MTNRS/microduck-v15/fabricacion/LISTA_IMPRESION_V15.csv

id | name | file | material | color | quantity | nozzle_mm | layer_height_mm | perimeters | infill_percent | raft_layers
P01 | V7_MOD_YAW2ROLL | STL_POR_COLORES\NEGRO_PETG\01_V7_MOD_YAW2ROLL.stl | PETG | NEGRO | 1 | 0.4 | 0.2 | 4 | 40 | 0
P02 | V7_MOD_HIP_L | STL_POR_COLORES\NEGRO_PETG\02_V7_MOD_HIP_L.stl | PETG | NEGRO | 1 | 0.4 | 0.2 | 4 | 40 | 0
P03 | V7_MOD_UPPER_LEG_LEFT | STL_POR_COLORES\AZUL_CIELO_PETG\03_V7_MOD_UPPER_LEG_LEFT.stl | PETG | AZUL_CIELO | 1 | 0.4 | 0.2 | 4 | 40 | 0
P04 | V7_MOD_LEG | STL_POR_COLORES\NEGRO_PETG\04_V7_MOD_LEG.stl | PETG | NEGRO | 1 | 0.4 | 0.2 | 4 | 40 | 0
P05 | V7_MOD_ANKLE_LEFT | STL_POR_COLORES\NEGRO_PETG\05_V7_MOD_ANKLE_LEFT.stl | PETG | NEGRO | 1 | 0.4 | 0.2 | 4 | 40 | 0
P06 | V7_MOD_NECK | STL_POR_COLORES\NEGRO_PETG\06_V7_MOD_NECK.stl | PETG | NEGRO | 1 | 0.4 | 0.2 | 4 | 40 | 0
P07 | V7_MOD_NECK_PITCH | STL_POR_COLORES\NEGRO_PETG\07_V7_MOD_NECK_PITCH.stl | PETG | NEGRO | 1 | 0.4 | 0.2 | 4 | 40 | 0
P08 | V7_MOD_YAW_ROLL_MOTION | STL_POR_COLORES\NEGRO_PETG\08_V7_MOD_YAW_ROLL_MOTION.stl | PETG | NEGRO | 1 | 0.4 | 0.2 | 4 | 40 | 0
P09 | V7_MOD_BEARING_ROLL | STL_POR_COLORES\NEGRO_PETG\09_V7_MOD_BEARING_ROLL.stl | PETG | NEGRO | 1 | 0.4 | 0.2 | 4 | 40 | 0
P10 | V7_MOD_HIP_L_2 | STL_POR_COLORES\NEGRO_PETG\10_V7_MOD_HIP_L_2.stl | PETG | NEGRO | 1 | 0.4 | 0.2 | 4 | 40 | 0
P11 | V7_MOD_UPPER_LEG_RIGHT | STL_POR_COLORES\AZUL_CIELO_PETG\11_V7_MOD_UPPER_LEG_RIGHT.stl | PETG | AZUL_CIELO | 1 | 0.4 | 0.2 | 4 | 40 | 0
P12 | V7_MOD_LEG_2 | STL_POR_COLORES\NEGRO_PETG\12_V7_MOD_LEG_2.stl | PETG | NEGRO | 1 | 0.4 | 0.2 | 4 | 40 | 0
P13 | V7_MOD_ANKLE_RIGHT | STL_POR_COLORES\NEGRO_PETG\13_V7_MOD_ANKLE_RIGHT.stl | PETG | NEGRO | 1 | 0.4 | 0.2 | 4 | 40 | 0
P14 | V7_TAPA_BRAZO_00 | STL_POR_COLORES\NEGRO_PETG\14_V7_TAPA_BRAZO_00.stl | PETG | NEGRO | 1 | 0.4 | 0.2 | 4 | 40 | 0
P15 | V7_TAPA_BRAZO_01 | STL_POR_COLORES\NEGRO_PETG\15_V7_TAPA_BRAZO_01.stl | PETG | NEGRO | 1 | 0.4 | 0.2 | 4 | 40 | 0
P16 | V7_TAPA_BRAZO_02 | STL_POR_COLORES\NEGRO_PETG\16_V7_TAPA_BRAZO_02.stl | PETG | NEGRO | 1 | 0.4 | 0.2 | 4 | 40 | 0
P17 | V7_TAPA_BRAZO_03 | STL_POR_COLORES\NEGRO_PETG\17_V7_TAPA_BRAZO_03.stl | PETG | NEGRO | 1 | 0.4 | 0.2 | 4 | 40 | 0
P18 | V7_TAPA_BRAZO_04 | STL_POR_COLORES\NEGRO_PETG\18_V7_TAPA_BRAZO_04.stl | PETG | NEGRO | 1 | 0.4 | 0.2 | 4 | 40 | 0
P19 | V7_TAPA_BRAZO_05 | STL_POR_COLORES\NEGRO_PETG\19_V7_TAPA_BRAZO_05.stl | PETG | NEGRO | 1 | 0.4 | 0.2 | 4 | 40 | 0
P20 | V7_TAPA_BRAZO_06 | STL_POR_COLORES\AZUL_CIELO_PETG\20_V7_TAPA_BRAZO_06.stl | PETG | AZUL_CIELO | 1 | 0.4 | 0.2 | 4 | 40 | 0
P21 | V7_TAPA_BRAZO_07 | STL_POR_COLORES\NEGRO_PETG\21_V7_TAPA_BRAZO_07.stl | PETG | NEGRO | 1 | 0.4 | 0.2 | 4 | 40 | 0
P22 | V7_TAPA_BRAZO_08 | STL_POR_COLORES\NEGRO_PETG\22_V7_TAPA_BRAZO_08.stl | PETG | NEGRO | 1 | 0.4 | 0.2 | 4 | 40 | 0
P23 | V7_TAPA_BRAZO_10 | STL_POR_COLORES\NEGRO_PETG\23_V7_TAPA_BRAZO_10.stl | PETG | NEGRO | 1 | 0.4 | 0.2 | 4 | 40 | 0
P24 | V7_TAPA_BRAZO_11 | STL_POR_COLORES\NEGRO_PETG\24_V7_TAPA_BRAZO_11.stl | PETG | NEGRO | 1 | 0.4 | 0.2 | 4 | 40 | 0
P25 | V7_TAPA_BRAZO_12 | STL_POR_COLORES\NEGRO_PETG\25_V7_TAPA_BRAZO_12.stl | PETG | NEGRO | 1 | 0.4 | 0.2 | 4 | 40 | 0
P26 | V7_TAPA_BRAZO_13 | STL_POR_COLORES\NEGRO_PETG\26_V7_TAPA_BRAZO_13.stl | PETG | NEGRO | 1 | 0.4 | 0.2 | 4 | 40 | 0
P27 | V7_TAPA_BRAZO_14 | STL_POR_COLORES\NEGRO_PETG\27_V7_TAPA_BRAZO_14.stl | PETG | NEGRO | 1 | 0.4 | 0.2 | 4 | 40 | 0
P28 | V7_TAPA_RODAMIENTO_CUELLO | STL_POR_COLORES\AZUL_CIELO_PETG\28_V7_TAPA_RODAMIENTO_CUELLO.stl | PETG | AZUL_CIELO | 1 | 0.4 | 0.2 | 4 | 40 | 0
P29 | V7_SEPARADOR_EJE_CUELLO | STL_POR_COLORES\NEGRO_PETG\29_V7_SEPARADOR_EJE_CUELLO.stl | PETG | NEGRO | 1 | 0.4 | 0.2 | 4 | 40 | 0
P30 | V7_RETENEDOR_PASIVO_HEADROLL | STL_POR_COLORES\NEGRO_PETG\30_V7_RETENEDOR_PASIVO_HEADROLL.stl | PETG | NEGRO | 1 | 0.4 | 0.2 | 4 | 40 | 0
P31 | V7_RETENEDOR_PASIVO_TOBILLO_05 | STL_POR_COLORES\NEGRO_PETG\31_V7_RETENEDOR_PASIVO_TOBILLO_05.stl | PETG | NEGRO | 1 | 0.4 | 0.2 | 4 | 40 | 0
P32 | V7_RETENEDOR_PASIVO_TOBILLO_14 | STL_POR_COLORES\NEGRO_PETG\32_V7_RETENEDOR_PASIVO_TOBILLO_14.stl | PETG | NEGRO | 1 | 0.4 | 0.2 | 4 | 40 | 0
P33 | V7_HEAD_TOP_ANCLADO | STL_POR_COLORES\AZUL_CIELO_PETG\33_V7_HEAD_TOP_ANCLADO.stl | PETG | AZUL_CIELO | 1 | 0.4 | 0.2 | 4 | 40 | 0
P34 | V7_HEAD_LOWER_ANCLADO | STL_POR_COLORES\NARANJA_PETG\34_V7_HEAD_LOWER_ANCLADO.stl | PETG | NARANJA | 1 | 0.4 | 0.2 | 4 | 40 | 0
P35 | V7_HEAD_FACE_ANCLADO | STL_POR_COLORES\GRIS_PETG\35_V7_HEAD_FACE_ANCLADO.stl | PETG | GRIS | 1 | 0.4 | 0.2 | 4 | 40 | 0
P36 | V7_HEAD_JAW_FIJO | STL_POR_COLORES\NARANJA_PETG\36_V7_HEAD_JAW_FIJO.stl | PETG | NARANJA | 1 | 0.4 | 0.2 | 4 | 40 | 0
P37 | V7_HEADCORE_ANCLADO | STL_POR_COLORES\NEGRO_PETG\37_V7_HEADCORE_ANCLADO.stl | PETG | NEGRO | 1 | 0.4 | 0.2 | 4 | 40 | 0
P38 | V7_HEAD_LIP_LOWER_RELIEVED | STL_POR_COLORES\NARANJA_TPU95A\38_V7_HEAD_LIP_LOWER_RELIEVED.stl | TPU95A | NARANJA | 1 | 0.4 | 0.2 | 3 | 20 | 0
P39 | V7_HEAD_LIP_UPPER_RELIEVED | STL_POR_COLORES\NARANJA_TPU95A\39_V7_HEAD_LIP_UPPER_RELIEVED.stl | TPU95A | NARANJA | 1 | 0.4 | 0.2 | 3 | 20 | 0
P40 | V7_EYE_RING_CLEARANCED | STL_POR_COLORES\AMARILLO_PETG\40_V7_EYE_RING_CLEARANCED.stl | PETG | AMARILLO | 1 | 0.4 | 0.2 | 4 | 40 | 0
P41 | V7_SRC_V4_MD_ankle_left__sole_left | STL_POR_COLORES\NEGRO_TPU_95A\41_V7_SRC_V4_MD_ankle_left__sole_left.stl | TPU_95A | NEGRO | 1 | 0.4 | 0.2 | 3 | 20 | 0
P42 | V7_SRC_V4_MD_ankle_right__sole_right | STL_POR_COLORES\NEGRO_TPU_95A\42_V7_SRC_V4_MD_ankle_right__sole_right.stl | TPU_95A | NEGRO | 1 | 0.4 | 0.2 | 3 | 20 | 0
P43 | V7_SRC_V5_PI_ZERO_BANDEJA_CON_ANCLAJES | STL_POR_COLORES\NEGRO_PETG\43_V7_SRC_V5_PI_ZERO_BANDEJA_CON_ANCLAJES.stl | PETG | NEGRO | 1 | 0.4 | 0.2 | 4 | 40 | 0
P44 | 12CASE_TORSO_CONTINUO | STL_POR_COLORES\AZUL_CIELO_PETG\44_12CASE_TORSO_CONTINUO.stl | PETG | AZUL_CIELO | 1 | 0.4 | 0.2 | 4 | 40 | 0
P45 | 12CASE_TAPA_TRASERA_ENRASADA | STL_POR_COLORES\AZUL_CIELO_PETG\45_12CASE_TAPA_TRASERA_ENRASADA.stl | PETG | AZUL_CIELO | 1 | 0.4 | 0.2 | 4 | 40 | 3
P46 | V15_SERVICE_FRONT_YAW2ROLL | STL_POR_COLORES\NEGRO_PETG\46_V15_SERVICE_FRONT_YAW2ROLL.stl | PETG | NEGRO | 1 | 0.4 | 0.2 | 4 | 40 | 0
P47 | V15_SERVICE_FRONT_UPPER_LEG_LEFT_0 | STL_POR_COLORES\AZUL_CIELO_PETG\47_V15_SERVICE_FRONT_UPPER_LEG_LEFT_0.stl | PETG | AZUL_CIELO | 1 | 0.4 | 0.2 | 4 | 40 | 0
P48 | V15_SERVICE_FRONT_YAW_ROLL_MOTION_0 | STL_POR_COLORES\NEGRO_PETG\48_V15_SERVICE_FRONT_YAW_ROLL_MOTION_0.stl | PETG | NEGRO | 1 | 0.4 | 0.2 | 4 | 40 | 0
P49 | V15_SERVICE_FRONT_JAW_SOFT | STL_POR_COLORES\NEGRO_PETG\49_V15_SERVICE_FRONT_JAW_SOFT.stl | PETG | NEGRO | 1 | 0.4 | 0.2 | 4 | 40 | 0
P50 | V15_SERVICE_FRONT_BEARING_ROLL | STL_POR_COLORES\NEGRO_PETG\50_V15_SERVICE_FRONT_BEARING_ROLL.stl | PETG | NEGRO | 1 | 0.4 | 0.2 | 4 | 40 | 0
P51 | V15_SERVICE_FRONT_UPPER_LEG_RIGHT_0 | STL_POR_COLORES\AZUL_CIELO_PETG\51_V15_SERVICE_FRONT_UPPER_LEG_RIGHT_0.stl | PETG | AZUL_CIELO | 1 | 0.4 | 0.2 | 4 | 40 | 0
P52 | V15_SERVICE_FRONT_TRUNK_BASE_0 | STL_POR_COLORES\AZUL_CIELO_PETG\52_V15_SERVICE_FRONT_TRUNK_BASE_0.stl | PETG | AZUL_CIELO | 1 | 0.4 | 0.2 | 4 | 40 | 0
P53 | V15_SERVICE_FRONT_TRUNK_BASE_1 | STL_POR_COLORES\AZUL_CIELO_PETG\53_V15_SERVICE_FRONT_TRUNK_BASE_1.stl | PETG | AZUL_CIELO | 1 | 0.4 | 0.2 | 4 | 40 | 0
P54 | V15_OJO_CIEGO_IMPRIMIBLE | STL_POR_COLORES\NEGRO_PETG\54_V15_OJO_CIEGO_IMPRIMIBLE.stl | PETG | NEGRO | 1 | 0.4 | 0.2 | 4 | 40 | 0
P55 | V15_FOOT_L_HEEL_ACTUADOR | STL_POR_COLORES\NEGRO_PETG\55_V15_FOOT_L_HEEL_ACTUADOR.stl | PETG | NEGRO | 1 | 0.4 | 0.2 | 4 | 40 | 0
P56 | V15_FOOT_L_TOE_ACTUADOR | STL_POR_COLORES\NEGRO_PETG\56_V15_FOOT_L_TOE_ACTUADOR.stl | PETG | NEGRO | 1 | 0.4 | 0.2 | 4 | 40 | 0
P57 | V15_FOOT_R_HEEL_ACTUADOR | STL_POR_COLORES\NEGRO_PETG\57_V15_FOOT_R_HEEL_ACTUADOR.stl | PETG | NEGRO | 1 | 0.4 | 0.2 | 4 | 40 | 0
P58 | V15_FOOT_R_TOE_ACTUADOR | STL_POR_COLORES\NEGRO_PETG\58_V15_FOOT_R_TOE_ACTUADOR.stl | PETG | NEGRO | 1 | 0.4 | 0.2 | 4 | 40 | 0
P59 | V15_FOOT_L_TAPA_CIRCUITO | STL_POR_COLORES\NEGRO_PETG\59_V15_FOOT_L_TAPA_CIRCUITO.stl | PETG | NEGRO | 1 | 0.4 | 0.2 | 4 | 40 | 0
P60 | V15_FOOT_R_TAPA_CIRCUITO | STL_POR_COLORES\NEGRO_PETG\60_V15_FOOT_R_TAPA_CIRCUITO.stl | PETG | NEGRO | 1 | 0.4 | 0.2 | 4 | 40 | 0
P61 | V15_K10_RETEN_DESMONTABLE | STL_POR_COLORES\NEGRO_PETG\61_V15_K10_RETEN_DESMONTABLE.stl | PETG | NEGRO | 1 | 0.4 | 0.2 | 4 | 40 | 0
P62 | V15_PCM_TOPE_DESMONTABLE | STL_POR_COLORES\NEGRO_PETG\62_V15_PCM_TOPE_DESMONTABLE.stl | PETG | NEGRO | 1 | 0.4 | 0.2 | 4 | 40 | 0
P63 | V15_REED_TAPA_PROTECTORA | STL_POR_COLORES\NEGRO_PETG\63_V15_REED_TAPA_PROTECTORA.stl | PETG | NEGRO | 1 | 0.4 | 0.2 | 4 | 40 | 0
P64 | V15_ADC_CARRIER_DESMONTABLE | STL_POR_COLORES\NEGRO_PETG\64_V15_ADC_CARRIER_DESMONTABLE.stl | PETG | NEGRO | 1 | 0.4 | 0.2 | 4 | 40 | 0
P65 | V15_D24_BANDEJA_INFERIOR_DESMONTABLE | STL_POR_COLORES\AZUL_CIELO_PETG\65_V15_D24_BANDEJA_INFERIOR_DESMONTABLE.stl | PETG | AZUL_CIELO | 1 | 0.4 | 0.2 | 4 | 40 | 3
P66 | V15_BM_FR4_CAP_R2 | STL_POR_COLORES\NEGRO_PETG\66_V15_BM_FR4_CAP_R2.stl | PETG | NEGRO | 1 | 0.4 | 0.2 | 4 | 40 | 0
P67 | V15_BM_FR4_KEY_R2 | STL_POR_COLORES\NEGRO_PETG\67_V15_BM_FR4_KEY_R2.stl | PETG | NEGRO | 1 | 0.4 | 0.2 | 4 | 40 | 0
P68 | V15_PCM_TOPE_DESMONTABLE_DERECHO | STL_POR_COLORES\NEGRO_PETG\68_V15_PCM_TOPE_DESMONTABLE_DERECHO.stl | PETG | NEGRO | 1 | 0.4 | 0.2 | 4 | 40 | 0
P69 | V15_HEADROLL_CHEEK_DESMONTABLE | STL_POR_COLORES\NEGRO_PETG\69_V15_HEADROLL_CHEEK_DESMONTABLE.stl | PETG | NEGRO | 1 | 0.4 | 0.2 | 4 | 40 | 0
P70 | V15_ET_RADIAL_CLAMP_00F | STL_POR_COLORES\NEGRO_PETG\70_V15_ET_RADIAL_CLAMP_00F.stl | PETG | NEGRO | 1 | 0.4 | 0.2 | 4 | 40 | 0
P71 | V15_ET_RADIAL_CLAMP_01F | STL_POR_COLORES\NEGRO_PETG\71_V15_ET_RADIAL_CLAMP_01F.stl | PETG | NEGRO | 1 | 0.4 | 0.2 | 4 | 40 | 0
P72 | V15_ET_RADIAL_CLAMP_02F | STL_POR_COLORES\NEGRO_PETG\72_V15_ET_RADIAL_CLAMP_02F.stl | PETG | NEGRO | 1 | 0.4 | 0.2 | 4 | 40 | 0
P73 | V15_ET_RADIAL_CLAMP_03F | STL_POR_COLORES\NEGRO_PETG\73_V15_ET_RADIAL_CLAMP_03F.stl | PETG | NEGRO | 1 | 0.4 | 0.2 | 4 | 40 | 0
P74 | V15_ET_RADIAL_CLAMP_11F | STL_POR_COLORES\NEGRO_PETG\74_V15_ET_RADIAL_CLAMP_11F.stl | PETG | NEGRO | 1 | 0.4 | 0.2 | 4 | 40 | 0
P75 | V15_ET_RADIAL_CLAMP_12F | STL_POR_COLORES\NEGRO_PETG\75_V15_ET_RADIAL_CLAMP_12F.stl | PETG | NEGRO | 1 | 0.4 | 0.2 | 4 | 40 | 0
P76 | V15_ET_RADIAL_CLAMP_04F | STL_POR_COLORES\NEGRO_PETG\76_V15_ET_RADIAL_CLAMP_04F.stl | PETG | NEGRO | 1 | 0.4 | 0.2 | 4 | 40 | 0
P77 | V15_ET_RADIAL_CLAMP_10F | STL_POR_COLORES\NEGRO_PETG\77_V15_ET_RADIAL_CLAMP_10F.stl | PETG | NEGRO | 1 | 0.4 | 0.2 | 4 | 40 | 0
P78 | V15_ET_RADIAL_CLAMP_13F | STL_POR_COLORES\NEGRO_PETG\78_V15_ET_RADIAL_CLAMP_13F.stl | PETG | NEGRO | 1 | 0.4 | 0.2 | 4 | 40 | 0
P79 | V15_ET_RADIAL_CLAMP_08F | STL_POR_COLORES\NEGRO_PETG\79_V15_ET_RADIAL_CLAMP_08F.stl | PETG | NEGRO | 1 | 0.4 | 0.2 | 4 | 40 | 0
P80 | V15_6701_RADIAL_CLAMP_10R | STL_POR_COLORES\NEGRO_PETG\80_V15_6701_RADIAL_CLAMP_10R.stl | PETG | NEGRO | 1 | 0.4 | 0.2 | 4 | 40 | 0
