MTNRS/microduck-v15/fabricacion/DOCUMENTACION/TORNILLERIA/TORNILLERIA_FUENTE_A_CONTENIDO_V15.csv

source_name | source_sha256 | category | item | quantity | dimensions_or_limit | preparation | source_url | supplier_status
V12_HW_CASE_CLOSURE_00 | 99711498d1d0ec2f1643ecb6f8c0d19c25be85364ed06c2158a1b49698067734 | SCREW | M2x25 | 1 | headOD<=4 h<=1.6 |  |  | Especificacion dimensional; proveedor por confirmar
V12_HW_CASE_CLOSURE_00 | 99711498d1d0ec2f1643ecb6f8c0d19c25be85364ed06c2158a1b49698067734 | NUT | M2 AF4 h1.6 | 1 |  |  |  | Especificacion dimensional; proveedor por confirmar
V12_HW_CASE_CLOSURE_00 | 99711498d1d0ec2f1643ecb6f8c0d19c25be85364ed06c2158a1b49698067734 | WASHER | OD4.3 ID2.2 h0.3 | 1 |  |  |  | Especificacion dimensional; proveedor por confirmar
V12_HW_CASE_CLOSURE_01 | af7fb67f0b9e2c49c6317c66d189983a6ab191507d181d2a0959832b0bed2678 | SCREW | M2x25 | 1 | headOD<=4 h<=1.6 |  |  | Especificacion dimensional; proveedor por confirmar
V12_HW_CASE_CLOSURE_01 | af7fb67f0b9e2c49c6317c66d189983a6ab191507d181d2a0959832b0bed2678 | NUT | M2 AF4 h1.6 | 1 |  |  |  | Especificacion dimensional; proveedor por confirmar
V12_HW_CASE_CLOSURE_01 | af7fb67f0b9e2c49c6317c66d189983a6ab191507d181d2a0959832b0bed2678 | WASHER | OD4.3 ID2.2 h0.3 | 1 |  |  |  | Especificacion dimensional; proveedor por confirmar
V12_HW_CASE_CLOSURE_02 | 3b68d0e60894e7b5ef612ba7a495937365d09641602007265e7909e895bd9539 | SCREW | M2x25 | 1 | headOD<=4 h<=1.6 |  |  | Especificacion dimensional; proveedor por confirmar
V12_HW_CASE_CLOSURE_02 | 3b68d0e60894e7b5ef612ba7a495937365d09641602007265e7909e895bd9539 | NUT | M2 AF4 h1.6 | 1 |  |  |  | Especificacion dimensional; proveedor por confirmar
V12_HW_CASE_CLOSURE_02 | 3b68d0e60894e7b5ef612ba7a495937365d09641602007265e7909e895bd9539 | WASHER | OD4.3 ID2.2 h0.3 | 1 |  |  |  | Especificacion dimensional; proveedor por confirmar
V12_HW_CASE_CLOSURE_03 | faebaa76a23396d1173fec0bf9c24cd7a66a93c2123987e66e0dad0f900eec77 | SCREW | M2x25 | 1 | headOD<=4 h<=1.6 |  |  | Especificacion dimensional; proveedor por confirmar
V12_HW_CASE_CLOSURE_03 | faebaa76a23396d1173fec0bf9c24cd7a66a93c2123987e66e0dad0f900eec77 | NUT | M2 AF4 h1.6 | 1 |  |  |  | Especificacion dimensional; proveedor por confirmar
V12_HW_CASE_CLOSURE_03 | faebaa76a23396d1173fec0bf9c24cd7a66a93c2123987e66e0dad0f900eec77 | WASHER | OD4.3 ID2.2 h0.3 | 1 |  |  |  | Especificacion dimensional; proveedor por confirmar
V15_EYE_REAR_NUT_0 | dee2fe31ff005fafb51f0c66a1e8032b57aa39dae5ab1d344c9b9d4c7d3fa99a | NUT | M2 AF4 h1.6 | 1 |  |  |  | Especificacion dimensional; proveedor por confirmar
V15_EYE_REAR_NUT_1 | 38273af5bb4fc0129a6dbf5738df33770433eac7903097706e2a3bc93b06103d | NUT | M2 AF4 h1.6 | 1 |  |  |  | Especificacion dimensional; proveedor por confirmar
V15_EYE_REAR_WASHER_0 | 1af8188889be748cda065a39434545f6e7d99c5c5cf95599802ff84af8a7ea80 | WASHER | OD5 ID2.2 h0.3 | 1 |  |  |  | Especificacion dimensional; proveedor por confirmar
V15_EYE_REAR_WASHER_1 | 20814c5789e996e1f587ed0d741dcf3acefdfc7ae92479f8826aaa95bc5e8d6a | WASHER | OD5 ID2.2 h0.3 | 1 |  |  |  | Especificacion dimensional; proveedor por confirmar
V15_HW_6701CLAMP_10R_0_M2x11_ASSY | d43dac42ab0dfc2bf1aad3175ecb1b4b45de01b0605848ae4bce871ecacb86dd | SCREW | M2x11 | 1 | M2x11 socket screw prepared from12; {"length_under_head_mm": 11.0, "head_diameter_max_mm": 4.0, "head_height_max_mm": 2.0} | Cut standard M2x12 under-head length to11.0mm; deburr |  | Especificacion dimensional; proveedor por confirmar
V15_HW_6701CLAMP_10R_0_M2x11_ASSY | d43dac42ab0dfc2bf1aad3175ecb1b4b45de01b0605848ae4bce871ecacb86dd | NUT | M2 AF4 h1.6 | 1 | M2 nut AF4 h1.6 |  |  | Especificacion dimensional; proveedor por confirmar
V15_HW_6701CLAMP_10R_0_M2x11_ASSY | d43dac42ab0dfc2bf1aad3175ecb1b4b45de01b0605848ae4bce871ecacb86dd | WASHER | washer OD4.3 ID2.2 h0.3 | 2 | washer OD4.3 ID2.2 h0.3 |  |  | Especificacion dimensional; proveedor por confirmar
V15_HW_6701CLAMP_10R_1_M2x11_ASSY | 3588c896a5987c8674ec75a3de937ec692060b0b67d68f3eb6dcb934a01b1a71 | SCREW | M2x11 | 1 | M2x11 socket screw prepared from12; {"length_under_head_mm": 11.0, "head_diameter_max_mm": 4.0, "head_height_max_mm": 2.0} | Cut standard M2x12 under-head length to11.0mm; deburr |  | Especificacion dimensional; proveedor por confirmar
V15_HW_6701CLAMP_10R_1_M2x11_ASSY | 3588c896a5987c8674ec75a3de937ec692060b0b67d68f3eb6dcb934a01b1a71 | NUT | M2 AF4 h1.6 | 1 | M2 nut AF4 h1.6 |  |  | Especificacion dimensional; proveedor por confirmar
V15_HW_6701CLAMP_10R_1_M2x11_ASSY | 3588c896a5987c8674ec75a3de937ec692060b0b67d68f3eb6dcb934a01b1a71 | WASHER | washer OD4.3 ID2.2 h0.3 | 2 | washer OD4.3 ID2.2 h0.3 |  |  | Especificacion dimensional; proveedor por confirmar
V15_HW_ADC_DRIVER_M2x8_0 | 4ad36503498866e5c3c151920923b36549453d797130513ded3ffc2ee87abdb4 | SCREW | M2x8 | 1 | screw_M2x8; {} |  |  | Especificacion dimensional; proveedor por confirmar
V15_HW_ADC_DRIVER_M2x8_0 | 4ad36503498866e5c3c151920923b36549453d797130513ded3ffc2ee87abdb4 | NUT | M2 AF4 h1.6 | 1 | nut_M2_AF4_h1p6 |  |  | Especificacion dimensional; proveedor por confirmar
V15_HW_ADC_DRIVER_M2x8_0 | 4ad36503498866e5c3c151920923b36549453d797130513ded3ffc2ee87abdb4 | WASHER | washer_OD4p3_ID2p15_h0p3 | 2 | washer_OD4p3_ID2p15_h0p3 |  |  | Especificacion dimensional; proveedor por confirmar
V15_HW_ADC_DRIVER_M2x8_1 | 78cd083028ad7ab88daa2c4de93f7a33d6a8a5ef2d291bd6fd9768db07503348 | SCREW | M2x8 | 1 | screw_M2x8; {} |  |  | Especificacion dimensional; proveedor por confirmar
V15_HW_ADC_DRIVER_M2x8_1 | 78cd083028ad7ab88daa2c4de93f7a33d6a8a5ef2d291bd6fd9768db07503348 | NUT | M2 AF4 h1.6 | 1 | nut_M2_AF4_h1p6 |  |  | Especificacion dimensional; proveedor por confirmar
V15_HW_ADC_DRIVER_M2x8_1 | 78cd083028ad7ab88daa2c4de93f7a33d6a8a5ef2d291bd6fd9768db07503348 | WASHER | washer_OD4p3_ID2p15_h0p3 | 2 | washer_OD4p3_ID2p15_h0p3 |  |  | Especificacion dimensional; proveedor por confirmar
V15_HW_ADS1115_M2x8_0 | b7052d4a2be9136f5405446d81c69447e06e9b821af865a3a60d93197827851a | SCREW | M2x8 | 1 | screw_M2x8; {} |  |  | Especificacion dimensional; proveedor por confirmar
V15_HW_ADS1115_M2x8_0 | b7052d4a2be9136f5405446d81c69447e06e9b821af865a3a60d93197827851a | NUT | M2 AF4 h1.6 | 1 | nut_M2_AF4_h1p6 |  |  | Especificacion dimensional; proveedor por confirmar
V15_HW_ADS1115_M2x8_0 | b7052d4a2be9136f5405446d81c69447e06e9b821af865a3a60d93197827851a | WASHER | washer_OD4p3_ID2p15_h0p3 | 2 | washer_OD4p3_ID2p15_h0p3 |  |  | Especificacion dimensional; proveedor por confirmar
V15_HW_ADS1115_M2x8_1 | c43fdcf8429e1ff2673f1dc3de76c79952d6ea01775f0f1a9c810fda1bd8cf55 | SCREW | M2x8 | 1 | screw_M2x8; {} |  |  | Especificacion dimensional; proveedor por confirmar
V15_HW_ADS1115_M2x8_1 | c43fdcf8429e1ff2673f1dc3de76c79952d6ea01775f0f1a9c810fda1bd8cf55 | NUT | M2 AF4 h1.6 | 1 | nut_M2_AF4_h1p6 |  |  | Especificacion dimensional; proveedor por confirmar
V15_HW_ADS1115_M2x8_1 | c43fdcf8429e1ff2673f1dc3de76c79952d6ea01775f0f1a9c810fda1bd8cf55 | WASHER | washer_OD4p3_ID2p15_h0p3 | 2 | washer_OD4p3_ID2p15_h0p3 |  |  | Especificacion dimensional; proveedor por confirmar
V15_HW_ADS1115_M2x8_2 | 3b7055ec348e3a38d85cc0c97c13ffb01ab8fa2f7a6fd52f622e26709b38d1d5 | SCREW | M2x8 | 1 | screw_M2x8_head_OD_le4_h_le1p6; {} |  |  | Especificacion dimensional; proveedor por confirmar
V15_HW_ADS1115_M2x8_2 | 3b7055ec348e3a38d85cc0c97c13ffb01ab8fa2f7a6fd52f622e26709b38d1d5 | NUT | M2 AF4 h1.6 | 1 | nut_M2_AF4_h1p6 |  |  | Especificacion dimensional; proveedor por confirmar
V15_HW_ADS1115_M2x8_2 | 3b7055ec348e3a38d85cc0c97c13ffb01ab8fa2f7a6fd52f622e26709b38d1d5 | WASHER | washer_OD4p3_ID2p15_h0p3 | 2 | washer_OD4p3_ID2p15_h0p3 |  |  | Especificacion dimensional; proveedor por confirmar
V15_HW_ADS1115_M2x8_3 | 27ee051498474f6f9055bbcbf377fb60797b7db1c456934812d646d9b211e61d | SCREW | M2x8 | 1 | screw_M2x8_head_OD_le4_h_le1p6; {} |  |  | Especificacion dimensional; proveedor por confirmar
V15_HW_ADS1115_M2x8_3 | 27ee051498474f6f9055bbcbf377fb60797b7db1c456934812d646d9b211e61d | NUT | M2 AF4 h1.6 | 1 | nut_M2_AF4_h1p6 |  |  | Especificacion dimensional; proveedor por confirmar
V15_HW_ADS1115_M2x8_3 | 27ee051498474f6f9055bbcbf377fb60797b7db1c456934812d646d9b211e61d | WASHER | washer_OD4p3_ID2p15_h0p3 | 2 | washer_OD4p3_ID2p15_h0p3 |  |  | Especificacion dimensional; proveedor por confirmar
V15_HW_BM_SSH_M2x8 | f6d4c1873d0f9b2c060119eb2b3d3f9fc6d3aaccc9b95bfb9878e19febd86cb3 | SCREW | M2x8 NBK SSH-M2-8 | 1 | SSH-M2-8; {"head_D_mm": 4.0, "head_H_mm": 1.1, "underhead_length_mm": 8.0} |  |  | Especificacion dimensional; proveedor por confirmar
V15_HW_BM_SSH_M2x8 | f6d4c1873d0f9b2c060119eb2b3d3f9fc6d3aaccc9b95bfb9878e19febd86cb3 | NUT | M2 AF4 h1.6 | 1 | M2nutAF4h1.6 |  |  | Especificacion dimensional; proveedor por confirmar
V15_HW_BM_SSH_M2x8 | f6d4c1873d0f9b2c060119eb2b3d3f9fc6d3aaccc9b95bfb9878e19febd86cb3 | WASHER | M2washerOD4.3h0.3 | 1 | M2washerOD4.3h0.3 |  |  | Especificacion dimensional; proveedor por confirmar
V15_HW_D24_TRAY_M2x8_0 | 17b1ea9cd0454ac9f3d517c0f519e9c5bf474bf7fc592b52e76880b0bc932b6b | SCREW | M2x8 | 1 | screw_M2x8_head_OD_le4_h_le1p6; {} |  |  | Especificacion dimensional; proveedor por confirmar
V15_HW_D24_TRAY_M2x8_0 | 17b1ea9cd0454ac9f3d517c0f519e9c5bf474bf7fc592b52e76880b0bc932b6b | NUT | M2 AF4 h1.6 | 1 | nut_M2_AF4_h1p6 |  |  | Especificacion dimensional; proveedor por confirmar
V15_HW_D24_TRAY_M2x8_0 | 17b1ea9cd0454ac9f3d517c0f519e9c5bf474bf7fc592b52e76880b0bc932b6b | WASHER | washer_OD4p3_ID2p15_h0p3 | 2 | washer_OD4p3_ID2p15_h0p3 |  |  | Especificacion dimensional; proveedor por confirmar
V15_HW_D24_TRAY_M2x8_1 | 871f68428ef170aa3eaffbda0f7851f54b3247b8063505e0596c0155b72ac00d | SCREW | M2x8 | 1 | screw_M2x8_head_OD_le4_h_le1p6; {} |  |  | Especificacion dimensional; proveedor por confirmar
V15_HW_D24_TRAY_M2x8_1 | 871f68428ef170aa3eaffbda0f7851f54b3247b8063505e0596c0155b72ac00d | NUT | M2 AF4 h1.6 | 1 | nut_M2_AF4_h1p6 |  |  | Especificacion dimensional; proveedor por confirmar
V15_HW_D24_TRAY_M2x8_1 | 871f68428ef170aa3eaffbda0f7851f54b3247b8063505e0596c0155b72ac00d | WASHER | washer_OD4p3_ID2p15_h0p3 | 2 | washer_OD4p3_ID2p15_h0p3 |  |  | Especificacion dimensional; proveedor por confirmar
V15_HW_ETCLAMP_00F_0_M2x12_ASSY | 39260ac4edff9109a84b04794623c0ed39cce0df2493d0fb8c8d56f748648fdb | SCREW | M2x12 | 1 | M2x12 socket screw; {"length_under_head_mm": 12.0, "head_diameter_max_mm": 4.0, "head_height_max_mm": 2.0} |  |  | Especificacion dimensional; proveedor por confirmar
V15_HW_ETCLAMP_00F_0_M2x12_ASSY | 39260ac4edff9109a84b04794623c0ed39cce0df2493d0fb8c8d56f748648fdb | NUT | M2 AF4 h1.6 | 1 | M2 nut AF4 h1.6 |  |  | Especificacion dimensional; proveedor por confirmar
V15_HW_ETCLAMP_00F_0_M2x12_ASSY | 39260ac4edff9109a84b04794623c0ed39cce0df2493d0fb8c8d56f748648fdb | WASHER | washer OD4.3 ID2.2 h0.3 | 2 | washer OD4.3 ID2.2 h0.3 |  |  | Especificacion dimensional; proveedor por confirmar
V15_HW_ETCLAMP_00F_1_M2x12_ASSY | 818e418a1a510cc406979d2e37767ff3640f5f86982fe2d03286a5cd40b34333 | SCREW | M2x12 | 1 | M2x12 socket screw; {"length_under_head_mm": 12.0, "head_diameter_max_mm": 4.0, "head_height_max_mm": 2.0} |  |  | Especificacion dimensional; proveedor por confirmar
V15_HW_ETCLAMP_00F_1_M2x12_ASSY | 818e418a1a510cc406979d2e37767ff3640f5f86982fe2d03286a5cd40b34333 | NUT | M2 AF4 h1.6 | 1 | M2 nut AF4 h1.6 |  |  | Especificacion dimensional; proveedor por confirmar
V15_HW_ETCLAMP_00F_1_M2x12_ASSY | 818e418a1a510cc406979d2e37767ff3640f5f86982fe2d03286a5cd40b34333 | WASHER | washer OD4.3 ID2.2 h0.3 | 2 | washer OD4.3 ID2.2 h0.3 |  |  | Especificacion dimensional; proveedor por confirmar
V15_HW_ETCLAMP_01F_0_M2x12_ASSY | 0853021ca96cc0146a58bc4b6a8089d2dc9e22725493cd842dec1718d441b475 | SCREW | M2x12 | 1 | M2x12 socket screw; {"length_under_head_mm": 12.0, "head_diameter_max_mm": 4.0, "head_height_max_mm": 2.0} |  |  | Especificacion dimensional; proveedor por confirmar
V15_HW_ETCLAMP_01F_0_M2x12_ASSY | 0853021ca96cc0146a58bc4b6a8089d2dc9e22725493cd842dec1718d441b475 | NUT | M2 AF4 h1.6 | 1 | M2 nut AF4 h1.6 |  |  | Especificacion dimensional; proveedor por confirmar
V15_HW_ETCLAMP_01F_0_M2x12_ASSY | 0853021ca96cc0146a58bc4b6a8089d2dc9e22725493cd842dec1718d441b475 | WASHER | washer OD4.3 ID2.2 h0.3 | 2 | washer OD4.3 ID2.2 h0.3 |  |  | Especificacion dimensional; proveedor por confirmar
V15_HW_ETCLAMP_01F_1_M2x12_ASSY | 61eaf5a3244fad1a48e948142b1b7fe62cdc1e223cddb6061562f1e9c1d13e75 | SCREW | M2x12 | 1 | M2x12 socket screw; {"length_under_head_mm": 12.0, "head_diameter_max_mm": 4.0, "head_height_max_mm": 2.0} |  |  | Especificacion dimensional; proveedor por confirmar
V15_HW_ETCLAMP_01F_1_M2x12_ASSY | 61eaf5a3244fad1a48e948142b1b7fe62cdc1e223cddb6061562f1e9c1d13e75 | NUT | M2 AF4 h1.6 | 1 | M2 nut AF4 h1.6 |  |  | Especificacion dimensional; proveedor por confirmar
V15_HW_ETCLAMP_01F_1_M2x12_ASSY | 61eaf5a3244fad1a48e948142b1b7fe62cdc1e223cddb6061562f1e9c1d13e75 | WASHER | washer OD4.3 ID2.2 h0.3 | 2 | washer OD4.3 ID2.2 h0.3 |  |  | Especificacion dimensional; proveedor por confirmar
V15_HW_ETCLAMP_02F_0_M2x12_ASSY | c26a35993a713b22691048ed87de6b73502df0115a6e7f47891298c016dfc726 | SCREW | M2x12 | 1 | M2x12 socket screw; {"length_under_head_mm": 12.0, "head_diameter_max_mm": 4.0, "head_height_max_mm": 2.0} |  |  | Especificacion dimensional; proveedor por confirmar
V15_HW_ETCLAMP_02F_0_M2x12_ASSY | c26a35993a713b22691048ed87de6b73502df0115a6e7f47891298c016dfc726 | NUT | M2 AF4 h1.6 | 1 | M2 nut AF4 h1.6 |  |  | Especificacion dimensional; proveedor por confirmar
V15_HW_ETCLAMP_02F_0_M2x12_ASSY | c26a35993a713b22691048ed87de6b73502df0115a6e7f47891298c016dfc726 | WASHER | washer OD4.3 ID2.2 h0.3 | 2 | washer OD4.3 ID2.2 h0.3 |  |  | Especificacion dimensional; proveedor por confirmar
V15_HW_ETCLAMP_02F_1_M2x12_ASSY | 074cd8229b2f064d2c85c58b9e4076b5e98dc91c13059dd6b2011bf524980afd | SCREW | M2x12 | 1 | M2x12 socket screw; {"length_under_head_mm": 12.0, "head_diameter_max_mm": 4.0, "head_height_max_mm": 2.0} |  |  | Especificacion dimensional; proveedor por confirmar
V15_HW_ETCLAMP_02F_1_M2x12_ASSY | 074cd8229b2f064d2c85c58b9e4076b5e98dc91c13059dd6b2011bf524980afd | NUT | M2 AF4 h1.6 | 1 | M2 nut AF4 h1.6 |  |  | Especificacion dimensional; proveedor por confirmar
V15_HW_ETCLAMP_02F_1_M2x12_ASSY | 074cd8229b2f064d2c85c58b9e4076b5e98dc91c13059dd6b2011bf524980afd | WASHER | washer OD4.3 ID2.2 h0.3 | 2 | washer OD4.3 ID2.2 h0.3 |  |  | Especificacion dimensional; proveedor por confirmar
V15_HW_ETCLAMP_03F_0_M2x12_ASSY | 05c33ea0a65ee7db1a22fbf4d7e46230ab5626c2218231a76048d929308b987a | SCREW | M2x12 | 1 | M2x12 socket screw; {"length_under_head_mm": 12.0, "head_diameter_max_mm": 4.0, "head_height_max_mm": 2.0} |  |  | Especificacion dimensional; proveedor por confirmar
V15_HW_ETCLAMP_03F_0_M2x12_ASSY | 05c33ea0a65ee7db1a22fbf4d7e46230ab5626c2218231a76048d929308b987a | NUT | M2 AF4 h1.6 | 1 | M2 nut AF4 h1.6 |  |  | Especificacion dimensional; proveedor por confirmar
V15_HW_ETCLAMP_03F_0_M2x12_ASSY | 05c33ea0a65ee7db1a22fbf4d7e46230ab5626c2218231a76048d929308b987a | WASHER | washer OD4.3 ID2.2 h0.3 | 2 | washer OD4.3 ID2.2 h0.3 |  |  | Especificacion dimensional; proveedor por confirmar
V15_HW_ETCLAMP_03F_1_M2x12_ASSY | 45ad6a51d49c8c65a022976124e6e58b925bbeb4972d966b56d763f46bfdc3c0 | SCREW | M2x12 | 1 | M2x12 socket screw; {"length_under_head_mm": 12.0, "head_diameter_max_mm": 4.0, "head_height_max_mm": 2.0} |  |  | Especificacion dimensional; proveedor por confirmar
V15_HW_ETCLAMP_03F_1_M2x12_ASSY | 45ad6a51d49c8c65a022976124e6e58b925bbeb4972d966b56d763f46bfdc3c0 | NUT | M2 AF4 h1.6 | 1 | M2 nut AF4 h1.6 |  |  | Especificacion dimensional; proveedor por confirmar
V15_HW_ETCLAMP_03F_1_M2x12_ASSY | 45ad6a51d49c8c65a022976124e6e58b925bbeb4972d966b56d763f46bfdc3c0 | WASHER | washer OD4.3 ID2.2 h0.3 | 2 | washer OD4.3 ID2.2 h0.3 |  |  | Especificacion dimensional; proveedor por confirmar
V15_HW_ETCLAMP_04F_0_M2x12_ASSY | feeaf4f30e351aec944465bf841a5665bab3ef425a2af42ee34fb74133b6d63f | SCREW | M2x12 | 1 | M2x12 socket screw; {"length_under_head_mm": 12.0, "head_diameter_max_mm": 4.0, "head_height_max_mm": 2.0} |  |  | Especificacion dimensional; proveedor por confirmar
V15_HW_ETCLAMP_04F_0_M2x12_ASSY | feeaf4f30e351aec944465bf841a5665bab3ef425a2af42ee34fb74133b6d63f | NUT | M2 AF4 h1.6 | 1 | M2 nut AF4 h1.6 |  |  | Especificacion dimensional; proveedor por confirmar
V15_HW_ETCLAMP_04F_0_M2x12_ASSY | feeaf4f30e351aec944465bf841a5665bab3ef425a2af42ee34fb74133b6d63f | WASHER | washer OD4.3 ID2.2 h0.3 | 2 | washer OD4.3 ID2.2 h0.3 |  |  | Especificacion dimensional; proveedor por confirmar
V15_HW_ETCLAMP_04F_1_M2x12_ASSY | b05208b2035dc31b6a5c01021dd7965b0003beeff1a8e42ef7b63c76b6c5e723 | SCREW | M2x12 | 1 | M2x12 socket screw; {"length_under_head_mm": 12.0, "head_diameter_max_mm": 4.0, "head_height_max_mm": 2.0} |  |  | Especificacion dimensional; proveedor por confirmar
V15_HW_ETCLAMP_04F_1_M2x12_ASSY | b05208b2035dc31b6a5c01021dd7965b0003beeff1a8e42ef7b63c76b6c5e723 | NUT | M2 AF4 h1.6 | 1 | M2 nut AF4 h1.6 |  |  | Especificacion dimensional; proveedor por confirmar
V15_HW_ETCLAMP_04F_1_M2x12_ASSY | b05208b2035dc31b6a5c01021dd7965b0003beeff1a8e42ef7b63c76b6c5e723 | WASHER | washer OD4.3 ID2.2 h0.3 | 2 | washer OD4.3 ID2.2 h0.3 |  |  | Especificacion dimensional; proveedor por confirmar
V15_HW_ETCLAMP_08F_0_M2x12_ASSY | 37b4d6e0dafef63059c72b6c7a5fc1f7de5537897599d26121f1d5647750fd27 | SCREW | M2x11 | 1 | M2x11 socket screw prepared from12; {"length_under_head_mm": 11.0, "head_diameter_max_mm": 4.0, "head_height_max_mm": 2.0} | Preparar desdeM2x12;longitudbajocabeza11mm,desbarbar |  | Especificacion dimensional; proveedor por confirmar
V15_HW_ETCLAMP_08F_0_M2x12_ASSY | 37b4d6e0dafef63059c72b6c7a5fc1f7de5537897599d26121f1d5647750fd27 | NUT | M2 AF4 h1.6 | 1 | M2 nut AF4 h1.6 |  |  | Especificacion dimensional; proveedor por confirmar
V15_HW_ETCLAMP_08F_0_M2x12_ASSY | 37b4d6e0dafef63059c72b6c7a5fc1f7de5537897599d26121f1d5647750fd27 | WASHER | washer OD4.3 ID2.2 h0.3 | 2 | washer OD4.3 ID2.2 h0.3 |  |  | Especificacion dimensional; proveedor por confirmar
V15_HW_ETCLAMP_08F_1_M2x12_ASSY | 5b66177a002ca3bd42628024c7aab1348fa5521e138de410a80f6c06f998e6bd | SCREW | M2x11 | 1 | M2x11 socket screw prepared from12; {"length_under_head_mm": 11.0, "head_diameter_max_mm": 4.0, "head_height_max_mm": 2.0} | Preparar desdeM2x12;longitudbajocabeza11mm,desbarbar |  | Especificacion dimensional; proveedor por confirmar
V15_HW_ETCLAMP_08F_1_M2x12_ASSY | 5b66177a002ca3bd42628024c7aab1348fa5521e138de410a80f6c06f998e6bd | NUT | M2 AF4 h1.6 | 1 | M2 nut AF4 h1.6 |  |  | Especificacion dimensional; proveedor por confirmar
V15_HW_ETCLAMP_08F_1_M2x12_ASSY | 5b66177a002ca3bd42628024c7aab1348fa5521e138de410a80f6c06f998e6bd | WASHER | washer OD4.3 ID2.2 h0.3 | 2 | washer OD4.3 ID2.2 h0.3 |  |  | Especificacion dimensional; proveedor por confirmar
V15_HW_ETCLAMP_10F_0_M2x12_ASSY | e264e5901dd2eb26ad0d85c8ca4b63e8000c4d8c386b74af00b310d439a0e8fb | SCREW | M2x11 | 1 | M2x11 socket screw prepared from12; {"length_under_head_mm": 11.0, "head_diameter_max_mm": 4.0, "head_height_max_mm": 2.0} | Preparar desdeM2x12;longitudbajocabeza11mm,desbarbar |  | Especificacion dimensional; proveedor por confirmar
V15_HW_ETCLAMP_10F_0_M2x12_ASSY | e264e5901dd2eb26ad0d85c8ca4b63e8000c4d8c386b74af00b310d439a0e8fb | NUT | M2 AF4 h1.6 | 1 | M2 nut AF4 h1.6 |  |  | Especificacion dimensional; proveedor por confirmar
V15_HW_ETCLAMP_10F_0_M2x12_ASSY | e264e5901dd2eb26ad0d85c8ca4b63e8000c4d8c386b74af00b310d439a0e8fb | WASHER | washer OD4.3 ID2.2 h0.3 | 2 | washer OD4.3 ID2.2 h0.3 |  |  | Especificacion dimensional; proveedor por confirmar
V15_HW_ETCLAMP_10F_1_M2x12_ASSY | 679e15e6423297017ffa995bb2810f43ceaeb7a2bc2ee1bc178a8ec8738262ae | SCREW | M2x11 | 1 | M2x11 socket screw prepared from12; {"length_under_head_mm": 11.0, "head_diameter_max_mm": 4.0, "head_height_max_mm": 2.0} | Preparar desdeM2x12;longitudbajocabeza11mm,desbarbar |  | Especificacion dimensional; proveedor por confirmar
V15_HW_ETCLAMP_10F_1_M2x12_ASSY | 679e15e6423297017ffa995bb2810f43ceaeb7a2bc2ee1bc178a8ec8738262ae | NUT | M2 AF4 h1.6 | 1 | M2 nut AF4 h1.6 |  |  | Especificacion dimensional; proveedor por confirmar
V15_HW_ETCLAMP_10F_1_M2x12_ASSY | 679e15e6423297017ffa995bb2810f43ceaeb7a2bc2ee1bc178a8ec8738262ae | WASHER | washer OD4.3 ID2.2 h0.3 | 2 | washer OD4.3 ID2.2 h0.3 |  |  | Especificacion dimensional; proveedor por confirmar
V15_HW_ETCLAMP_11F_0_M2x12_ASSY | c3b7e5c4490b35f10025e757db0304fae1d26b361c6cc4e3c4bdda30d912f6f5 | SCREW | M2x12 | 1 | M2x12 socket screw; {"length_under_head_mm": 12.0, "head_diameter_max_mm": 4.0, "head_height_max_mm": 2.0} |  |  | Especificacion dimensional; proveedor por confirmar
V15_HW_ETCLAMP_11F_0_M2x12_ASSY | c3b7e5c4490b35f10025e757db0304fae1d26b361c6cc4e3c4bdda30d912f6f5 | NUT | M2 AF4 h1.6 | 1 | M2 nut AF4 h1.6 |  |  | Especificacion dimensional; proveedor por confirmar
V15_HW_ETCLAMP_11F_0_M2x12_ASSY | c3b7e5c4490b35f10025e757db0304fae1d26b361c6cc4e3c4bdda30d912f6f5 | WASHER | washer OD4.3 ID2.2 h0.3 | 2 | washer OD4.3 ID2.2 h0.3 |  |  | Especificacion dimensional; proveedor por confirmar
V15_HW_ETCLAMP_11F_1_M2x12_ASSY | ae1317c1ccb2d99dbb5f7e4848e091316c5ca256af800e203115704290712f6a | SCREW | M2x12 | 1 | M2x12 socket screw; {"length_under_head_mm": 12.0, "head_diameter_max_mm": 4.0, "head_height_max_mm": 2.0} |  |  | Especificacion dimensional; proveedor por confirmar
V15_HW_ETCLAMP_11F_1_M2x12_ASSY | ae1317c1ccb2d99dbb5f7e4848e091316c5ca256af800e203115704290712f6a | NUT | M2 AF4 h1.6 | 1 | M2 nut AF4 h1.6 |  |  | Especificacion dimensional; proveedor por confirmar
V15_HW_ETCLAMP_11F_1_M2x12_ASSY | ae1317c1ccb2d99dbb5f7e4848e091316c5ca256af800e203115704290712f6a | WASHER | washer OD4.3 ID2.2 h0.3 | 2 | washer OD4.3 ID2.2 h0.3 |  |  | Especificacion dimensional; proveedor por confirmar
V15_HW_ETCLAMP_12F_0_M2x12_ASSY | 25567a49420e2298b209923bf7ee68d857bcdacba0652cc0195e3bb5b3a96c77 | SCREW | M2x12 | 1 | M2x12 socket screw; {"length_under_head_mm": 12.0, "head_diameter_max_mm": 4.0, "head_height_max_mm": 2.0} |  |  | Especificacion dimensional; proveedor por confirmar
V15_HW_ETCLAMP_12F_0_M2x12_ASSY | 25567a49420e2298b209923bf7ee68d857bcdacba0652cc0195e3bb5b3a96c77 | NUT | M2 AF4 h1.6 | 1 | M2 nut AF4 h1.6 |  |  | Especificacion dimensional; proveedor por confirmar
V15_HW_ETCLAMP_12F_0_M2x12_ASSY | 25567a49420e2298b209923bf7ee68d857bcdacba0652cc0195e3bb5b3a96c77 | WASHER | washer OD4.3 ID2.2 h0.3 | 2 | washer OD4.3 ID2.2 h0.3 |  |  | Especificacion dimensional; proveedor por confirmar
V15_HW_ETCLAMP_12F_1_M2x12_ASSY | 492925642facfada818a2b8621cf241416287b0ed5e363a23dd210f002d722e7 | SCREW | M2x12 | 1 | M2x12 socket screw; {"length_under_head_mm": 12.0, "head_diameter_max_mm": 4.0, "head_height_max_mm": 2.0} |  |  | Especificacion dimensional; proveedor por confirmar
V15_HW_ETCLAMP_12F_1_M2x12_ASSY | 492925642facfada818a2b8621cf241416287b0ed5e363a23dd210f002d722e7 | NUT | M2 AF4 h1.6 | 1 | M2 nut AF4 h1.6 |  |  | Especificacion dimensional; proveedor por confirmar
V15_HW_ETCLAMP_12F_1_M2x12_ASSY | 492925642facfada818a2b8621cf241416287b0ed5e363a23dd210f002d722e7 | WASHER | washer OD4.3 ID2.2 h0.3 | 2 | washer OD4.3 ID2.2 h0.3 |  |  | Especificacion dimensional; proveedor por confirmar
V15_HW_ETCLAMP_13F_0_M2x12_ASSY | 6b344aac335be16c20349aee352134b5ed79abb40e3322eea94702b25efcc9d3 | SCREW | M2x12 | 1 | M2x12 socket screw; {"length_under_head_mm": 12.0, "head_diameter_max_mm": 4.0, "head_height_max_mm": 2.0} |  |  | Especificacion dimensional; proveedor por confirmar
V15_HW_ETCLAMP_13F_0_M2x12_ASSY | 6b344aac335be16c20349aee352134b5ed79abb40e3322eea94702b25efcc9d3 | NUT | M2 AF4 h1.6 | 1 | M2 nut AF4 h1.6 |  |  | Especificacion dimensional; proveedor por confirmar
V15_HW_ETCLAMP_13F_0_M2x12_ASSY | 6b344aac335be16c20349aee352134b5ed79abb40e3322eea94702b25efcc9d3 | WASHER | washer OD4.3 ID2.2 h0.3 | 2 | washer OD4.3 ID2.2 h0.3 |  |  | Especificacion dimensional; proveedor por confirmar
V15_HW_ETCLAMP_13F_1_M2x12_ASSY | f72ee8d998bee7b757c3889ad9c3147b12ec0d9ac08de9b82cffc75a7e40af6d | SCREW | M2x12 | 1 | M2x12 socket screw; {"length_under_head_mm": 12.0, "head_diameter_max_mm": 4.0, "head_height_max_mm": 2.0} |  |  | Especificacion dimensional; proveedor por confirmar
V15_HW_ETCLAMP_13F_1_M2x12_ASSY | f72ee8d998bee7b757c3889ad9c3147b12ec0d9ac08de9b82cffc75a7e40af6d | NUT | M2 AF4 h1.6 | 1 | M2 nut AF4 h1.6 |  |  | Especificacion dimensional; proveedor por confirmar
V15_HW_ETCLAMP_13F_1_M2x12_ASSY | f72ee8d998bee7b757c3889ad9c3147b12ec0d9ac08de9b82cffc75a7e40af6d | WASHER | washer OD4.3 ID2.2 h0.3 | 2 | washer OD4.3 ID2.2 h0.3 |  |  | Especificacion dimensional; proveedor por confirmar
V15_HW_FOOT_L_CIRCUITO_0 | 81d49a31557eae7febaa5e5331b774cc12d69dcbbc78010fa6a2094a74ce54d7 | SCREW | M1.6x6 | 1 | M1.6x6 machine screw, head OD<=3.2 height<=1.3; {"length_under_head_mm": 6} |  |  | Especificacion dimensional; proveedor por confirmar
V15_HW_FOOT_L_CIRCUITO_0 | 81d49a31557eae7febaa5e5331b774cc12d69dcbbc78010fa6a2094a74ce54d7 | NUT | M1.6 AF3.2 h1.3 | 1 | M1.6 nut AF3.2 height1.3 |  |  | Especificacion dimensional; proveedor por confirmar
V15_HW_FOOT_L_CIRCUITO_0 | 81d49a31557eae7febaa5e5331b774cc12d69dcbbc78010fa6a2094a74ce54d7 | WASHER | M1.6 washer OD3.5 ID1.8 thickness0.3 | 1 | M1.6 washer OD3.5 ID1.8 thickness0.3 |  |  | Especificacion dimensional; proveedor por confirmar
V15_HW_FOOT_L_CIRCUITO_1 | df249d61eb680299af91eaef51d7439d6800853115435e9de9030efcaf2f5060 | SCREW | M1.6x6 | 1 | M1.6x6 machine screw, head OD<=3.2 height<=1.3; {"length_under_head_mm": 6} |  |  | Especificacion dimensional; proveedor por confirmar
V15_HW_FOOT_L_CIRCUITO_1 | df249d61eb680299af91eaef51d7439d6800853115435e9de9030efcaf2f5060 | NUT | M1.6 AF3.2 h1.3 | 1 | M1.6 nut AF3.2 height1.3 |  |  | Especificacion dimensional; proveedor por confirmar
V15_HW_FOOT_L_CIRCUITO_1 | df249d61eb680299af91eaef51d7439d6800853115435e9de9030efcaf2f5060 | WASHER | M1.6 washer OD3.5 ID1.8 thickness0.3 | 1 | M1.6 washer OD3.5 ID1.8 thickness0.3 |  |  | Especificacion dimensional; proveedor por confirmar
V15_HW_FOOT_L_HEEL_0 | 606f5bcbaa11afa3c5aaa26e22431d26cf71d99d40b080e12acecc2c78a4a85b | SCREW | M2x11 | 1 | M2x11 pan/socket-head machine screw prepared from M2x12; {"length_under_head_mm": 11, "head_diameter_max_mm": 4, "head_height_max_mm": 1.6} | Preparar desdeM2x12;longitudbajocabeza11mm,desbarbar |  | Especificacion dimensional; proveedor por confirmar
V15_HW_FOOT_L_HEEL_0 | 606f5bcbaa11afa3c5aaa26e22431d26cf71d99d40b080e12acecc2c78a4a85b | NUT | M2 AF4 h1.6 | 1 | M2 hex nut AF4 height1.6 |  |  | Especificacion dimensional; proveedor por confirmar
V15_HW_FOOT_L_HEEL_0 | 606f5bcbaa11afa3c5aaa26e22431d26cf71d99d40b080e12acecc2c78a4a85b | WASHER | M2 washer OD4.3 ID2.2 thickness0.3 | 2 | M2 washer OD4.3 ID2.2 thickness0.3 |  |  | Especificacion dimensional; proveedor por confirmar
V15_HW_FOOT_L_HEEL_1 | 4172767e86fcb65b60d13efe567c7bad4c5a3abff0cce1bd1f103d94d9768716 | SCREW | M2x11 | 1 | M2x11 pan/socket-head machine screw prepared from M2x12; {"length_under_head_mm": 11, "head_diameter_max_mm": 4, "head_height_max_mm": 1.6} | Preparar desdeM2x12;longitudbajocabeza11mm,desbarbar |  | Especificacion dimensional; proveedor por confirmar
V15_HW_FOOT_L_HEEL_1 | 4172767e86fcb65b60d13efe567c7bad4c5a3abff0cce1bd1f103d94d9768716 | NUT | M2 AF4 h1.6 | 1 | M2 hex nut AF4 height1.6 |  |  | Especificacion dimensional; proveedor por confirmar
V15_HW_FOOT_L_HEEL_1 | 4172767e86fcb65b60d13efe567c7bad4c5a3abff0cce1bd1f103d94d9768716 | WASHER | M2 washer OD4.3 ID2.2 thickness0.3 | 2 | M2 washer OD4.3 ID2.2 thickness0.3 |  |  | Especificacion dimensional; proveedor por confirmar
V15_HW_FOOT_L_TOE_0 | ee13074d6f97b10504ef409ac8736de2d8e0257b2ecf6c7660936a00ef9e119e | SCREW | M2x11 | 1 | M2x11 pan/socket-head machine screw prepared from M2x12; {"length_under_head_mm": 11, "head_diameter_max_mm": 4, "head_height_max_mm": 1.6} | Preparar desdeM2x12;longitudbajocabeza11mm,desbarbar |  | Especificacion dimensional; proveedor por confirmar
V15_HW_FOOT_L_TOE_0 | ee13074d6f97b10504ef409ac8736de2d8e0257b2ecf6c7660936a00ef9e119e | NUT | M2 AF4 h1.6 | 1 | M2 hex nut AF4 height1.6 |  |  | Especificacion dimensional; proveedor por confirmar
V15_HW_FOOT_L_TOE_0 | ee13074d6f97b10504ef409ac8736de2d8e0257b2ecf6c7660936a00ef9e119e | WASHER | M2 washer OD4.3 ID2.2 thickness0.3 | 2 | M2 washer OD4.3 ID2.2 thickness0.3 |  |  | Especificacion dimensional; proveedor por confirmar
V15_HW_FOOT_L_TOE_1 | ef5c046456dd3da6c4c69fac4461648381bcccbca5a39417186360b3d13a85d4 | SCREW | M2x11 | 1 | M2x11 pan/socket-head machine screw prepared from M2x12; {"length_under_head_mm": 11, "head_diameter_max_mm": 4, "head_height_max_mm": 1.6} | Preparar desdeM2x12;longitudbajocabeza11mm,desbarbar |  | Especificacion dimensional; proveedor por confirmar
V15_HW_FOOT_L_TOE_1 | ef5c046456dd3da6c4c69fac4461648381bcccbca5a39417186360b3d13a85d4 | NUT | M2 AF4 h1.6 | 1 | M2 hex nut AF4 height1.6 |  |  | Especificacion dimensional; proveedor por confirmar
V15_HW_FOOT_L_TOE_1 | ef5c046456dd3da6c4c69fac4461648381bcccbca5a39417186360b3d13a85d4 | WASHER | M2 washer OD4.3 ID2.2 thickness0.3 | 2 | M2 washer OD4.3 ID2.2 thickness0.3 |  |  | Especificacion dimensional; proveedor por confirmar
V15_HW_FOOT_R_CIRCUITO_0 | d1de4d1f4cf14991c91f75a79dfc1d2b694218ac6a0459efc666422cd2d11767 | SCREW | M1.6x6 | 1 | M1.6x6 machine screw, head OD<=3.2 height<=1.3; {"length_under_head_mm": 6} |  |  | Especificacion dimensional; proveedor por confirmar
V15_HW_FOOT_R_CIRCUITO_0 | d1de4d1f4cf14991c91f75a79dfc1d2b694218ac6a0459efc666422cd2d11767 | NUT | M1.6 AF3.2 h1.3 | 1 | M1.6 nut AF3.2 height1.3 |  |  | Especificacion dimensional; proveedor por confirmar
V15_HW_FOOT_R_CIRCUITO_0 | d1de4d1f4cf14991c91f75a79dfc1d2b694218ac6a0459efc666422cd2d11767 | WASHER | M1.6 washer OD3.5 ID1.8 thickness0.3 | 1 | M1.6 washer OD3.5 ID1.8 thickness0.3 |  |  | Especificacion dimensional; proveedor por confirmar
V15_HW_FOOT_R_CIRCUITO_1 | b6bf4fd42740aa8080f2a0f186fd6403931f05413268e810339d759d7aa58d49 | SCREW | M1.6x6 | 1 | M1.6x6 machine screw, head OD<=3.2 height<=1.3; {"length_under_head_mm": 6} |  |  | Especificacion dimensional; proveedor por confirmar
V15_HW_FOOT_R_CIRCUITO_1 | b6bf4fd42740aa8080f2a0f186fd6403931f05413268e810339d759d7aa58d49 | NUT | M1.6 AF3.2 h1.3 | 1 | M1.6 nut AF3.2 height1.3 |  |  | Especificacion dimensional; proveedor por confirmar
V15_HW_FOOT_R_CIRCUITO_1 | b6bf4fd42740aa8080f2a0f186fd6403931f05413268e810339d759d7aa58d49 | WASHER | M1.6 washer OD3.5 ID1.8 thickness0.3 | 1 | M1.6 washer OD3.5 ID1.8 thickness0.3 |  |  | Especificacion dimensional; proveedor por confirmar
V15_HW_FOOT_R_HEEL_0 | 2dcc4b7851781242b0c48407de2b7bfbf1c4cade9346590aacf4c5cc1b1eaa26 | SCREW | M2x11 | 1 | M2x11 pan/socket-head machine screw prepared from M2x12; {"length_under_head_mm": 11, "head_diameter_max_mm": 4, "head_height_max_mm": 1.6} | Preparar desdeM2x12;longitudbajocabeza11mm,desbarbar |  | Especificacion dimensional; proveedor por confirmar
V15_HW_FOOT_R_HEEL_0 | 2dcc4b7851781242b0c48407de2b7bfbf1c4cade9346590aacf4c5cc1b1eaa26 | NUT | M2 AF4 h1.6 | 1 | M2 hex nut AF4 height1.6 |  |  | Especificacion dimensional; proveedor por confirmar
V15_HW_FOOT_R_HEEL_0 | 2dcc4b7851781242b0c48407de2b7bfbf1c4cade9346590aacf4c5cc1b1eaa26 | WASHER | M2 washer OD4.3 ID2.2 thickness0.3 | 2 | M2 washer OD4.3 ID2.2 thickness0.3 |  |  | Especificacion dimensional; proveedor por confirmar
V15_HW_FOOT_R_HEEL_1 | f30b655adb6407b8bea7849b2d083a81279c6fb397e547a2e3418cb834baa8ae | SCREW | M2x11 | 1 | M2x11 pan/socket-head machine screw prepared from M2x12; {"length_under_head_mm": 11, "head_diameter_max_mm": 4, "head_height_max_mm": 1.6} | Preparar desdeM2x12;longitudbajocabeza11mm,desbarbar |  | Especificacion dimensional; proveedor por confirmar
V15_HW_FOOT_R_HEEL_1 | f30b655adb6407b8bea7849b2d083a81279c6fb397e547a2e3418cb834baa8ae | NUT | M2 AF4 h1.6 | 1 | M2 hex nut AF4 height1.6 |  |  | Especificacion dimensional; proveedor por confirmar
V15_HW_FOOT_R_HEEL_1 | f30b655adb6407b8bea7849b2d083a81279c6fb397e547a2e3418cb834baa8ae | WASHER | M2 washer OD4.3 ID2.2 thickness0.3 | 2 | M2 washer OD4.3 ID2.2 thickness0.3 |  |  | Especificacion dimensional; proveedor por confirmar
V15_HW_FOOT_R_TOE_0 | 6d8eae26656fe3c7318aea4b4236d4250594e5403577548dc2476d8e9f4db7ee | SCREW | M2x11 | 1 | M2x11 pan/socket-head machine screw prepared from M2x12; {"length_under_head_mm": 11, "head_diameter_max_mm": 4, "head_height_max_mm": 1.6} | Preparar desdeM2x12;longitudbajocabeza11mm,desbarbar |  | Especificacion dimensional; proveedor por confirmar
V15_HW_FOOT_R_TOE_0 | 6d8eae26656fe3c7318aea4b4236d4250594e5403577548dc2476d8e9f4db7ee | NUT | M2 AF4 h1.6 | 1 | M2 hex nut AF4 height1.6 |  |  | Especificacion dimensional; proveedor por confirmar
V15_HW_FOOT_R_TOE_0 | 6d8eae26656fe3c7318aea4b4236d4250594e5403577548dc2476d8e9f4db7ee | WASHER | M2 washer OD4.3 ID2.2 thickness0.3 | 2 | M2 washer OD4.3 ID2.2 thickness0.3 |  |  | Especificacion dimensional; proveedor por confirmar
V15_HW_FOOT_R_TOE_1 | 95011f93792b11585cd92237c2d8e28655c1520d39167bb009e51b235534dc16 | SCREW | M2x11 | 1 | M2x11 pan/socket-head machine screw prepared from M2x12; {"length_under_head_mm": 11, "head_diameter_max_mm": 4, "head_height_max_mm": 1.6} | Preparar desdeM2x12;longitudbajocabeza11mm,desbarbar |  | Especificacion dimensional; proveedor por confirmar
V15_HW_FOOT_R_TOE_1 | 95011f93792b11585cd92237c2d8e28655c1520d39167bb009e51b235534dc16 | NUT | M2 AF4 h1.6 | 1 | M2 hex nut AF4 height1.6 |  |  | Especificacion dimensional; proveedor por confirmar
V15_HW_FOOT_R_TOE_1 | 95011f93792b11585cd92237c2d8e28655c1520d39167bb009e51b235534dc16 | WASHER | M2 washer OD4.3 ID2.2 thickness0.3 | 2 | M2 washer OD4.3 ID2.2 thickness0.3 |  |  | Especificacion dimensional; proveedor por confirmar
V15_HW_HEAD_CHEEK_SSH_M2x10_R | a75a090dee21a39745a6602408799e7990b74029480bdbcf8a97c757c9c41b13 | SCREW | M2x10 NBK SSH-M2-10 | 1 | NBK SSH-M2-10 socketflathead; {"length_under_head_mm": 10, "head_diameter_mm": 4, "head_height_mm": 1.1} |  |  | Especificacion dimensional; proveedor por confirmar
V15_HW_HEAD_CHEEK_SSH_M2x10_R | a75a090dee21a39745a6602408799e7990b74029480bdbcf8a97c757c9c41b13 | NUT | M2 AF4 h1.6 | 1 | M2 nut AF4 h1.6 |  |  | Especificacion dimensional; proveedor por confirmar
V15_HW_HEAD_CHEEK_SSH_M2x10_R | a75a090dee21a39745a6602408799e7990b74029480bdbcf8a97c757c9c41b13 | WASHER | M2 smallseries flatwasher DIN433 nominalOD4.5 ID2.2 h0.3 | 1 | M2 smallseries flatwasher DIN433 nominalOD4.5 ID2.2 h0.3 |  |  | Especificacion dimensional; proveedor por confirmar
V15_HW_HEAD_CHEEK_SSH_M2x8_L | 3b6d27c7f705a8d6758348e788a2b83e50f0be8a31a50c611bbc1c254cbade21 | SCREW | M2x8 NBK SSH-M2-8 | 1 | NBK SSH-M2-8 socketflathead; {"length_under_head_mm": 8, "head_diameter_mm": 4, "head_height_mm": 1.1} |  |  | Especificacion dimensional; proveedor por confirmar
V15_HW_HEAD_CHEEK_SSH_M2x8_L | 3b6d27c7f705a8d6758348e788a2b83e50f0be8a31a50c611bbc1c254cbade21 | NUT | M2 AF4 h1.6 | 1 | M2 nut AF4 h1.6 |  |  | Especificacion dimensional; proveedor por confirmar
V15_HW_HEAD_CHEEK_SSH_M2x8_L | 3b6d27c7f705a8d6758348e788a2b83e50f0be8a31a50c611bbc1c254cbade21 | WASHER | M2 smallseries flatwasher DIN433 nominalOD4.5 ID2.2 h0.3 | 1 | M2 smallseries flatwasher DIN433 nominalOD4.5 ID2.2 h0.3 |  |  | Especificacion dimensional; proveedor por confirmar
V15_HW_HP_GATE_M2x8 | 0f833dc1986b8137d12a1e3a552efa50d0089a20da6853931ebaebdca65399c9 | SCREW | M2x8 | 1 | screw_M2x8; {} |  |  | Especificacion dimensional; proveedor por confirmar
V15_HW_HP_GATE_M2x8 | 0f833dc1986b8137d12a1e3a552efa50d0089a20da6853931ebaebdca65399c9 | NUT | M2 AF4 h1.6 | 1 | nut_M2_AF4_h1p6 |  |  | Especificacion dimensional; proveedor por confirmar
V15_HW_HP_GATE_M2x8 | 0f833dc1986b8137d12a1e3a552efa50d0089a20da6853931ebaebdca65399c9 | WASHER | washer_OD4p3_ID2p15_h0p3 | 2 | washer_OD4p3_ID2p15_h0p3 |  |  | Especificacion dimensional; proveedor por confirmar
V15_HW_K10_GATE_M2x8_0 | bc285fa321e6cdadfc81b069ab29e47cebfb43d9bdca399152afbff34afcb8e8 | SCREW | M2x8 | 1 | screw_M2x8; {} |  |  | Especificacion dimensional; proveedor por confirmar
V15_HW_K10_GATE_M2x8_0 | bc285fa321e6cdadfc81b069ab29e47cebfb43d9bdca399152afbff34afcb8e8 | NUT | M2 AF4 h1.6 | 1 | nut_M2_AF4_h1p6 |  |  | Especificacion dimensional; proveedor por confirmar
V15_HW_K10_GATE_M2x8_0 | bc285fa321e6cdadfc81b069ab29e47cebfb43d9bdca399152afbff34afcb8e8 | WASHER | washer_OD4p3_ID2p15_h0p3 | 2 | washer_OD4p3_ID2p15_h0p3 |  |  | Especificacion dimensional; proveedor por confirmar
V15_HW_K10_GATE_M2x8_1 | 7b1eb56c162bddd7918bdabb6362618f9555b447777b0c2fa9eb6628d901ff4e | SCREW | M2x8 | 1 | screw_M2x8; {} |  |  | Especificacion dimensional; proveedor por confirmar
V15_HW_K10_GATE_M2x8_1 | 7b1eb56c162bddd7918bdabb6362618f9555b447777b0c2fa9eb6628d901ff4e | NUT | M2 AF4 h1.6 | 1 | nut_M2_AF4_h1p6 |  |  | Especificacion dimensional; proveedor por confirmar
V15_HW_K10_GATE_M2x8_1 | 7b1eb56c162bddd7918bdabb6362618f9555b447777b0c2fa9eb6628d901ff4e | WASHER | washer_OD4p3_ID2p15_h0p3 | 2 | washer_OD4p3_ID2p15_h0p3 |  |  | Especificacion dimensional; proveedor por confirmar
V15_HW_MINI_M2x8_0 | 90443389881addd5026eef0b7d484a51714a386b612e7ff172bdfd85e9719832 | SCREW | M2x8 | 1 | screw_M2x8; {} |  |  | Especificacion dimensional; proveedor por confirmar
V15_HW_MINI_M2x8_0 | 90443389881addd5026eef0b7d484a51714a386b612e7ff172bdfd85e9719832 | NUT | M2 AF4 h1.6 | 1 | nut_M2_AF4_h1p6 |  |  | Especificacion dimensional; proveedor por confirmar
V15_HW_MINI_M2x8_0 | 90443389881addd5026eef0b7d484a51714a386b612e7ff172bdfd85e9719832 | WASHER | washer_OD4p3_ID2p15_h0p3 | 2 | washer_OD4p3_ID2p15_h0p3 |  |  | Especificacion dimensional; proveedor por confirmar
V15_HW_MINI_M2x8_1 | fea55a992d36651400a8b3397f82a195cee3f091838ae4d908b99cee762417d2 | SCREW | M2x8 | 1 | screw_M2x8; {} |  |  | Especificacion dimensional; proveedor por confirmar
V15_HW_MINI_M2x8_1 | fea55a992d36651400a8b3397f82a195cee3f091838ae4d908b99cee762417d2 | NUT | M2 AF4 h1.6 | 1 | nut_M2_AF4_h1p6 |  |  | Especificacion dimensional; proveedor por confirmar
V15_HW_MINI_M2x8_1 | fea55a992d36651400a8b3397f82a195cee3f091838ae4d908b99cee762417d2 | WASHER | washer_OD4p3_ID2p15_h0p3 | 2 | washer_OD4p3_ID2p15_h0p3 |  |  | Especificacion dimensional; proveedor por confirmar
V15_HW_MINI_M2x8_2 | 401dd5153f00abce0ce9c491b282eca2d8408d0c7897230cbb3cc99cd0b8f7fa | SCREW | M2x8 | 1 | screw_M2x8; {} |  |  | Especificacion dimensional; proveedor por confirmar
V15_HW_MINI_M2x8_2 | 401dd5153f00abce0ce9c491b282eca2d8408d0c7897230cbb3cc99cd0b8f7fa | NUT | M2 AF4 h1.6 | 1 | nut_M2_AF4_h1p6 |  |  | Especificacion dimensional; proveedor por confirmar
V15_HW_MINI_M2x8_2 | 401dd5153f00abce0ce9c491b282eca2d8408d0c7897230cbb3cc99cd0b8f7fa | WASHER | washer_OD4p3_ID2p15_h0p3 | 2 | washer_OD4p3_ID2p15_h0p3 |  |  | Especificacion dimensional; proveedor por confirmar
V15_HW_MINI_M2x8_3 | 63da0d00f6a0f6995147631d8f0acc5cc7c9fd08b37f6840df8328e45092c684 | SCREW | M2x8 | 1 | screw_M2x8; {} |  |  | Especificacion dimensional; proveedor por confirmar
V15_HW_MINI_M2x8_3 | 63da0d00f6a0f6995147631d8f0acc5cc7c9fd08b37f6840df8328e45092c684 | NUT | M2 AF4 h1.6 | 1 | nut_M2_AF4_h1p6 |  |  | Especificacion dimensional; proveedor por confirmar
V15_HW_MINI_M2x8_3 | 63da0d00f6a0f6995147631d8f0acc5cc7c9fd08b37f6840df8328e45092c684 | WASHER | washer_OD4p3_ID2p15_h0p3 | 2 | washer_OD4p3_ID2p15_h0p3 |  |  | Especificacion dimensional; proveedor por confirmar
V15_HW_PCM_GATE_M2x8_0 | cdea225a7db5006f5205dd5882fbd7752f89b2c6708c57b5c9f2988f42ce09fa | SCREW | M2x8 | 1 | screw_M2x8; {} |  |  | Especificacion dimensional; proveedor por confirmar
V15_HW_PCM_GATE_M2x8_0 | cdea225a7db5006f5205dd5882fbd7752f89b2c6708c57b5c9f2988f42ce09fa | NUT | M2 AF4 h1.6 | 1 | nut_M2_AF4_h1p6 |  |  | Especificacion dimensional; proveedor por confirmar
V15_HW_PCM_GATE_M2x8_0 | cdea225a7db5006f5205dd5882fbd7752f89b2c6708c57b5c9f2988f42ce09fa | WASHER | washer_OD4p3_ID2p15_h0p3 | 2 | washer_OD4p3_ID2p15_h0p3 |  |  | Especificacion dimensional; proveedor por confirmar
V15_HW_PCM_GATE_M2x8_1 | e1d59410d7e0e8b43a6af89a502303d6342ba534879d9aec3cf16a10eab443fb | SCREW | M2x8 | 1 | screw_M2x8; {} |  |  | Especificacion dimensional; proveedor por confirmar
V15_HW_PCM_GATE_M2x8_1 | e1d59410d7e0e8b43a6af89a502303d6342ba534879d9aec3cf16a10eab443fb | NUT | M2 AF4 h1.6 | 1 | nut_M2_AF4_h1p6 |  |  | Especificacion dimensional; proveedor por confirmar
V15_HW_PCM_GATE_M2x8_1 | e1d59410d7e0e8b43a6af89a502303d6342ba534879d9aec3cf16a10eab443fb | WASHER | washer_OD4p3_ID2p15_h0p3 | 2 | washer_OD4p3_ID2p15_h0p3 |  |  | Especificacion dimensional; proveedor por confirmar
V15_HW_PDB_LOWER_M2x18_0 | ffc9b48b5ee5ca6fd1129a5474ac990b71c2dd0025e741e7a554ebd555323d15 | SCREW | M2x18 | 1 | screw_M2x18_head_D4_h1p6; {} |  |  | Especificacion dimensional; proveedor por confirmar
V15_HW_PDB_LOWER_M2x18_0 | ffc9b48b5ee5ca6fd1129a5474ac990b71c2dd0025e741e7a554ebd555323d15 | NUT | M2 AF4 h1.6 | 1 | M2nut_AF4_h1p6 |  |  | Especificacion dimensional; proveedor por confirmar
V15_HW_PDB_LOWER_M2x18_0 | ffc9b48b5ee5ca6fd1129a5474ac990b71c2dd0025e741e7a554ebd555323d15 | WASHER | fenderwasher_OD6_ID2p2_h0p5 | 2 | fenderwasher_OD6_ID2p2_h0p5 |  |  | Especificacion dimensional; proveedor por confirmar
V15_HW_PDB_LOWER_M2x18_0 | ffc9b48b5ee5ca6fd1129a5474ac990b71c2dd0025e741e7a554ebd555323d15 | SLEEVE | spacer_OD6_ID2p2_h1 | 0 | spacer_OD6_ID2p2_h1 |  |  | Especificacion dimensional; proveedor por confirmar
V15_HW_PDB_LOWER_M2x18_1 | 9038e3628b658463b1cce977db9134859682a191a08ae3874fb3741f7738d8d1 | SCREW | M2x18 | 1 | screw_M2x18_head_D4_h1p6; {} |  |  | Especificacion dimensional; proveedor por confirmar
V15_HW_PDB_LOWER_M2x18_1 | 9038e3628b658463b1cce977db9134859682a191a08ae3874fb3741f7738d8d1 | NUT | M2 AF4 h1.6 | 1 | M2nut_AF4_h1p6 |  |  | Especificacion dimensional; proveedor por confirmar
V15_HW_PDB_LOWER_M2x18_1 | 9038e3628b658463b1cce977db9134859682a191a08ae3874fb3741f7738d8d1 | WASHER | fenderwasher_OD6_ID2p2_h0p5 | 2 | fenderwasher_OD6_ID2p2_h0p5 |  |  | Especificacion dimensional; proveedor por confirmar
V15_HW_PDB_LOWER_M2x18_1 | 9038e3628b658463b1cce977db9134859682a191a08ae3874fb3741f7738d8d1 | SLEEVE | spacer_OD6_ID2p2_h1 | 0 | spacer_OD6_ID2p2_h1 |  |  | Especificacion dimensional; proveedor por confirmar
V15_HW_REED_CAP_M2x8 | b914dcbc8cd53e4004493713d630e1e689bd628fe5b234cc2bb3ca15d7387288 | SCREW | M2x8 | 1 | screw_M2x8; {} |  |  | Especificacion dimensional; proveedor por confirmar
V15_HW_REED_CAP_M2x8 | b914dcbc8cd53e4004493713d630e1e689bd628fe5b234cc2bb3ca15d7387288 | NUT | M2 AF4 h1.6 | 1 | nut_M2_AF4_h1p6 |  |  | Especificacion dimensional; proveedor por confirmar
V15_HW_REED_CAP_M2x8 | b914dcbc8cd53e4004493713d630e1e689bd628fe5b234cc2bb3ca15d7387288 | WASHER | washer_OD4p3_ID2p15_h0p3 | 2 | washer_OD4p3_ID2p15_h0p3 |  |  | Especificacion dimensional; proveedor por confirmar
V15_HW_SERVICE_MG00_0_BOLT_M2x8 | cdd990cf1b38a6a25f9142db29aea501713a0c8f2b983ddb53e29397d2496534 | SCREW | M2x8 | 1 | M2x8 headOD4/H2; {} |  |  | Especificacion dimensional; proveedor por confirmar
V15_HW_SERVICE_MG00_0_NUT | 27cc69fe4b1b654e184808649c628ec4601f53f7a7f51c9ae6825bf622931c3e | NUT | M2 AF4 h1.6 | 1 | M2nutAF4/H1.6 |  |  | Especificacion dimensional; proveedor por confirmar
V15_HW_SERVICE_MG00_0_WASHER | a1354dac75c822d176d31b72652b20322d631e713f1eb37e2da2b569419a1f21 | WASHER | WASHER | 1 | washerOD4.2/ID2.2/h.3 |  |  | Especificacion dimensional; proveedor por confirmar
V15_HW_SERVICE_MG00_1_BOLT_M2x8 | 617e74e5c3942eb5867b263a031abfbc4744a36a8b97848a9ff55442b0c43582 | SCREW | M2x8 | 1 | M2x8 headOD4/H2; {} |  |  | Especificacion dimensional; proveedor por confirmar
V15_HW_SERVICE_MG00_1_NUT | 15e44b530f1bb87e550b8ca4e75b6cc144a5108de01b99499c64377460243320 | NUT | M2 AF4 h1.6 | 1 | M2nutAF4/H1.6 |  |  | Especificacion dimensional; proveedor por confirmar
V15_HW_SERVICE_MG00_1_WASHER | a5ed9e3fafa9afb9c554dfeb0286950c0ab4388cfbdd0bc32ac2ab2150054db1 | WASHER | WASHER | 1 | washerOD4.2/ID2.2/h.3 |  |  | Especificacion dimensional; proveedor por confirmar
V15_HW_SERVICE_MG01_0_BOLT_M2x8 | c8788f32eb3015ad0865a0f538ec065e59f5bf62763056a27b79c8a7b2648543 | SCREW | M2x8 | 1 | M2x8 headOD4/H2; {} |  |  | Especificacion dimensional; proveedor por confirmar
V15_HW_SERVICE_MG01_0_NUT | e9d7eb8bef3d6b63cb30be0a30340d9bdc2ced4d425df440283113b4cb4438cf | NUT | M2 AF4 h1.6 | 1 | M2nutAF4/H1.6 |  |  | Especificacion dimensional; proveedor por confirmar
V15_HW_SERVICE_MG01_0_WASHER | c4cc17938adbd8fe73543463a928717a1964b145a4496fe78a410977bc3104ad | WASHER | WASHER | 1 | washerOD4.2/ID2.2/h.3 |  |  | Especificacion dimensional; proveedor por confirmar
V15_HW_SERVICE_MG01_1_BOLT_M2x8 | 9ba14aedb35b0bccdf4c35742103a00b11056fd690878868f5218b011a1c29e0 | SCREW | M2x8 | 1 | M2x8 headOD4/H2; {} |  |  | Especificacion dimensional; proveedor por confirmar
V15_HW_SERVICE_MG01_1_NUT | 55bf825ef36c283f97e6bb80885ec8df8b0befe0e099397fc9cd9b96501bb3ff | NUT | M2 AF4 h1.6 | 1 | M2nutAF4/H1.6 |  |  | Especificacion dimensional; proveedor por confirmar
V15_HW_SERVICE_MG01_1_WASHER | 77ac986e01e96f327d5050dd68fbc7844c4584d16334e2924fcc09a768f84ff4 | WASHER | WASHER | 1 | washerOD4.2/ID2.2/h.3 |  |  | Especificacion dimensional; proveedor por confirmar
V15_HW_SERVICE_MG02_0_BOLT_M2x8 | 227ae9de16060b7e53ead624861549043f5886a598d23f7eea2a180eed1ce0a9 | SCREW | M2x8 | 1 | M2x8 headOD4/H2; {} |  |  | Especificacion dimensional; proveedor por confirmar
V15_HW_SERVICE_MG02_0_NUT | 2e62f623c6a821e58c221857d7b03009eda8ab0df360d711d18d0bac487547ed | NUT | M2 AF4 h1.6 | 1 | M2nutAF4/H1.6 |  |  | Especificacion dimensional; proveedor por confirmar
V15_HW_SERVICE_MG02_0_WASHER | 1542fef1a0bb911bb4c298c1fbc1ce3d926ba77dc588b9145d6c5146ee68eb9f | WASHER | WASHER | 1 | washerOD4.2/ID2.2/h.3 |  |  | Especificacion dimensional; proveedor por confirmar
V15_HW_SERVICE_MG02_1_BOLT_M2x8 | aa86bd2c7573a83d71f4ce806c005ae08b7f3696c6e8c851a8b5bfb843e536dd | SCREW | M2x8 | 1 | M2x8 headOD4/H2; {} |  |  | Especificacion dimensional; proveedor por confirmar
V15_HW_SERVICE_MG02_1_NUT | 6f1f7bb3eee7c9ac2e6659dee694c3c22fc8b4cb40beb6e03bac8ba4863b93bf | NUT | M2 AF4 h1.6 | 1 | M2nutAF4/H1.6 |  |  | Especificacion dimensional; proveedor por confirmar
V15_HW_SERVICE_MG02_1_WASHER | 501887c4db88d5b08ca4a13677636e34a00906c3386364bc55629e6dda4ab580 | WASHER | WASHER | 1 | washerOD4.2/ID2.2/h.3 |  |  | Especificacion dimensional; proveedor por confirmar
V15_HW_SERVICE_MG03_0_BOLT_M2x8 | 2890c75949acd525caf15228eb0ae8dc4c4a99829738c54b7b4591533d4567e9 | SCREW | M2x8 | 1 | M2x8 headOD4/H2; {} |  |  | Especificacion dimensional; proveedor por confirmar
V15_HW_SERVICE_MG03_0_NUT | 9ae1707d29a26d3ef9c60a2b72c2e7a965cc6e59ca139fcefcebb2841d0b77a7 | NUT | M2 AF4 h1.6 | 1 | M2nutAF4/H1.6 |  |  | Especificacion dimensional; proveedor por confirmar
V15_HW_SERVICE_MG03_0_WASHER | 608f0a10b1ea98232899ae3ace78521d88370f5f76da091a1b794b9184d34592 | WASHER | WASHER | 1 | washerOD4.2/ID2.2/h.3 |  |  | Especificacion dimensional; proveedor por confirmar
V15_HW_SERVICE_MG03_1_BOLT_M2x8 | 681923f3e9167030893ddfede891917b01295251f419c678ec359b6423b885d7 | SCREW | M2x8 | 1 | M2x8 headOD4/H2; {} |  |  | Especificacion dimensional; proveedor por confirmar
V15_HW_SERVICE_MG03_1_NUT | b6ca2f9c488c9440db5357dc8e9ab2ec4232a9e73c7fed74b16967083b7797bd | NUT | M2 AF4 h1.6 | 1 | M2nutAF4/H1.6 |  |  | Especificacion dimensional; proveedor por confirmar
V15_HW_SERVICE_MG03_1_WASHER | f369fbee47ef8bf6843fb8230ebe82bea2077b5854b735e936e6a7151a849bb8 | WASHER | WASHER | 1 | washerOD4.2/ID2.2/h.3 |  |  | Especificacion dimensional; proveedor por confirmar
V15_HW_SERVICE_MG04_0_BOLT_M2x8 | c90a342eff8a4b59373e4ff44bfe3499aed801eabc2f057632c6a936c477b2c4 | SCREW | M2x8 | 1 | M2x8 headOD4/H2; {} |  |  | Especificacion dimensional; proveedor por confirmar
V15_HW_SERVICE_MG04_0_NUT | b6cf1d5ea408eb4500f9a1a8e339f67317ca5b1d4d3bce9f6a90c3e85f8dd6f2 | NUT | M2 AF4 h1.6 | 1 | M2nutAF4/H1.6 |  |  | Especificacion dimensional; proveedor por confirmar
V15_HW_SERVICE_MG04_0_WASHER | d384ee1695e9033f5454d34f6708b17d2004903cfbffb55cc0aed07ad898957e | WASHER | WASHER | 1 | washerOD4.2/ID2.2/h.3 |  |  | Especificacion dimensional; proveedor por confirmar
V15_HW_SERVICE_MG04_1_BOLT_M2x8 | 7bc90788a46f3ca8e26639981e12dbbcfe30b43d38c75ac4030fd980a01446ea | SCREW | M2x8 | 1 | M2x8 headOD4/H2; {} |  |  | Especificacion dimensional; proveedor por confirmar
V15_HW_SERVICE_MG04_1_NUT | 4a408da11974cac4814ab1791fdbaa2b872cb3ce1ce3f8866efe548cdd2484a7 | NUT | M2 AF4 h1.6 | 1 | M2nutAF4/H1.6 |  |  | Especificacion dimensional; proveedor por confirmar
V15_HW_SERVICE_MG04_1_WASHER | 8150906097070bff1954d9a479fd3ccda287bedf45239fca26ebe598a43b8680 | WASHER | WASHER | 1 | washerOD4.2/ID2.2/h.3 |  |  | Especificacion dimensional; proveedor por confirmar
V15_HW_SERVICE_MG08_0_BOLT_M2x8 | ea69daaecb02429248c0f482534afddc09a375071d95e6b807bba00f5c355dc1 | SCREW | M2x8 NBK SSH-M2-8 ultra-low profile | 1 | NBK SSH-M2-8 ultra-low profile machine screw; {"length_under_head_mm": 8, "head_diameter_mm": 4, "head_height_mm": 1.1} |  | https://www.nbk1560.com/images/en-US/product/lowsmallheadscrew/SSH/SSH_1.pdf | SKU dimensional citado; existencias no verificadas
V15_HW_SERVICE_MG08_0_NUT | 39cd10bb471809a8a6a0bf298eda74452e79f90e52356c6072cb5fa5ea51060c | NUT | M2 AF4 h1.6 | 1 | M2nutAF4/H1.6 |  |  | Especificacion dimensional; proveedor por confirmar
V15_HW_SERVICE_MG08_0_WASHER | 6a7695d5bea9150d5db60aeb8701a42c9368063a0902c3ea4539addd1e53ce0c | WASHER | WASHER | 1 | washerOD4.2/ID2.2/h.3 |  |  | Especificacion dimensional; proveedor por confirmar
V15_HW_SERVICE_MG08_1_BOLT_M2x8 | dd33e8382cb948b11efdb5977c1a99e08475bc31e69b737a66148c681f439452 | SCREW | M2x8 NBK SSH-M2-8 ultra-low profile | 1 | NBK SSH-M2-8 ultra-low profile machine screw; {"length_under_head_mm": 8, "head_diameter_mm": 4, "head_height_mm": 1.1} |  | https://www.nbk1560.com/images/en-US/product/lowsmallheadscrew/SSH/SSH_1.pdf | SKU dimensional citado; existencias no verificadas
V15_HW_SERVICE_MG08_1_NUT | 495886af157d1da0fe5d6e13c8cb230d4ddb137c6032f329e28c0f0ce4984717 | NUT | M2 AF4 h1.6 | 1 | M2nutAF4/H1.6 |  |  | Especificacion dimensional; proveedor por confirmar
V15_HW_SERVICE_MG08_1_WASHER | 29ffd5f9a270292e32aa5fb7a1084d2b64f235c261ed66e0fb55bdc1c04e61b0 | WASHER | WASHER | 1 | washerOD4.2/ID2.2/h.3 |  |  | Especificacion dimensional; proveedor por confirmar
V15_HW_SERVICE_MG10_0_BOLT_M2x8 | 60689bc2317b1c85290063ee7e3fc823830ea231734f54a078709080877c7bae | SCREW | M2x8 | 1 | M2x8 headOD4/H2; {} |  |  | Especificacion dimensional; proveedor por confirmar
V15_HW_SERVICE_MG10_0_NUT | 1f9c8dcffe391389c2dbebcfe268a03310f59cf669f5dfd31fbb6edbacb11a60 | NUT | M2 AF4 h1.6 | 1 | M2nutAF4/H1.6 |  |  | Especificacion dimensional; proveedor por confirmar
V15_HW_SERVICE_MG10_0_WASHER | 6b481d59eb7084ddfdf268ab15495c8aa334602d894af98316cc2a2dbae0eb52 | WASHER | WASHER | 1 | washerOD4.2/ID2.2/h.3 |  |  | Especificacion dimensional; proveedor por confirmar
V15_HW_SERVICE_MG10_1_BOLT_M2x8 | c48d7159d7f2a2eb765c0d0ae8fb13487131c57baa102d5aa78b6f0aa005d15d | SCREW | M2x8 | 1 | M2x8 headOD4/H2; {} |  |  | Especificacion dimensional; proveedor por confirmar
V15_HW_SERVICE_MG10_1_NUT | 1f425042d14cc75f7a8ae46e48945679a26890d7fe2b385f4a28799bef763a41 | NUT | M2 AF4 h1.6 | 1 | M2nutAF4/H1.6 |  |  | Especificacion dimensional; proveedor por confirmar
V15_HW_SERVICE_MG10_1_WASHER | e2998b34db450035e93e0a28eb83d7cbf9875689f8810ac0f620e4c69b1e645d | WASHER | WASHER | 1 | washerOD4.2/ID2.2/h.3 |  |  | Especificacion dimensional; proveedor por confirmar
V15_HW_SERVICE_MG11_0_BOLT_M2x8 | 8286a0f83d20388955ac5f103d5e655b6c2c412a11f5b984ffa9e6ba06f530cb | SCREW | M2x8 | 1 | M2x8 headOD4/H2; {} |  |  | Especificacion dimensional; proveedor por confirmar
V15_HW_SERVICE_MG11_0_NUT | 9ee0d737f96d07095b566dd5823282c006806557328a8b1aedbbec757a89e54b | NUT | M2 AF4 h1.6 | 1 | M2nutAF4/H1.6 |  |  | Especificacion dimensional; proveedor por confirmar
V15_HW_SERVICE_MG11_0_WASHER | 7ac533b055ca99d61fe549bbb830ebd0c49f6edbba925913b473192864a18ced | WASHER | WASHER | 1 | washerOD4.2/ID2.2/h.3 |  |  | Especificacion dimensional; proveedor por confirmar
V15_HW_SERVICE_MG11_1_BOLT_M2x8 | ff0fc255e673dd797c51c0192c1fc48289b95c85e220328ffed3e4abd64e8217 | SCREW | M2x8 | 1 | M2x8 headOD4/H2; {} |  |  | Especificacion dimensional; proveedor por confirmar
V15_HW_SERVICE_MG11_1_NUT | 36de767a109f1a0495f402e240675a8fb9175d0b2ceb0c7d480de84e503e9b85 | NUT | M2 AF4 h1.6 | 1 | M2nutAF4/H1.6 |  |  | Especificacion dimensional; proveedor por confirmar
V15_HW_SERVICE_MG11_1_WASHER | 042afeedd26420c4db15abcb956d33e13d603e4f160383f69cb15667680a1345 | WASHER | WASHER | 1 | washerOD4.2/ID2.2/h.3 |  |  | Especificacion dimensional; proveedor por confirmar
V15_HW_SERVICE_MG12_0_BOLT_M2x8 | b337b53fc8db948c9b2070410d839cc969c89d6f5df33495259bdcf7fe186e30 | SCREW | M2x8 | 1 | M2x8 headOD4/H2; {} |  |  | Especificacion dimensional; proveedor por confirmar
V15_HW_SERVICE_MG12_0_NUT | c34a59ce3ac1cdded359445811b0d1f58dd46fcdc77e310bd642c70586a3da41 | NUT | M2 AF4 h1.6 | 1 | M2nutAF4/H1.6 |  |  | Especificacion dimensional; proveedor por confirmar
V15_HW_SERVICE_MG12_0_WASHER | 0214d7f7db29ae95465950645f8d655769596fe7e7bf936421889b5ae6205f0d | WASHER | WASHER | 1 | washerOD4.2/ID2.2/h.3 |  |  | Especificacion dimensional; proveedor por confirmar
V15_HW_SERVICE_MG12_1_BOLT_M2x8 | 2985dc606b3b1b1c3977d128f509112b69490e2c71b94951bebd715dcaa72a6d | SCREW | M2x8 | 1 | M2x8 headOD4/H2; {} |  |  | Especificacion dimensional; proveedor por confirmar
V15_HW_SERVICE_MG12_1_NUT | 875b1e4a0773cac2f48cee484b8734e762e25f30dadd48d35fe887ac2bb7acd7 | NUT | M2 AF4 h1.6 | 1 | M2nutAF4/H1.6 |  |  | Especificacion dimensional; proveedor por confirmar
V15_HW_SERVICE_MG12_1_WASHER | 00306b1cc62c121cfee7083ad1645e5729eb49d420088418eed87efa6372c4d2 | WASHER | WASHER | 1 | washerOD4.2/ID2.2/h.3 |  |  | Especificacion dimensional; proveedor por confirmar
V15_HW_SERVICE_MG13_0_BOLT_M2x8 | 9c7182721f65cc863fdf1e17f639845af8026449e3f2e95c69b5d17d01318491 | SCREW | M2x8 | 1 | M2x8 headOD4/H2; {} |  |  | Especificacion dimensional; proveedor por confirmar
V15_HW_SERVICE_MG13_0_NUT | 6894861d39efce08efd06c3f68db9b9a0e554e1b32df2fcc556c3ed29245f80f | NUT | M2 AF4 h1.6 | 1 | M2nutAF4/H1.6 |  |  | Especificacion dimensional; proveedor por confirmar
V15_HW_SERVICE_MG13_0_WASHER | a7575c6ffa8afa2a729821bd36fad1ac4a92742d07ea46dc5a250fc8bc818200 | WASHER | WASHER | 1 | washerOD4.2/ID2.2/h.3 |  |  | Especificacion dimensional; proveedor por confirmar
V15_HW_SERVICE_MG13_1_BOLT_M2x8 | 8b64f79afff7d7d8e6a2184fbe2c945e78b48d5021ecf74a29f7f38214145cea | SCREW | M2x8 | 1 | M2x8 headOD4/H2; {} |  |  | Especificacion dimensional; proveedor por confirmar
V15_HW_SERVICE_MG13_1_NUT | 991529dcb1f3c3cd7c8e6c55ec03e13933726e9edd3f1dad71cb0b3e3ddc66d7 | NUT | M2 AF4 h1.6 | 1 | M2nutAF4/H1.6 |  |  | Especificacion dimensional; proveedor por confirmar
V15_HW_SERVICE_MG13_1_WASHER | 7a5732e573c894bde517eec90ffd2a2f46f4ad8fc7f922179d12da95d67c5e68 | WASHER | WASHER | 1 | washerOD4.2/ID2.2/h.3 |  |  | Especificacion dimensional; proveedor por confirmar
V7_HEAD_HW_CORE_0 | b064f4c6f6a6a29a5775118621b5bca20cdfbb96a335eae678eecddf32fe5eb4 | SCREW | M2x18 | 1 | headOD<=4.8 h<=2.0 |  |  | Especificacion dimensional; proveedor por confirmar
V7_HEAD_HW_CORE_0 | b064f4c6f6a6a29a5775118621b5bca20cdfbb96a335eae678eecddf32fe5eb4 | NUT | M2 AF4 h1.6 | 1 |  |  |  | Especificacion dimensional; proveedor por confirmar
V7_HEAD_HW_CORE_0 | b064f4c6f6a6a29a5775118621b5bca20cdfbb96a335eae678eecddf32fe5eb4 | WASHER | OD5 ID2.2 h0.3 | 1 |  |  |  | Especificacion dimensional; proveedor por confirmar
V7_HEAD_HW_CORE_0 | b064f4c6f6a6a29a5775118621b5bca20cdfbb96a335eae678eecddf32fe5eb4 | HARD_SHIM | OD5 ID2.2 h0.3 | 1 |  |  |  | Especificacion dimensional; proveedor por confirmar
V7_HEAD_HW_CORE_1 | 115be47b912ca0f3fce7ddca01ef496bb60b6a83222c3f0a6f913426e942bd3a | SCREW | M2x18 | 1 | headOD<=4.8 h<=2.0 |  |  | Especificacion dimensional; proveedor por confirmar
V7_HEAD_HW_CORE_1 | 115be47b912ca0f3fce7ddca01ef496bb60b6a83222c3f0a6f913426e942bd3a | NUT | M2 AF4 h1.6 | 1 |  |  |  | Especificacion dimensional; proveedor por confirmar
V7_HEAD_HW_CORE_1 | 115be47b912ca0f3fce7ddca01ef496bb60b6a83222c3f0a6f913426e942bd3a | WASHER | OD5 ID2.2 h0.3 | 1 |  |  |  | Especificacion dimensional; proveedor por confirmar
V7_HEAD_HW_CORE_1 | 115be47b912ca0f3fce7ddca01ef496bb60b6a83222c3f0a6f913426e942bd3a | HARD_SHIM | OD5 ID2.2 h0.3 | 1 |  |  |  | Especificacion dimensional; proveedor por confirmar
V7_HEAD_HW_CORE_2 | 58531a8bc9efe0e5577df40d64a4d2b418e21a7d70cfc4d8c583bbd8a01e0457 | SCREW | M2x20 | 1 | headOD<=4.8 h<=2.0 |  |  | Especificacion dimensional; proveedor por confirmar
V7_HEAD_HW_CORE_2 | 58531a8bc9efe0e5577df40d64a4d2b418e21a7d70cfc4d8c583bbd8a01e0457 | NUT | M2 AF4 h1.6 | 1 |  |  |  | Especificacion dimensional; proveedor por confirmar
V7_HEAD_HW_CORE_2 | 58531a8bc9efe0e5577df40d64a4d2b418e21a7d70cfc4d8c583bbd8a01e0457 | WASHER | OD5 ID2.2 h0.3 | 1 |  |  |  | Especificacion dimensional; proveedor por confirmar
V7_HEAD_HW_CORE_2 | 58531a8bc9efe0e5577df40d64a4d2b418e21a7d70cfc4d8c583bbd8a01e0457 | HARD_SHIM | OD5 ID2.2 h0.3 | 1 |  |  |  | Especificacion dimensional; proveedor por confirmar
V7_HEAD_HW_FACE_0 | f5af0e15b86a8be58252ab4384d95c8fbd9669ed0cbbe4d1dbe2b177ec5eb337 | SCREW | M2x10 | 1 | headOD<=4.8 h<=2.0 |  |  | Especificacion dimensional; proveedor por confirmar
V7_HEAD_HW_FACE_0 | f5af0e15b86a8be58252ab4384d95c8fbd9669ed0cbbe4d1dbe2b177ec5eb337 | NUT | M2 AF4 h1.6 | 1 |  |  |  | Especificacion dimensional; proveedor por confirmar
V7_HEAD_HW_FACE_0 | f5af0e15b86a8be58252ab4384d95c8fbd9669ed0cbbe4d1dbe2b177ec5eb337 | WASHER | OD5 ID2.2 h0.3 | 1 |  |  |  | Especificacion dimensional; proveedor por confirmar
V7_HEAD_HW_FACE_0 | f5af0e15b86a8be58252ab4384d95c8fbd9669ed0cbbe4d1dbe2b177ec5eb337 | HARD_SHIM | OD5 ID2.2 h0.3 | 1 |  |  |  | Especificacion dimensional; proveedor por confirmar
V7_HEAD_HW_FACE_1 | f4878c62375f1ad38eae082b2c6b6287832b1e1ddc0b18e45f7f2715e3ff6f6a | SCREW | M2x10 | 1 | headOD<=4.8 h<=2.0 |  |  | Especificacion dimensional; proveedor por confirmar
V7_HEAD_HW_FACE_1 | f4878c62375f1ad38eae082b2c6b6287832b1e1ddc0b18e45f7f2715e3ff6f6a | NUT | M2 AF4 h1.6 | 1 |  |  |  | Especificacion dimensional; proveedor por confirmar
V7_HEAD_HW_FACE_1 | f4878c62375f1ad38eae082b2c6b6287832b1e1ddc0b18e45f7f2715e3ff6f6a | WASHER | OD5 ID2.2 h0.3 | 1 |  |  |  | Especificacion dimensional; proveedor por confirmar
V7_HEAD_HW_FACE_1 | f4878c62375f1ad38eae082b2c6b6287832b1e1ddc0b18e45f7f2715e3ff6f6a | HARD_SHIM | OD5 ID2.2 h0.3 | 1 |  |  |  | Especificacion dimensional; proveedor por confirmar
V7_HEAD_HW_FACE_2 | 32df8a59b27b85acfc2ab599360e5c48879b559123a52354bd77675c8fb68e1d | SCREW | M2x8 | 1 | headOD<=4.8 h<=2.0 |  |  | Especificacion dimensional; proveedor por confirmar
V7_HEAD_HW_FACE_2 | 32df8a59b27b85acfc2ab599360e5c48879b559123a52354bd77675c8fb68e1d | NUT | M2 AF4 h1.6 | 1 |  |  |  | Especificacion dimensional; proveedor por confirmar
V7_HEAD_HW_FACE_2 | 32df8a59b27b85acfc2ab599360e5c48879b559123a52354bd77675c8fb68e1d | WASHER | OD5 ID2.2 h0.3 | 1 |  |  |  | Especificacion dimensional; proveedor por confirmar
V7_HEAD_HW_FACE_2 | 32df8a59b27b85acfc2ab599360e5c48879b559123a52354bd77675c8fb68e1d | HARD_SHIM | OD5 ID2.2 h0.3 | 1 |  |  |  | Especificacion dimensional; proveedor por confirmar
V7_HEAD_HW_FACE_3 | 630fdcfa85361f81756afdb37bec767bc7efd7c20ad1753721c8b74c566228da | SCREW | M2x8 | 1 | headOD<=4.8 h<=2.0 |  |  | Especificacion dimensional; proveedor por confirmar
V7_HEAD_HW_FACE_3 | 630fdcfa85361f81756afdb37bec767bc7efd7c20ad1753721c8b74c566228da | NUT | M2 AF4 h1.6 | 1 |  |  |  | Especificacion dimensional; proveedor por confirmar
V7_HEAD_HW_FACE_3 | 630fdcfa85361f81756afdb37bec767bc7efd7c20ad1753721c8b74c566228da | WASHER | OD5 ID2.2 h0.3 | 1 |  |  |  | Especificacion dimensional; proveedor por confirmar
V7_HEAD_HW_FACE_3 | 630fdcfa85361f81756afdb37bec767bc7efd7c20ad1753721c8b74c566228da | HARD_SHIM | OD5 ID2.2 h0.3 | 1 |  |  |  | Especificacion dimensional; proveedor por confirmar
V7_HEAD_HW_JAW_0 | 1ef7a0d9c5135526a79131913bafcc1ca9395cd34c03b2628aeba72e76a2ffe8 | SCREW | M2x8 | 1 | headOD<=4.8 h<=2.0 |  |  | Especificacion dimensional; proveedor por confirmar
V7_HEAD_HW_JAW_0 | 1ef7a0d9c5135526a79131913bafcc1ca9395cd34c03b2628aeba72e76a2ffe8 | NUT | M2 AF4 h1.6 | 1 |  |  |  | Especificacion dimensional; proveedor por confirmar
V7_HEAD_HW_JAW_0 | 1ef7a0d9c5135526a79131913bafcc1ca9395cd34c03b2628aeba72e76a2ffe8 | WASHER | OD5 ID2.2 h0.3 | 1 |  |  |  | Especificacion dimensional; proveedor por confirmar
V7_HEAD_HW_JAW_0 | 1ef7a0d9c5135526a79131913bafcc1ca9395cd34c03b2628aeba72e76a2ffe8 | HARD_SHIM | OD5 ID2.2 h0.3 | 1 |  |  |  | Especificacion dimensional; proveedor por confirmar
V7_HEAD_HW_JAW_1 | f65d89a4b5f3d9208376ece30c2bd4391f8d56a25e9346899fefe64589ab959c | SCREW | M2x8 | 1 | headOD<=4.8 h<=2.0 |  |  | Especificacion dimensional; proveedor por confirmar
V7_HEAD_HW_JAW_1 | f65d89a4b5f3d9208376ece30c2bd4391f8d56a25e9346899fefe64589ab959c | NUT | M2 AF4 h1.6 | 1 |  |  |  | Especificacion dimensional; proveedor por confirmar
V7_HEAD_HW_JAW_1 | f65d89a4b5f3d9208376ece30c2bd4391f8d56a25e9346899fefe64589ab959c | WASHER | OD5 ID2.2 h0.3 | 1 |  |  |  | Especificacion dimensional; proveedor por confirmar
V7_HEAD_HW_JAW_1 | f65d89a4b5f3d9208376ece30c2bd4391f8d56a25e9346899fefe64589ab959c | HARD_SHIM | OD5 ID2.2 h0.3 | 1 |  |  |  | Especificacion dimensional; proveedor por confirmar
V7_HEAD_HW_PI_CORE_0 | 58ff20c53f91f33e41322032b490d7cb3bbd89fb3c9d3883e83dac7ff28df7e1 | SCREW | M2x8 | 1 | headOD<=4.8 h<=2.0 |  |  | Especificacion dimensional; proveedor por confirmar
V7_HEAD_HW_PI_CORE_0 | 58ff20c53f91f33e41322032b490d7cb3bbd89fb3c9d3883e83dac7ff28df7e1 | NUT | M2 AF4 h1.6 | 1 |  |  |  | Especificacion dimensional; proveedor por confirmar
V7_HEAD_HW_PI_CORE_0 | 58ff20c53f91f33e41322032b490d7cb3bbd89fb3c9d3883e83dac7ff28df7e1 | WASHER | OD5 ID2.2 h0.3 | 2 |  |  |  | Especificacion dimensional; proveedor por confirmar
V7_HEAD_HW_PI_CORE_1 | 5f9b765586bf299a9087df622194a6574c8041de71da61425e50b06ed8db0d7a | SCREW | M2x8 | 1 | headOD<=4.8 h<=2.0 |  |  | Especificacion dimensional; proveedor por confirmar
V7_HEAD_HW_PI_CORE_1 | 5f9b765586bf299a9087df622194a6574c8041de71da61425e50b06ed8db0d7a | NUT | M2 AF4 h1.6 | 1 |  |  |  | Especificacion dimensional; proveedor por confirmar
V7_HEAD_HW_PI_CORE_1 | 5f9b765586bf299a9087df622194a6574c8041de71da61425e50b06ed8db0d7a | WASHER | OD5 ID2.2 h0.3 | 2 |  |  |  | Especificacion dimensional; proveedor por confirmar
V7_HEAD_HW_PI_CORE_2 | 9bbfd4477d5d960c9c0f24273d62edb8d5389f077f16b6588a51ff88ceb1ee8f | SCREW | M2x25 | 1 | headOD<=4.8 h<=2.0 |  |  | Especificacion dimensional; proveedor por confirmar
V7_HEAD_HW_PI_CORE_2 | 9bbfd4477d5d960c9c0f24273d62edb8d5389f077f16b6588a51ff88ceb1ee8f | NUT | M2 AF4 h1.6 | 1 |  |  |  | Especificacion dimensional; proveedor por confirmar
V7_HEAD_HW_PI_CORE_2 | 9bbfd4477d5d960c9c0f24273d62edb8d5389f077f16b6588a51ff88ceb1ee8f | WASHER | OD5 ID2.2 h0.3 | 2 |  |  |  | Especificacion dimensional; proveedor por confirmar
V7_HEAD_HW_TOP_0 | c403ec1738ec215c691e3ac4e98c7b0c8ee71f13ca8c7e1931a58243cb91fecb | SCREW | M2x10 | 1 | headOD<=4.8 h<=2.0 |  |  | Especificacion dimensional; proveedor por confirmar
V7_HEAD_HW_TOP_0 | c403ec1738ec215c691e3ac4e98c7b0c8ee71f13ca8c7e1931a58243cb91fecb | NUT | M2 AF4 h1.6 | 1 |  |  |  | Especificacion dimensional; proveedor por confirmar
V7_HEAD_HW_TOP_0 | c403ec1738ec215c691e3ac4e98c7b0c8ee71f13ca8c7e1931a58243cb91fecb | WASHER | OD5 ID2.2 h0.3 | 1 |  |  |  | Especificacion dimensional; proveedor por confirmar
V7_HEAD_HW_TOP_0 | c403ec1738ec215c691e3ac4e98c7b0c8ee71f13ca8c7e1931a58243cb91fecb | HARD_SHIM | OD5 ID2.2 h0.3 | 1 |  |  |  | Especificacion dimensional; proveedor por confirmar
V7_HEAD_HW_TOP_1 | 79bae3bd0d358fe2c246d6d69e1839fe0211cdb4e768a76067285a24ff4fdf3e | SCREW | M2x8 | 1 | headOD<=4.8 h<=2.0 |  |  | Especificacion dimensional; proveedor por confirmar
V7_HEAD_HW_TOP_1 | 79bae3bd0d358fe2c246d6d69e1839fe0211cdb4e768a76067285a24ff4fdf3e | NUT | M2 AF4 h1.6 | 1 |  |  |  | Especificacion dimensional; proveedor por confirmar
V7_HEAD_HW_TOP_1 | 79bae3bd0d358fe2c246d6d69e1839fe0211cdb4e768a76067285a24ff4fdf3e | WASHER | OD5 ID2.2 h0.3 | 1 |  |  |  | Especificacion dimensional; proveedor por confirmar
V7_HEAD_HW_TOP_1 | 79bae3bd0d358fe2c246d6d69e1839fe0211cdb4e768a76067285a24ff4fdf3e | HARD_SHIM | OD5 ID2.2 h0.3 | 1 |  |  |  | Especificacion dimensional; proveedor por confirmar
V7_HEAD_HW_TOP_2 | 3b42774a8fbed97178a496a16504b426727679459156e542152f3a6d9d3c68d6 | SCREW | M2x8 | 1 | headOD<=4.8 h<=2.0 |  |  | Especificacion dimensional; proveedor por confirmar
V7_HEAD_HW_TOP_2 | 3b42774a8fbed97178a496a16504b426727679459156e542152f3a6d9d3c68d6 | NUT | M2 AF4 h1.6 | 1 |  |  |  | Especificacion dimensional; proveedor por confirmar
V7_HEAD_HW_TOP_2 | 3b42774a8fbed97178a496a16504b426727679459156e542152f3a6d9d3c68d6 | WASHER | OD5 ID2.2 h0.3 | 1 |  |  |  | Especificacion dimensional; proveedor por confirmar
V7_HEAD_HW_TOP_2 | 3b42774a8fbed97178a496a16504b426727679459156e542152f3a6d9d3c68d6 | HARD_SHIM | OD5 ID2.2 h0.3 | 1 |  |  |  | Especificacion dimensional; proveedor por confirmar
V7_HEAD_HW_TOP_3 | 744a0bc49ee55ca1c40a33a0e82c7e2ac9a1fbd69aec6486d1ae724732e379f4 | SCREW | M2x8 | 1 | headOD<=4.8 h<=2.0 |  |  | Especificacion dimensional; proveedor por confirmar
V7_HEAD_HW_TOP_3 | 744a0bc49ee55ca1c40a33a0e82c7e2ac9a1fbd69aec6486d1ae724732e379f4 | NUT | M2 AF4 h1.6 | 1 |  |  |  | Especificacion dimensional; proveedor por confirmar
V7_HEAD_HW_TOP_3 | 744a0bc49ee55ca1c40a33a0e82c7e2ac9a1fbd69aec6486d1ae724732e379f4 | WASHER | OD5 ID2.2 h0.3 | 1 |  |  |  | Especificacion dimensional; proveedor por confirmar
V7_HEAD_HW_TOP_3 | 744a0bc49ee55ca1c40a33a0e82c7e2ac9a1fbd69aec6486d1ae724732e379f4 | HARD_SHIM | OD5 ID2.2 h0.3 | 1 |  |  |  | Especificacion dimensional; proveedor por confirmar
V7_HW_CAP00_0_M2x6 | 40ce03c2aafa2e2e154a201d81aaba9958de03ff257998e303a0cf8205e530b0 | SCREW | M2x5.8 | 1 | M2, Lbajo cabeza5.8, cabezaOD<=4/h<=2; stockM2x6; {"length_under_head_mm": 5.8, "head_diameter_max_mm": 4.0, "head_height_max_mm": 2.0} | Preparar desdeM2x6: longitud final5.8mm bajo cabeza, desbarbar y verificar rosca. |  | Especificacion dimensional; proveedor por confirmar
V7_HW_CAP00_0_NUT | c366f25b4c53c0fda8b96805b28880ce992442dc72f6b44bbeb897c051a372f8 | NUT | M2 AF4 h1.6 | 1 |  |  |  | Especificacion dimensional; proveedor por confirmar
V7_HW_CAP00_0_WASHER | 6fa3a437df7649d0b82db9019abd0c744a08c0fdf5d44f7013e950844dbd19ed | WASHER | OD4.2 ID2.2 h0.4 | 1 |  |  |  | Especificacion dimensional; proveedor por confirmar
V7_HW_CAP00_1_M2x6 | bfc7a35e1927fd477f79a1440efc9e3a8c1f1ba3413674238e35dc388663f9d9 | SCREW | M2x5.8 | 1 | M2, Lbajo cabeza5.8, cabezaOD<=4/h<=2; stockM2x6; {"length_under_head_mm": 5.8, "head_diameter_max_mm": 4.0, "head_height_max_mm": 2.0} | Preparar desdeM2x6: longitud final5.8mm bajo cabeza, desbarbar y verificar rosca. |  | Especificacion dimensional; proveedor por confirmar
V7_HW_CAP00_1_NUT | 53a1ff5cbd05eeef3385b0931fdce66d02656c7aa50db54720b1af01bd9f517f | NUT | M2 AF4 h1.6 | 1 |  |  |  | Especificacion dimensional; proveedor por confirmar
V7_HW_CAP00_1_WASHER | 764d7409e00937db8ba3b801b402712a3caabc6110bf1f73bcc072b1688bced7 | WASHER | OD4.2 ID2.2 h0.4 | 1 |  |  |  | Especificacion dimensional; proveedor por confirmar
V7_HW_CAP01_0_M2x6 | 18fb4a4edd420e8036502ab79233b70bbe6187147966b4f19b6eb0465637a70c | SCREW | M2x5.8 | 1 | M2, Lbajo cabeza5.8, cabezaOD<=4/h<=2; stockM2x6; {"length_under_head_mm": 5.8, "head_diameter_max_mm": 4.0, "head_height_max_mm": 2.0} | Preparar desdeM2x6: longitud final5.8mm bajo cabeza, desbarbar y verificar rosca. |  | Especificacion dimensional; proveedor por confirmar
V7_HW_CAP01_0_NUT | 4415b5420b459ccbf53b80b0d6315f387324b5f61ad4535ff1b7b60f842de5a8 | NUT | M2 AF4 h1.6 | 1 |  |  |  | Especificacion dimensional; proveedor por confirmar
V7_HW_CAP01_0_WASHER | c15cdea1cc20768fc83f9515f39a4c776cf557f49076cc410e4b34ffab55765e | WASHER | OD4.2 ID2.2 h0.4 | 1 |  |  |  | Especificacion dimensional; proveedor por confirmar
V7_HW_CAP01_1_M2x6 | 2befe2dd20ce5a7741e9357e28c914773d0946b218ca011aaee65e0ec56e7d1f | SCREW | M2x5.8 | 1 | M2, Lbajo cabeza5.8, cabezaOD<=4/h<=2; stockM2x6; {"length_under_head_mm": 5.8, "head_diameter_max_mm": 4.0, "head_height_max_mm": 2.0} | Preparar desdeM2x6: longitud final5.8mm bajo cabeza, desbarbar y verificar rosca. |  | Especificacion dimensional; proveedor por confirmar
V7_HW_CAP01_1_NUT | 75c6dd1ad31b6bffb20ae53cb4853f53e0ca51d82dfa491e8cd64aaf23f4e4c4 | NUT | M2 AF4 h1.6 | 1 |  |  |  | Especificacion dimensional; proveedor por confirmar
V7_HW_CAP01_1_WASHER | fc4a26ea5032f1deca69364b34d02a3167b528833937bef64389d25d22157589 | WASHER | OD4.2 ID2.2 h0.4 | 1 |  |  |  | Especificacion dimensional; proveedor por confirmar
V7_HW_CAP02_0_M2x6 | f803cf8cc0f0d033d1a29b26764673a3bf60e77a7ef3916ea33d9e7e34ffd12e | SCREW | M2x5.8 | 1 | M2, Lbajo cabeza5.8, cabezaOD<=4/h<=2; stockM2x6; {"length_under_head_mm": 5.8, "head_diameter_max_mm": 4.0, "head_height_max_mm": 2.0} | Preparar desdeM2x6: longitud final5.8mm bajo cabeza, desbarbar y verificar rosca. |  | Especificacion dimensional; proveedor por confirmar
V7_HW_CAP02_0_NUT | f595c983fa923078f8b0707a21c1d2ac299ba5c367af7dc3ddeb9f9718f34386 | NUT | M2 AF4 h1.6 | 1 |  |  |  | Especificacion dimensional; proveedor por confirmar
V7_HW_CAP02_0_WASHER | 048ba0fb43cd50835d65630c678e2e425878c22cccad992985fc968b4e5cba9d | WASHER | OD4.2 ID2.2 h0.4 | 1 |  |  |  | Especificacion dimensional; proveedor por confirmar
V7_HW_CAP02_1_M2x6 | 580b6646c417b4df61404925ab0775c6662090859fc756f898dde627719b978c | SCREW | M2x5.8 | 1 | M2, Lbajo cabeza5.8, cabezaOD<=4/h<=2; stockM2x6; {"length_under_head_mm": 5.8, "head_diameter_max_mm": 4.0, "head_height_max_mm": 2.0} | Preparar desdeM2x6: longitud final5.8mm bajo cabeza, desbarbar y verificar rosca. |  | Especificacion dimensional; proveedor por confirmar
V7_HW_CAP02_1_NUT | a6c36d51fbaaf3b498d0f164cb8c81bbe8febecd1771f9e6d2d95fa165482ab6 | NUT | M2 AF4 h1.6 | 1 |  |  |  | Especificacion dimensional; proveedor por confirmar
V7_HW_CAP02_1_WASHER | d194821f4459554176fdeb4a3c8907be4d53b8ab6f3fca070d6f7d1d1ed8492d | WASHER | OD4.2 ID2.2 h0.4 | 1 |  |  |  | Especificacion dimensional; proveedor por confirmar
V7_HW_CAP03_0_M2x6 | 300adde20b2250cfbe0c0a5be62f7738def9cced79fc145739cec2a71a34b871 | SCREW | M2x5.8 | 1 | M2, Lbajo cabeza5.8, cabezaOD<=4/h<=2; stockM2x6; {"length_under_head_mm": 5.8, "head_diameter_max_mm": 4.0, "head_height_max_mm": 2.0} | Preparar desdeM2x6: longitud final5.8mm bajo cabeza, desbarbar y verificar rosca. |  | Especificacion dimensional; proveedor por confirmar
V7_HW_CAP03_0_NUT | 095f0993238e8670cd338c7736cd0290ad6fa12a14d1f0da6ea889136aafbd83 | NUT | M2 AF4 h1.6 | 1 |  |  |  | Especificacion dimensional; proveedor por confirmar
V7_HW_CAP03_0_WASHER | f2dc59369b5bb6f2dc650168166eabf8fa06a6d15c940d249c4ebb06439a1236 | WASHER | OD4.2 ID2.2 h0.4 | 1 |  |  |  | Especificacion dimensional; proveedor por confirmar
V7_HW_CAP03_1_M2x6 | 1af48c40e0b5ae076cad666b30a10d12f0d6189bb1ff20a611bf5c8f084bf285 | SCREW | M2x5.8 | 1 | M2, Lbajo cabeza5.8, cabezaOD<=4/h<=2; stockM2x6; {"length_under_head_mm": 5.8, "head_diameter_max_mm": 4.0, "head_height_max_mm": 2.0} | Preparar desdeM2x6: longitud final5.8mm bajo cabeza, desbarbar y verificar rosca. |  | Especificacion dimensional; proveedor por confirmar
V7_HW_CAP03_1_NUT | cce2af06146ad234d7700ea015772b08cf3369cf348908d42356600f467c1117 | NUT | M2 AF4 h1.6 | 1 |  |  |  | Especificacion dimensional; proveedor por confirmar
V7_HW_CAP03_1_WASHER | 73314ba5622fe6fae113560fca7a81e464dc8570117cb77ca04c70899d62da48 | WASHER | OD4.2 ID2.2 h0.4 | 1 |  |  |  | Especificacion dimensional; proveedor por confirmar
V7_HW_CAP04_0_M2x6 | e7c8e54abd3ade66db75b9c893e53bcbd45d49d6bc766da4e1f59d9dbf389b23 | SCREW | M2x6 | 1 | headOD<=4 h<=2 |  |  | Especificacion dimensional; proveedor por confirmar
V7_HW_CAP04_0_NUT | 8a2af9f951eae09b0573e4180d294840c8f7b2985d659a2b4ceca34424116efe | NUT | M2 AF4 h1.6 | 1 |  |  |  | Especificacion dimensional; proveedor por confirmar
V7_HW_CAP04_0_WASHER | 7c3e44f73121dc4c9d2f5cf61ab4ad260a8f75fb3f821b9ea6bb517b23323a1b | WASHER | OD4.2 ID2.2 h0.4 | 1 |  |  |  | Especificacion dimensional; proveedor por confirmar
V7_HW_CAP04_1_M2x6 | bc725e4239ef22901f3f34ee8ba9538d426377b345d71ee2763b0ed5e574eabb | SCREW | M2x6 | 1 | headOD<=4 h<=2 |  |  | Especificacion dimensional; proveedor por confirmar
V7_HW_CAP04_1_NUT | 57e8810631773c0927aae3d355e7056720338d1325d0c854c8e08519067ecb5c | NUT | M2 AF4 h1.6 | 1 |  |  |  | Especificacion dimensional; proveedor por confirmar
V7_HW_CAP04_1_WASHER | bf7f7c8e1e45790b98cba90e51186635f763cdc51bfb8f05649d2b3d07b7ad22 | WASHER | OD4.2 ID2.2 h0.4 | 1 |  |  |  | Especificacion dimensional; proveedor por confirmar
V7_HW_CAP05_0_M2x6 | 5c06ee0e3b186c818edc855ce8fe261e72970913d7716bbdf0373a8f68592443 | SCREW | M2x6 | 1 | headOD<=4 h<=2 |  |  | Especificacion dimensional; proveedor por confirmar
V7_HW_CAP05_0_NUT | 395e5dbb8dbdbad8c243da34af6959c15e51741c5d3921b83e676b711fc53059 | NUT | M2 AF4 h1.6 | 1 |  |  |  | Especificacion dimensional; proveedor por confirmar
V7_HW_CAP05_0_WASHER | b13aed7a750afd0d7f26223f03dd6d77c3600a049634b1761cbbdfce8d0a367f | WASHER | OD4.2 ID2.2 h0.4 | 1 |  |  |  | Especificacion dimensional; proveedor por confirmar
V7_HW_CAP05_1_M2x6 | 61e3904d700a1ecb72ebcddc1d4f46eac738085a66a4d474b9e2b7a5b5885091 | SCREW | M2x6 | 1 | headOD<=4 h<=2 |  |  | Especificacion dimensional; proveedor por confirmar
V7_HW_CAP05_1_NUT | aabb4395428e4480872bb89154ad01ac7e18be865307de7dbb66d6a0e928ad01 | NUT | M2 AF4 h1.6 | 1 |  |  |  | Especificacion dimensional; proveedor por confirmar
V7_HW_CAP05_1_WASHER | f70b5505c29e4b74d68ffb6efba0bc2bacb232ee2230885f93cf3fa188dcbca3 | WASHER | OD4.2 ID2.2 h0.4 | 1 |  |  |  | Especificacion dimensional; proveedor por confirmar
V7_HW_CAP06_0_M2x6 | 1bcd5bc6163fc364add82a4dd968d4147c60c2b15f1fe18c72253ef90782e06f | SCREW | M2x6 | 1 | headOD<=4 h<=2 |  |  | Especificacion dimensional; proveedor por confirmar
V7_HW_CAP06_0_NUT | 82d7c8797c6796b07a801982c90f6bc81ed0bcb0735c07f7c486a7ad0a10d9cf | NUT | M2 AF4 h1.6 | 1 |  |  |  | Especificacion dimensional; proveedor por confirmar
V7_HW_CAP06_0_WASHER | dd7919f2a96ba29b790f6847294f5d9ce8891e541244bb05469406573efb0ff3 | WASHER | OD4.2 ID2.2 h0.4 | 1 |  |  |  | Especificacion dimensional; proveedor por confirmar
V7_HW_CAP06_1_M2x6 | f5d0cf677cfcf0f3d26f0341f31a1217676169a600eef50dabec6f1dba16c3f4 | SCREW | M2x6 NBK SSHS-M2-6-SD ultra-low small-head screw | 1 | NBK SSHS-M2-6-SD ultra-low small-head screw; {"length_under_head_mm": 6, "head_diameter_mm": 3.2, "head_height_mm": 1.1} |  | https://www.nbk1560.com/images/en-US/product/lowsmallheadscrew/SSHS-SD/SSHS-SD_1.pdf | SKU dimensional citado; existencias no verificadas
V7_HW_CAP06_1_NUT | ad3bcb92ba350341e6dd964b2900331bd5db12211c25a322752b9e57027fbd79 | NUT | M2 AF4 h1.6 | 1 |  |  |  | Especificacion dimensional; proveedor por confirmar
V7_HW_CAP06_1_WASHER | 67d0f08ae232e2a6602f8bdaf8855ace94e7f5ab4a3d3fd8e2902a76e42d6a0b | WASHER | OD4.2 ID2.2 h0.4 | 1 |  |  |  | Especificacion dimensional; proveedor por confirmar
V7_HW_CAP07_0_M2x6 | 729a5b20a9cee7d49b7b4ca480539764478e8e0da88bdbf73a84cb0ff89b09b2 | SCREW | M2x6 | 1 | headOD<=4 h<=2 |  |  | Especificacion dimensional; proveedor por confirmar
V7_HW_CAP07_0_NUT | 06337e16f11506df64a6ac3c323cc538339eea7099707043d4ea7ce1c5938ed3 | NUT | M2 AF4 h1.6 | 1 |  |  |  | Especificacion dimensional; proveedor por confirmar
V7_HW_CAP07_0_WASHER | 1532ff9b0a10e470ca6b85faaca0be601a398abf4036bf40da2d7a322db5efc5 | WASHER | OD4.2 ID2.2 h0.4 | 1 |  |  |  | Especificacion dimensional; proveedor por confirmar
V7_HW_CAP07_1_M2x6 | 718c40ed887e9d59cda51936ea97115763a7059981693e45102fee6bb696105d | SCREW | M2x6 | 1 | headOD<=4 h<=2 |  |  | Especificacion dimensional; proveedor por confirmar
V7_HW_CAP07_1_NUT | 792bf1d8cad8f0896b82fa023cf19535bde5edeecaaf1655f293714d1a050a5c | NUT | M2 AF4 h1.6 | 1 |  |  |  | Especificacion dimensional; proveedor por confirmar
V7_HW_CAP07_1_WASHER | 911cb3975ef517453abac8119ba06ebf88d4cd88af40670fde6a628ea3a2cee2 | WASHER | OD4.2 ID2.2 h0.4 | 1 |  |  |  | Especificacion dimensional; proveedor por confirmar
V7_HW_CAP08_0_M2x6 | b0097f458886cba21320745a58701431fad1c628974382aeb680d475269bc907 | SCREW | M2x6 | 1 | headOD<=4 h<=2 |  |  | Especificacion dimensional; proveedor por confirmar
V7_HW_CAP08_0_NUT | 686b18284f76c408f1edbe5755a83cb20c1412688dd02788399d841e88f06fdf | NUT | M2 AF4 h1.6 | 1 |  |  |  | Especificacion dimensional; proveedor por confirmar
V7_HW_CAP08_0_WASHER | a9a17a544fd1eb50ff0113c0f0492189dee3fffed4874ecca0a373fe0def42cf | WASHER | OD4.2 ID2.2 h0.4 | 1 |  |  |  | Especificacion dimensional; proveedor por confirmar
V7_HW_CAP08_1_M2x6 | f6969a058a59da34a003a319f753d3dbdccb5b7a82692bb52af7b49a51a5a9ba | SCREW | M2x6 | 1 | headOD<=4 h<=2 |  |  | Especificacion dimensional; proveedor por confirmar
V7_HW_CAP08_1_NUT | 4a87370b3faafc36a0ffcf2b6f1244c7625d95288b2524fa3510259e02ca1c8c | NUT | M2 AF4 h1.6 | 1 |  |  |  | Especificacion dimensional; proveedor por confirmar
V7_HW_CAP08_1_WASHER | 1bb96edaaa73b956244b400d9fe9eb2400ef0c09adc935b61cb125d47beeb773 | WASHER | OD4.2 ID2.2 h0.4 | 1 |  |  |  | Especificacion dimensional; proveedor por confirmar
V7_HW_CAP10_0_M2x6 | 5a3203c497a8f16988da3c53034224982a2c9922b97c30642e02db38ba0f4fda | SCREW | M2x6 | 1 | headOD<=4 h<=2 |  |  | Especificacion dimensional; proveedor por confirmar
V7_HW_CAP10_0_NUT | 267f333b9fcb28abd2881ec898b764deef7169d3cb0a3b88958806fab954767e | NUT | M2 AF4 h1.6 | 1 |  |  |  | Especificacion dimensional; proveedor por confirmar
V7_HW_CAP10_0_WASHER | bbb36684b6ebf8bdebcfc2d8adcf4646e62e9afde4c071576cab8556ab6c8ebb | WASHER | OD4.2 ID2.2 h0.4 | 1 |  |  |  | Especificacion dimensional; proveedor por confirmar
V7_HW_CAP10_1_M2x6 | e45c24082486ecde1b2d9792ea1ae16589457c2e196c3c4e3c3c4d77dd3cdd0f | SCREW | M2x6 | 1 | headOD<=4 h<=2 |  |  | Especificacion dimensional; proveedor por confirmar
V7_HW_CAP10_1_NUT | 09ef0b5a0bdfcfee812b2baa14a9534c2f2934d755281763590b295de6718a33 | NUT | M2 AF4 h1.6 | 1 |  |  |  | Especificacion dimensional; proveedor por confirmar
V7_HW_CAP10_1_WASHER | 1a217ca01f2bee3f5e1be2122027448106172caf14988157c853358ad060a057 | WASHER | OD4.2 ID2.2 h0.4 | 1 |  |  |  | Especificacion dimensional; proveedor por confirmar
V7_HW_CAP11_0_M2x6 | 3be530b344ac66b233f1a4300b04194c2d8b0738a1768a5de0a50b1d0b439142 | SCREW | M2x5.8 | 1 | M2, Lbajo cabeza5.8, cabezaOD<=4/h<=2; stockM2x6; {"length_under_head_mm": 5.8, "head_diameter_max_mm": 4.0, "head_height_max_mm": 2.0} | Preparar desdeM2x6: longitud final5.8mm bajo cabeza, desbarbar y verificar rosca. |  | Especificacion dimensional; proveedor por confirmar
V7_HW_CAP11_0_NUT | 40e3b92ca0cc8c5353a1502a626baa0e29c49347407e77c02f00ed9f255ae5c5 | NUT | M2 AF4 h1.6 | 1 |  |  |  | Especificacion dimensional; proveedor por confirmar
V7_HW_CAP11_0_WASHER | 9d6e3841a0d7050c26d7270dab42411f1a03366da76d22ebd2afc4bd3ae52c0f | WASHER | OD4.2 ID2.2 h0.4 | 1 |  |  |  | Especificacion dimensional; proveedor por confirmar
V7_HW_CAP11_1_M2x6 | 41d33733433d85bbb8f3cff2196d08fa258480a69178f2998bdaf3237b38d5ae | SCREW | M2x5.8 | 1 | M2, Lbajo cabeza5.8, cabezaOD<=4/h<=2; stockM2x6; {"length_under_head_mm": 5.8, "head_diameter_max_mm": 4.0, "head_height_max_mm": 2.0} | Preparar desdeM2x6: longitud final5.8mm bajo cabeza, desbarbar y verificar rosca. |  | Especificacion dimensional; proveedor por confirmar
V7_HW_CAP11_1_NUT | b776f2518b7634a7a5ba5ecd0c09ac3e54b28ec53d00d56cbe31b5aebbbf2325 | NUT | M2 AF4 h1.6 | 1 |  |  |  | Especificacion dimensional; proveedor por confirmar
V7_HW_CAP11_1_WASHER | 84f3b75eb8ed1241d39609acf8e6c1e64df07cb732b827ba43621ca07ae3c1d5 | WASHER | OD4.2 ID2.2 h0.4 | 1 |  |  |  | Especificacion dimensional; proveedor por confirmar
V7_HW_CAP12_0_M2x6 | 22ed28b2526b49e518623fe07a481fdc4da3c5427b4eb45b9a3013ed40f7e9c6 | SCREW | M2x5.8 | 1 | M2, Lbajo cabeza5.8, cabezaOD<=4/h<=2; stockM2x6; {"length_under_head_mm": 5.8, "head_diameter_max_mm": 4.0, "head_height_max_mm": 2.0} | Preparar desdeM2x6: longitud final5.8mm bajo cabeza, desbarbar y verificar rosca. |  | Especificacion dimensional; proveedor por confirmar
V7_HW_CAP12_0_NUT | 460c68e4bb6f3a9d9dd9fe650e83f8e3d0e5edb9028ce7e9237391f7d3a142da | NUT | M2 AF4 h1.6 | 1 |  |  |  | Especificacion dimensional; proveedor por confirmar
V7_HW_CAP12_0_WASHER | 57af61f523242e0b88b1dc06cad072145d23ae991ca30dca916689a5f64d72e5 | WASHER | OD4.2 ID2.2 h0.4 | 1 |  |  |  | Especificacion dimensional; proveedor por confirmar
V7_HW_CAP12_1_M2x6 | 9551a66991bb2fefda801cc6061a0221697c52c8440016e4025cb86d10788ce4 | SCREW | M2x5.8 | 1 | M2, Lbajo cabeza5.8, cabezaOD<=4/h<=2; stockM2x6; {"length_under_head_mm": 5.8, "head_diameter_max_mm": 4.0, "head_height_max_mm": 2.0} | Preparar desdeM2x6: longitud final5.8mm bajo cabeza, desbarbar y verificar rosca. |  | Especificacion dimensional; proveedor por confirmar
V7_HW_CAP12_1_NUT | 30813f0265ad5088269e367914d60912bc782e324aaafb875fb34851ef02f7fb | NUT | M2 AF4 h1.6 | 1 |  |  |  | Especificacion dimensional; proveedor por confirmar
V7_HW_CAP12_1_WASHER | d550118cb121aee375cdab1e9bc5aa3b9124ca61da7386ea03cbe3a256d5577b | WASHER | OD4.2 ID2.2 h0.4 | 1 |  |  |  | Especificacion dimensional; proveedor por confirmar
V7_HW_CAP13_0_M2x6 | 76f6310ff4539285762abcd636531ef3555edbb80e647d8ea1de7497aa67a230 | SCREW | M2x6 | 1 | headOD<=4 h<=2 |  |  | Especificacion dimensional; proveedor por confirmar
V7_HW_CAP13_0_NUT | 4865e3b74a69c19495d5774feb76d494eeabf3d5274c74c34080c21c0a4b802b | NUT | M2 AF4 h1.6 | 1 |  |  |  | Especificacion dimensional; proveedor por confirmar
V7_HW_CAP13_0_WASHER | 09552ab35af1e2163648e25d772101da92102b279df11738249d7e64b636e31e | WASHER | OD4.2 ID2.2 h0.4 | 1 |  |  |  | Especificacion dimensional; proveedor por confirmar
V7_HW_CAP13_1_M2x6 | ab0338d37d62e1cede68483608e90069816891e0f8180c80f120446a4f31eed2 | SCREW | M2x6 | 1 | headOD<=4 h<=2 |  |  | Especificacion dimensional; proveedor por confirmar
V7_HW_CAP13_1_NUT | 5bdd478f8c6a2f0c1e464bb3c5c87ca73afdbe67b8414f1dd676a74e9a567b6a | NUT | M2 AF4 h1.6 | 1 |  |  |  | Especificacion dimensional; proveedor por confirmar
V7_HW_CAP13_1_WASHER | a976ee6131068ad567149821bc13bc1017e6cf55effe5d04a7650b4acdca5c63 | WASHER | OD4.2 ID2.2 h0.4 | 1 |  |  |  | Especificacion dimensional; proveedor por confirmar
V7_HW_CAP14_0_M2x6 | 3adaf6d31b84e38f18255ac3ab02c4c20a3acd6366b0cc640d4a55f00f7bb38f | SCREW | M2x6 | 1 | headOD<=4 h<=2 |  |  | Especificacion dimensional; proveedor por confirmar
V7_HW_CAP14_0_NUT | 3ade9c9149d6eadcef3bdde1994250913b608a726b44cc5ced5e31b19039ba1b | NUT | M2 AF4 h1.6 | 1 |  |  |  | Especificacion dimensional; proveedor por confirmar
V7_HW_CAP14_0_WASHER | d04cf50102761fbc14bb8fc3f75b66e5ba1e6bba4058f1609b1f998bf2ca7072 | WASHER | OD4.2 ID2.2 h0.4 | 1 |  |  |  | Especificacion dimensional; proveedor por confirmar
V7_HW_CAP14_1_M2x6 | d08f23a7294f63f6e6686b58b2ce9a650d155b9cd8ab399c8daa3f958c7ecaab | SCREW | M2x6 | 1 | headOD<=4 h<=2 |  |  | Especificacion dimensional; proveedor por confirmar
V7_HW_CAP14_1_NUT | baa3140963d8d0bece14a95bde957b371836bc1c570e8e8a73d926bb4cf6c900 | NUT | M2 AF4 h1.6 | 1 |  |  |  | Especificacion dimensional; proveedor por confirmar
V7_HW_CAP14_1_WASHER | d16583ad17a174ed8eed516c92c9dc2d99347a653cfa8c1bc6761eb561148868 | WASHER | OD4.2 ID2.2 h0.4 | 1 |  |  |  | Especificacion dimensional; proveedor por confirmar
V7_HW_MG00_F_M1p6x6 | 45b00edaff74a8a7aa34506c647ac3c8131aa2a2d3689e0ce6291d40eb4a86be | SCREW | M1.6x6 | 1 | headOD<=3.2 h<=1.6 |  |  | Especificacion dimensional; proveedor por confirmar
V7_HW_MG00_F_NUT | f5b5b427339b3b808cf6024d12a68d0bf115d4b3533f1c2e59b0b81330478b8e | NUT | M1.6 AF3.2 h1.3 | 1 |  |  |  | Especificacion dimensional; proveedor por confirmar
V7_HW_MG00_F_WASHER | c4f4a2572bbdf8cafdbb620481141f0e2b732a44b77e27db95984f580eb93837 | WASHER | OD4 ID1.8 h0.4 | 1 |  |  |  | Especificacion dimensional; proveedor por confirmar
V7_HW_MG00_R_M1p6x6 | 41152604e887d03f79180d6e404e587e36e542c9b57f426b44289026c3d49411 | SCREW | M1.6x6 | 1 | headOD<=3.2 h<=1.6 |  |  | Especificacion dimensional; proveedor por confirmar
V7_HW_MG00_R_NUT | 9deb897845269d0747a53ec004f092435c6637a6c1c642e85549d961a12b2531 | NUT | M1.6 AF3.2 h1.3 | 1 |  |  |  | Especificacion dimensional; proveedor por confirmar
V7_HW_MG00_R_WASHER | d13d99955225d5f9fcf4302f243fc8c758969dda611481c5d4f8fc7e279701e5 | WASHER | OD4 ID1.8 h0.4 | 1 |  |  |  | Especificacion dimensional; proveedor por confirmar
V7_HW_MG01_F_M1p6x6 | 7da591e9e207efd097c065d5ee3d290d48dff4af01dc5ace8ad659802115d39a | SCREW | M1.6x6 | 1 | headOD<=3.2 h<=1.6 |  |  | Especificacion dimensional; proveedor por confirmar
V7_HW_MG01_F_NUT | 9f8044766628c7ee4a0c65fcca266d91bcd803b32f12a90ab9172be4d376450b | NUT | M1.6 AF3.2 h1.3 | 1 |  |  |  | Especificacion dimensional; proveedor por confirmar
V7_HW_MG01_F_WASHER | cb91e7e88cb4234df19512fa30fd6c8d6ff99a8505980cb85b690251948808e6 | WASHER | OD4 ID1.8 h0.4 | 1 |  |  |  | Especificacion dimensional; proveedor por confirmar
V7_HW_MG01_R_M1p6x6 | c38c0afcf479175d2f0d7d88dc56005acdd8905f6b327381456ef44a2d14acd4 | SCREW | M1.6x6 | 1 | headOD<=3.2 h<=1.6 |  |  | Especificacion dimensional; proveedor por confirmar
V7_HW_MG01_R_NUT | 07767aa178d8bd364422c534ccc5f198da4b2e091cfcaf5049b2dcd48220f60f | NUT | M1.6 AF3.2 h1.3 | 1 |  |  |  | Especificacion dimensional; proveedor por confirmar
V7_HW_MG01_R_WASHER | 85f71fe285d03d3c4ed1f878646937d0c8952ad94af9fa961835751e6842c180 | WASHER | OD4 ID1.8 h0.4 | 1 |  |  |  | Especificacion dimensional; proveedor por confirmar
V7_HW_MG02_F_M1p6x6 | 748b0ec26bffc2ee8ddbde5ec49a26372bfaeb81c5b66d609f1d961e55a567cb | SCREW | M1.6x6 | 1 | headOD<=3.2 h<=1.6 |  |  | Especificacion dimensional; proveedor por confirmar
V7_HW_MG02_F_NUT | dce0f9523ce55548aed24500c05037aee8ddbc4e29284d9fcb67cdb040e9ae4a | NUT | M1.6 AF3.2 h1.3 | 1 |  |  |  | Especificacion dimensional; proveedor por confirmar
V7_HW_MG02_F_WASHER | b7bf9df6d20436fb8de12cdd36786fb99de926f762680d7a3253ae9919ba18e0 | WASHER | OD4 ID1.8 h0.4 | 1 |  |  |  | Especificacion dimensional; proveedor por confirmar
V7_HW_MG02_R_M1p6x6 | bddaf870d301c8245d2c5d5ccc85de51bb3b07b5517194e6537d3a258fbec88f | SCREW | M1.6x6 | 1 | headOD<=3.2 h<=1.6 |  |  | Especificacion dimensional; proveedor por confirmar
V7_HW_MG02_R_NUT | 7306b1ad86ced7c0cabb8e1874045190865929b627ae84ec9c774eb7b4a07699 | NUT | M1.6 AF3.2 h1.3 | 1 |  |  |  | Especificacion dimensional; proveedor por confirmar
V7_HW_MG02_R_WASHER | ba46e336fb26985e5218dc45970475c6e3e4e00fcb39ee886536d1fcfd658365 | WASHER | OD4 ID1.8 h0.4 | 1 |  |  |  | Especificacion dimensional; proveedor por confirmar
V7_HW_MG03_F_M1p6x6 | 876af267eb22caf543430b13e83e3ae1968989e857d193b2290899dddf739da7 | SCREW | M1.6x6 | 1 | headOD<=3.2 h<=1.6 |  |  | Especificacion dimensional; proveedor por confirmar
V7_HW_MG03_F_NUT | fa76c373738e363a374c2878cf258cb10b4771be89fd1877e9a04ae7464b982d | NUT | M1.6 AF3.2 h1.3 | 1 |  |  |  | Especificacion dimensional; proveedor por confirmar
V7_HW_MG03_F_WASHER | 3fadd23a4a5fafe3a625f362d78d5e44b2066bc778b4106cbfcf59364de46cf7 | WASHER | OD4 ID1.8 h0.4 | 1 |  |  |  | Especificacion dimensional; proveedor por confirmar
V7_HW_MG03_R_M1p6x6 | 9c3fa6ab6883b2fe18ff933ec62aea847737e076a0b42c190d22cd25759f3b91 | SCREW | M1.6x6 | 1 | headOD<=3.2 h<=1.6 |  |  | Especificacion dimensional; proveedor por confirmar
V7_HW_MG03_R_NUT | b5fbe7dddf50df0cebe15bfd489bc4da6d933dffc6a518228f7fc5913e9ad3d0 | NUT | M1.6 AF3.2 h1.3 | 1 |  |  |  | Especificacion dimensional; proveedor por confirmar
V7_HW_MG03_R_WASHER | da6fd69570a8d83ff8009257db4a3d4826eafbf0bed0122e07051dfcf09e958c | WASHER | OD4 ID1.8 h0.4 | 1 |  |  |  | Especificacion dimensional; proveedor por confirmar
V7_HW_MG04_F_M1p6x6 | 94f3e48594065b9cba32497f9cce5189a355fb45e30fe29e4fa287eb2c5cf41b | SCREW | M1.6x6 | 1 | headOD<=3.2 h<=1.6 |  |  | Especificacion dimensional; proveedor por confirmar
V7_HW_MG04_F_NUT | a672e31f7913f5ac58081f33b4b8c65d7074b0adad70f2ebf79d107b44d08524 | NUT | M1.6 AF3.2 h1.3 | 1 |  |  |  | Especificacion dimensional; proveedor por confirmar
V7_HW_MG04_F_WASHER | 77d10791533e5c98eda8280a05366ce6ba988ee96029fa076f638c287e501f44 | WASHER | OD4 ID1.8 h0.4 | 1 |  |  |  | Especificacion dimensional; proveedor por confirmar
V7_HW_MG04_R_M1p6x6 | f3040a3c9d6ec9622e1dd08b45ee1627bc3553464235d1f2b4ecf6e8002162e9 | SCREW | M1.6x6 | 1 | headOD<=3.2 h<=1.6 |  |  | Especificacion dimensional; proveedor por confirmar
V7_HW_MG04_R_NUT | dde14a0b5e5d67c26db1cdc8264c9fcef8b2ad0f3436dc854fb8f3ef921d5132 | NUT | M1.6 AF3.2 h1.3 | 1 |  |  |  | Especificacion dimensional; proveedor por confirmar
V7_HW_MG04_R_WASHER | 066495533b712a8c1d78498c71d6881e3f8a49a2d9a0e1db71329cac880073ce | WASHER | OD4 ID1.8 h0.4 | 1 |  |  |  | Especificacion dimensional; proveedor por confirmar
V7_HW_MG05_F_M1p6x6 | 6aa188ea562e8d13e5825d66f7de27209defd7292d7294e2ea52f3f0da27b828 | SCREW | M1.6x6 | 1 | headOD<=3.2 h<=1.6 |  |  | Especificacion dimensional; proveedor por confirmar
V7_HW_MG05_F_NUT | 081b13ec9e2b40793c8d6c21a23bdfddc25dd8750d49c36d2a09df3c6b20008c | NUT | M1.6 AF3.2 h1.3 | 1 |  |  |  | Especificacion dimensional; proveedor por confirmar
V7_HW_MG05_F_WASHER | dd5a70923c5179e0b62c3d1b1f70e6136219d76c11a2ac71b6f5c916ac6efc41 | WASHER | OD4 ID1.8 h0.4 | 1 |  |  |  | Especificacion dimensional; proveedor por confirmar
V7_HW_MG05_R_M1p6x6 | a6980e3bcf0e0999e9d1326a39865b86c6918dcaa7b219224accf9371f1028f4 | SCREW | M1.6x6 | 1 | headOD<=3.2 h<=1.6 |  |  | Especificacion dimensional; proveedor por confirmar
V7_HW_MG05_R_NUT | d7e6644cec63535599165a2999cd9f9c4cacd7dc112c19ff1779f4d7efac71bc | NUT | M1.6 AF3.2 h1.3 | 1 |  |  |  | Especificacion dimensional; proveedor por confirmar
V7_HW_MG05_R_WASHER | c4d6c6ed1236ccee9d7149914a84f808b3e876dce25d972e34fd774a99400766 | WASHER | OD4 ID1.8 h0.4 | 1 |  |  |  | Especificacion dimensional; proveedor por confirmar
V7_HW_MG06_F_M1p6x6 | da36354f27b1cbef0f0a5d83ab3af10357f6770d4fe346f070ffc2471a0c42a0 | SCREW | M1.6x6 | 1 | headOD<=3.2 h<=1.6 |  |  | Especificacion dimensional; proveedor por confirmar
V7_HW_MG06_F_NUT | 266bc806ac057022a82c7babcd2371361209c91062602097480c8b5358bd8c30 | NUT | M1.6 AF3.2 h1.3 | 1 |  |  |  | Especificacion dimensional; proveedor por confirmar
V7_HW_MG06_F_WASHER | eb593acd1ab93c31944bf8131270ce223af4fedec2ed79cc65298e6ff1e09fc4 | WASHER | OD4 ID1.8 h0.4 | 1 |  |  |  | Especificacion dimensional; proveedor por confirmar
V7_HW_MG06_R_M1p6x6 | 6500eaa69c119dabc4ba42d082cc1af052d977ee0878dad61d759438a6a04774 | SCREW | M1.6x6 | 1 | headOD<=3.2 h<=1.6 |  |  | Especificacion dimensional; proveedor por confirmar
V7_HW_MG06_R_NUT | e92de95d826f4fbf58ecf052d5b9dd8c7a82d7abe22c258d35511e708f60048f | NUT | M1.6 AF3.2 h1.3 | 1 |  |  |  | Especificacion dimensional; proveedor por confirmar
V7_HW_MG06_R_WASHER | c963c0a91c90c8b50aaa1cc527c521a85a33e6dbd8d3c2464d90bd040ba184d9 | WASHER | OD4 ID1.8 h0.4 | 1 |  |  |  | Especificacion dimensional; proveedor por confirmar
V7_HW_MG07_F_M1p6x6 | 5e2145dd01530c39dba2b04808e762d1e4345ad487cc2222cd28c924c7cbcdf0 | SCREW | M1.6x6 | 1 | headOD<=3.2 h<=1.6 |  |  | Especificacion dimensional; proveedor por confirmar
V7_HW_MG07_F_NUT | eeb0133db92ce967f7e09a33e36f49a5b561c7aa8da3a68fb6a00a71d55f6fca | NUT | M1.6 AF3.2 h1.3 | 1 |  |  |  | Especificacion dimensional; proveedor por confirmar
V7_HW_MG07_F_WASHER | 8755b8880bf09455262b73e8e84d69a4c0ada97968d2c78787787ce1e1f8758a | WASHER | OD4 ID1.8 h0.4 | 1 |  |  |  | Especificacion dimensional; proveedor por confirmar
V7_HW_MG07_R_M1p6x6 | 617d5dae4cdc17d8595d8396ff218b20985b5e0f0896c938a3d6de107617ed97 | SCREW | M1.6x6 | 1 | headOD<=3.2 h<=1.6 |  |  | Especificacion dimensional; proveedor por confirmar
V7_HW_MG07_R_NUT | bdc0b4466da2b7876756491967811c0fc80acbb456c3117a2fb5e422213ba755 | NUT | M1.6 AF3.2 h1.3 | 1 |  |  |  | Especificacion dimensional; proveedor por confirmar
V7_HW_MG07_R_WASHER | 61cb0f50c229fda5ffcff0074dc3dbd3ebc2ac18b99c22e51e0046383b46f212 | WASHER | OD4 ID1.8 h0.4 | 1 |  |  |  | Especificacion dimensional; proveedor por confirmar
V7_HW_MG08_F_M1p6x6 | e9b67a0282dd06598f39eaecd1db5c2568abb76e696abd82477b4818eddc42b2 | SCREW | M1.6x6 | 1 | headOD<=3.2 h<=1.6 |  |  | Especificacion dimensional; proveedor por confirmar
V7_HW_MG08_F_NUT | 02cb70411b7d5d74a66ea31559a4d5fa29bebacffab05c40ba97cf46f2dcf723 | NUT | M1.6 AF3.2 h1.3 | 1 |  |  |  | Especificacion dimensional; proveedor por confirmar
V7_HW_MG08_F_WASHER | c53033b73ce50c615da24e782732f0b67c207d3810746bdb1d9988b0f06dfa58 | WASHER | OD4 ID1.8 h0.4 | 1 |  |  |  | Especificacion dimensional; proveedor por confirmar
V7_HW_MG08_R_M1p6x6 | dc9fa584638f2e0d13b800efc0021f8f49b9575cb174574d03c5484f3cf8a041 | SCREW | M1.6x6 | 1 | headOD<=3.2 h<=1.6 |  |  | Especificacion dimensional; proveedor por confirmar
V7_HW_MG08_R_NUT | 7d03e26441dea3331c19049ccc5be4dc43bd73ad49d805846659d23eef972d57 | NUT | M1.6 AF3.2 h1.3 | 1 |  |  |  | Especificacion dimensional; proveedor por confirmar
V7_HW_MG08_R_WASHER | 764d6bbf62fd7f32776e563e111c5d2209dac281a385b7849bacbf4afbb9a6b9 | WASHER | OD4 ID1.8 h0.4 | 1 |  |  |  | Especificacion dimensional; proveedor por confirmar
V7_HW_MG09_F_M1p6x6 | cc7aa79109de4519183e7107248e0b00274c419698e3cff9e22c43a19c2b357f | SCREW | M1.6x6 | 1 | headOD<=3.2 h<=1.6 |  |  | Especificacion dimensional; proveedor por confirmar
V7_HW_MG09_F_NUT | 589b79870df3636b6a8f84584ce145394bdb0f5d9ecdc09a1373eeef3a1c218a | NUT | M1.6 AF3.2 h1.3 | 1 |  |  |  | Especificacion dimensional; proveedor por confirmar
V7_HW_MG09_F_WASHER | b6569c59f1928c81a2abe4ac86b3f05aa0235ea50dab25db438a3867ab20ee32 | WASHER | OD4 ID1.8 h0.4 | 1 |  |  |  | Especificacion dimensional; proveedor por confirmar
V7_HW_MG09_R_M1p6x6 | 9ab438e99c4382e552eab8212fe609ee390cb271c9cf1440a2cec50df6aadbb6 | SCREW | M1.6x6 | 1 | headOD<=3.2 h<=1.6 |  |  | Especificacion dimensional; proveedor por confirmar
V7_HW_MG09_R_NUT | b1d5573cde8c05a7cd0e6a067c8b4ebb051a59754fbf69f2442267ac7ac7f623 | NUT | M1.6 AF3.2 h1.3 | 1 |  |  |  | Especificacion dimensional; proveedor por confirmar
V7_HW_MG09_R_WASHER | fa16ebf21f7a25ecdab291803ca57516825102385acf5eec5fdf0a05768915f6 | WASHER | OD4 ID1.8 h0.4 | 1 |  |  |  | Especificacion dimensional; proveedor por confirmar
V7_HW_MG10_F_M1p6x6 | 6c3b020bd4c378657b4d9f35a4c7590176237e2d42ac5448bfed2abb9b2adfaa | SCREW | M1.6x6 | 1 | headOD<=3.2 h<=1.6 |  |  | Especificacion dimensional; proveedor por confirmar
V7_HW_MG10_F_NUT | 47226c9d5dc4aa1e96363143f1729e0ae38a562673ad65b976d012d69c00f340 | NUT | M1.6 AF3.2 h1.3 | 1 |  |  |  | Especificacion dimensional; proveedor por confirmar
V7_HW_MG10_F_WASHER | ec32f8404a2e69544402f037ef5ea1673b8953b83c7010f46225d74c62c72dbf | WASHER | OD4 ID1.8 h0.4 | 1 |  |  |  | Especificacion dimensional; proveedor por confirmar
V7_HW_MG10_R_M1p6x6 | b162a8247bbb739dbe6af296dd905348c23ca46304fffc88fdb66ae2de316dff | SCREW | M1.6x6 | 1 | headOD<=3.2 h<=1.6 |  |  | Especificacion dimensional; proveedor por confirmar
V7_HW_MG10_R_NUT | 65b43e5415e8765ffcc60dc7aad2851c97bb602c960bd06a6bad4f28fbadd1ef | NUT | M1.6 AF3.2 h1.3 | 1 |  |  |  | Especificacion dimensional; proveedor por confirmar
V7_HW_MG10_R_WASHER | d6f27971b426ce984b673ecae6c2087f1f519e7dbb9a74d5b7ca76e640387f4b | WASHER | OD4 ID1.8 h0.4 | 1 |  |  |  | Especificacion dimensional; proveedor por confirmar
V7_HW_MG11_F_M1p6x6 | a1463d5300156d0d1c2acf0d178f68a5f8e4f2dc604f63ae565cced35ecf9999 | SCREW | M1.6x6 | 1 | headOD<=3.2 h<=1.6 |  |  | Especificacion dimensional; proveedor por confirmar
V7_HW_MG11_F_NUT | eddead2efe09cdbb5280b9399c76c06265f41e5a24e5013c8caf480a68d9e28b | NUT | M1.6 AF3.2 h1.3 | 1 |  |  |  | Especificacion dimensional; proveedor por confirmar
V7_HW_MG11_F_WASHER | f9b40771aaa92643f2ca8f487809c9b2b9661916ae6bb65f7eb309b24dee750c | WASHER | OD4 ID1.8 h0.4 | 1 |  |  |  | Especificacion dimensional; proveedor por confirmar
V7_HW_MG11_R_M1p6x6 | 9aeb567963b7d2c17588e0812e4f1b035453292a3df0b5a95cbf1cceade4908a | SCREW | M1.6x6 | 1 | headOD<=3.2 h<=1.6 |  |  | Especificacion dimensional; proveedor por confirmar
V7_HW_MG11_R_NUT | 9644e2423a8399a52a52b66175a99f5c643c8ca0844eada0b4d9c2579fe940ee | NUT | M1.6 AF3.2 h1.3 | 1 |  |  |  | Especificacion dimensional; proveedor por confirmar
V7_HW_MG11_R_WASHER | 509412d06816fb204671a4e194eb861c825ea496395084a4d07cae72ff9bc8c9 | WASHER | OD4 ID1.8 h0.4 | 1 |  |  |  | Especificacion dimensional; proveedor por confirmar
V7_HW_MG12_F_M1p6x6 | a1dd0a60571088ed90f5d0578ea5fbbe1171d0459e1c473a95087bccd8adae88 | SCREW | M1.6x6 | 1 | headOD<=3.2 h<=1.6 |  |  | Especificacion dimensional; proveedor por confirmar
V7_HW_MG12_F_NUT | e30faa2c300edcb779599e7e0d6dee2e4835b8db12381e70be01e0bc24f98884 | NUT | M1.6 AF3.2 h1.3 | 1 |  |  |  | Especificacion dimensional; proveedor por confirmar
V7_HW_MG12_F_WASHER | 42f9901f4efb7b60668f2edc6b0200921cbb9853fa90bf0d2a1872c9fd9afc4f | WASHER | OD4 ID1.8 h0.4 | 1 |  |  |  | Especificacion dimensional; proveedor por confirmar
V7_HW_MG12_R_M1p6x6 | 8f279bfeadfe851e0ddb4a0949e3f5c5ccc6c4e6bf102b12aa2d0a9eeba8b810 | SCREW | M1.6x6 | 1 | headOD<=3.2 h<=1.6 |  |  | Especificacion dimensional; proveedor por confirmar
V7_HW_MG12_R_NUT | 060b2739443916d0da9c10445c3433c5469a3fe2b0ecd1100e5250df231d16ec | NUT | M1.6 AF3.2 h1.3 | 1 |  |  |  | Especificacion dimensional; proveedor por confirmar
V7_HW_MG12_R_WASHER | 0ae384f544624b6b98c1d5528d0f52e873270a45a0db42dab139a51ec124f0b6 | WASHER | OD4 ID1.8 h0.4 | 1 |  |  |  | Especificacion dimensional; proveedor por confirmar
V7_HW_MG13_F_M1p6x6 | abe6ac642b26f3499df10025b4eb6fe23b62763ab9f842d98e7e31ef4c4caac2 | SCREW | M1.6x6 | 1 | headOD<=3.2 h<=1.6 |  |  | Especificacion dimensional; proveedor por confirmar
V7_HW_MG13_F_NUT | b0b08f9c643a9062a6a80d08bec9600c035c9fcc38f1cf27f070fed25b3e5ee8 | NUT | M1.6 AF3.2 h1.3 | 1 |  |  |  | Especificacion dimensional; proveedor por confirmar
V7_HW_MG13_F_WASHER | 2a7f316efa7c2f327d5d59695969f5c312766c66dbd1565b778dc905ed91ba16 | WASHER | OD4 ID1.8 h0.4 | 1 |  |  |  | Especificacion dimensional; proveedor por confirmar
V7_HW_MG13_R_M1p6x6 | 475e94134f16cf07aacf05569876c1a1af0ef00d294498fd25aee3887b8d3bb6 | SCREW | M1.6x6 | 1 | headOD<=3.2 h<=1.6 |  |  | Especificacion dimensional; proveedor por confirmar
V7_HW_MG13_R_NUT | bcab6784201c4bc0884e12203fd8b938cae7e6fa5ff37a59be0da394bddb93c3 | NUT | M1.6 AF3.2 h1.3 | 1 |  |  |  | Especificacion dimensional; proveedor por confirmar
V7_HW_MG13_R_WASHER | 370bc872ee285943a32cf28992e2163e07ebd4f2c18bc76eb5a01d222adf60a8 | WASHER | OD4 ID1.8 h0.4 | 1 |  |  |  | Especificacion dimensional; proveedor por confirmar
V7_HW_MG14_F_M1p6x6 | 8da7c3f6d222af27f9079cc8721c5a2341f0305ac1763d8c3ae47d195944d7ac | SCREW | M1.6x6 | 1 | headOD<=3.2 h<=1.6 |  |  | Especificacion dimensional; proveedor por confirmar
V7_HW_MG14_F_NUT | e54ab2d9b660351ef796f807347034a7f190d6098671889784292e25828a806e | NUT | M1.6 AF3.2 h1.3 | 1 |  |  |  | Especificacion dimensional; proveedor por confirmar
V7_HW_MG14_F_WASHER | f892197bace77ae5051fa8e5628cf1bb8807ff88a4036ab5dc361eae5ee99bf5 | WASHER | OD4 ID1.8 h0.4 | 1 |  |  |  | Especificacion dimensional; proveedor por confirmar
V7_HW_MG14_R_M1p6x6 | 59201c0eb4eaa90a75e473cd497617b42723fe1f223ba0a400cd2ff801644c13 | SCREW | M1.6x6 | 1 | headOD<=3.2 h<=1.6 |  |  | Especificacion dimensional; proveedor por confirmar
V7_HW_MG14_R_NUT | 09fe4c90293a12a6a63964ab3c0a164a8142562fb505a3d773ca5ef492b67048 | NUT | M1.6 AF3.2 h1.3 | 1 |  |  |  | Especificacion dimensional; proveedor por confirmar
V7_HW_MG14_R_WASHER | 5aa4d9bb975401b729b928b97ed1c2fc613729365832278958a01662583328bb | WASHER | OD4 ID1.8 h0.4 | 1 |  |  |  | Especificacion dimensional; proveedor por confirmar
V7_HW_NECK_623ZZ | d35f03da197667bad171d6b53ec8735f839d35e81c92d163317892587265b06b | BEARING | 623ZZ 3x10x4 | 1 |  |  |  | Especificacion dimensional; proveedor por confirmar
V7_HW_NECK_AXLE_M2x8 | f96a81eb860090da094fceb0fed6ea4d4ba29f37dac56e4b1998974fbe809efa | SCREW | M2x8 | 1 | headOD<=4 h<=2 |  |  | Especificacion dimensional; proveedor por confirmar
V7_HW_NECK_AXLE_NUT | 1fb5253d14ff158d11d62c738adb99ec985f5291b2d0eadeb7fdf44290feecf7 | NUT | M2 AF4 h1.6 | 1 |  |  |  | Especificacion dimensional; proveedor por confirmar
V7_HW_NECK_AXLE_WASHER | 3a5c3e248f673802e06157bf6322fd9110d7d2d6bbf2ba5a93ef6483127bd9d2 | WASHER | OD4.2 ID2.2 h0.4 | 1 |  |  |  | Especificacion dimensional; proveedor por confirmar
V7_HW_NECK_BEARING_0_M2x8 | 09a9c9fc855b0e4038978fc0c92b253111f569a4a0f2424da7cbbda9b529cac5 | SCREW | M2x8 | 1 | headOD<=4 h<=2 |  |  | Especificacion dimensional; proveedor por confirmar
V7_HW_NECK_BEARING_0_NUT | 3a1450cd480553a82d0f907b5a4da07bd075c23e16d84a788b57572a671ad194 | NUT | M2 AF4 h1.6 | 1 |  |  |  | Especificacion dimensional; proveedor por confirmar
V7_HW_NECK_BEARING_0_WASHER | 0ee62a6e55fdd63e1314e73834b950a2a3060e0bf0f7e0647c4d6be4a312b30d | WASHER | OD4.2 ID2.2 h0.3 | 1 |  |  |  | Especificacion dimensional; proveedor por confirmar
V7_HW_NECK_BEARING_1_M2x8 | 180e1b067f39d0fb67388cae9801f46d672ca9086ed814538dcca282ed1dffe6 | SCREW | M2x8 NBK SSH-M2-8 ultra-low profile | 1 | NBK SSH-M2-8 ultra-low profile machine screw; {"length_under_head_mm": 8, "head_diameter_mm": 4, "head_height_mm": 1.1} |  | https://www.nbk1560.com/images/en-US/product/lowsmallheadscrew/SSH/SSH_1.pdf | SKU dimensional citado; existencias no verificadas
V7_HW_NECK_BEARING_1_NUT | 6ae531790d0a3e29c98236ada3d84e5d6e12965d7be28734077e7507b989516e | NUT | M2 AF4 h1.6 | 1 |  |  |  | Especificacion dimensional; proveedor por confirmar
V7_HW_NECK_BEARING_1_WASHER | 0eaf11d22eb354de46e5448863fafd546511c2a66bf887e285439b831a100a61 | WASHER | OD4.2 ID2.2 h0.3 | 1 |  |  |  | Especificacion dimensional; proveedor por confirmar
V7_HW_NECK_SLEEVE | 6ec514812d136e81d96190e3e93dfa0883613acba721c5597aa918c301ad3511 | SLEEVE | OD2.98 ID2.1 L4 metal | 1 | Precisionmetalbushing;provider/preparationconfirm |  |  | Especificacion dimensional; proveedor por confirmar
V7_HW_OEM_HORN_TRIMMED_00 | b40b6094acbd7f0e76de43226006d585954c949b6587b4a5e206d2d736835ff1 | OEM_HORN | OEM MG90S two-arm horn span13.8 +/-0.2 | 1 | Factoryspline/hub retained; nominalwidth5/thickness2.4/hubOD10.4; verifylot |  |  | Especificacion dimensional; proveedor por confirmar
V7_HW_OEM_HORN_TRIMMED_01 | 21c6f9ccc4f3dcfe8b2ada79ab4977c310bfa212f7f123c621622771f4a70454 | OEM_HORN | OEM MG90S two-arm horn span13.8 +/-0.2 | 1 | Factoryspline/hub retained; nominalwidth5/thickness2.4/hubOD10.4; verifylot |  |  | Especificacion dimensional; proveedor por confirmar
V7_HW_OEM_HORN_TRIMMED_02 | 526959b5b44914d5811e943b2e11b2f553157053a1aed6843542f4bf62854924 | OEM_HORN | OEM MG90S two-arm horn span14.8 max | 1 | Factoryspline/hub retained; nominalwidth5/thickness2.4/hubOD10.4; verifylot | BarraOEM: cortar simetricamente hasta longitud total maxima14.8mm; ancho5 y espesor2.4 conservados. Desbarbar sin tocar cubo/estriado. |  | Especificacion dimensional; proveedor por confirmar
V7_HW_OEM_HORN_TRIMMED_03 | d15ac713db5ee10db3a2fd767f59889b14b95feb73e9aaa9c96939483dd4e099 | OEM_HORN | OEM MG90S two-arm horn span14.8 max | 1 | Factoryspline/hub retained; nominalwidth5/thickness2.4/hubOD10.4; verifylot | BarraOEM: cortar simetricamente hasta longitud total maxima14.8mm; ancho5 y espesor2.4 conservados. Desbarbar sin tocar cubo/estriado. |  | Especificacion dimensional; proveedor por confirmar
V7_HW_OEM_HORN_TRIMMED_04 | c07113b3a3dd50b3ec6d015bbdab7826807af48e29d9640bd130395b715e7072 | OEM_HORN | OEM MG90S two-arm horn span14.8 max | 1 | Factoryspline/hub retained; nominalwidth5/thickness2.4/hubOD10.4; verifylot | BarraOEM: cortar simetricamente hasta longitud total maxima14.8mm; ancho5 y espesor2.4 conservados. Desbarbar sin tocar cubo/estriado. |  | Especificacion dimensional; proveedor por confirmar
V7_HW_OEM_HORN_TRIMMED_05 | 31bd026fa42a05df4192ccac1e011c7384013eac95d71bc2e86c4ab25ede8713 | OEM_HORN | OEM MG90S two-arm horn span18 +/-0.2 | 1 | Factoryspline/hub retained; nominalwidth5/thickness2.4/hubOD10.4; verifylot |  |  | Especificacion dimensional; proveedor por confirmar
V7_HW_OEM_HORN_TRIMMED_06 | efe37b76927fc8d2eae21992f64f59294afb87e4ace66fdfd495c7431cd47ae3 | OEM_HORN | OEM MG90S two-arm horn span18 +/-0.2 | 1 | Factoryspline/hub retained; nominalwidth5/thickness2.4/hubOD10.4; verifylot |  |  | Especificacion dimensional; proveedor por confirmar
V7_HW_OEM_HORN_TRIMMED_07 | 90bfb618d5cd4fed08ea2d5f92d671ec270f63beec948841db80b7e1c23ef0d3 | OEM_HORN | OEM MG90S two-arm horn span18 +/-0.2 | 1 | Factoryspline/hub retained; nominalwidth5/thickness2.4/hubOD10.4; verifylot |  |  | Especificacion dimensional; proveedor por confirmar
V7_HW_OEM_HORN_TRIMMED_08 | beb469128c25a5ca6b464566d62952f517d6912c5d213c148cafa50eca6400f8 | OEM_HORN | OEM MG90S two-arm horn span13.8 +0/-0.2 | 1 | Factoryspline/hub retained; nominalwidth5/thickness2.4/hubOD10.4; verifylot | Trim symmetrically toTOTAL13.8mm(+0/-0.2); retain OEM width5/thickness2.4 andfactoryhub/spline |  | Especificacion dimensional; proveedor por confirmar
V7_HW_OEM_HORN_TRIMMED_10 | 9c5de2509d31b333cd05a0df07373265407f05439f850ac73ccf793e17148602 | OEM_HORN | OEM MG90S two-arm horn span14.8 max | 1 | Factoryspline/hub retained; nominalwidth5/thickness2.4/hubOD10.4; verifylot | BarraOEM: cortar simetricamente hasta longitud total maxima14.8mm; ancho5 y espesor2.4 conservados. Desbarbar sin tocar cubo/estriado. |  | Especificacion dimensional; proveedor por confirmar
V7_HW_OEM_HORN_TRIMMED_11 | fba287c91befb77e568066e28db42fb56f0e791d1d01fe3bd7dc6f53a3cf3a59 | OEM_HORN | OEM MG90S two-arm horn span14.8 max | 1 | Factoryspline/hub retained; nominalwidth5/thickness2.4/hubOD10.4; verifylot | BarraOEM: cortar simetricamente hasta longitud total maxima14.8mm; ancho5 y espesor2.4 conservados. Desbarbar sin tocar cubo/estriado. |  | Especificacion dimensional; proveedor por confirmar
V7_HW_OEM_HORN_TRIMMED_12 | 80a7572b73041231184342cce7acc20a86dc72fc119d616c7b8620527dac54ff | OEM_HORN | OEM MG90S two-arm horn span14.8 max | 1 | Factoryspline/hub retained; nominalwidth5/thickness2.4/hubOD10.4; verifylot | BarraOEM: cortar simetricamente hasta longitud total maxima14.8mm; ancho5 y espesor2.4 conservados. Desbarbar sin tocar cubo/estriado. |  | Especificacion dimensional; proveedor por confirmar
V7_HW_OEM_HORN_TRIMMED_13 | 836f2163d70118e24e49011cb40a8e16971fc55a8f19c6b1fb2a02126aa41735 | OEM_HORN | OEM MG90S two-arm horn span14.8 max | 1 | Factoryspline/hub retained; nominalwidth5/thickness2.4/hubOD10.4; verifylot | BarraOEM: cortar simetricamente hasta longitud total maxima14.8mm; ancho5 y espesor2.4 conservados. Desbarbar sin tocar cubo/estriado. |  | Especificacion dimensional; proveedor por confirmar
V7_HW_OEM_HORN_TRIMMED_14 | 170ea72217df2c72d5f30b3e1277fa08223137a16561cda328a96af92e9802db | OEM_HORN | OEM MG90S two-arm horn span18 +/-0.2 | 1 | Factoryspline/hub retained; nominalwidth5/thickness2.4/hubOD10.4; verifylot |  |  | Especificacion dimensional; proveedor por confirmar
V7_HW_PASSIVE_ANKLE05_HARD_SHIM | b6949e2d87bd2aa875f192ce3e45af2a7b1f5b4113d26eb93666c0de96147ce6 | HARD_SHIM | OD5 ID2.2 h0.35 | 1 |  |  |  | Especificacion dimensional; proveedor por confirmar
V7_HW_PASSIVE_ANKLE05_M2x6 | 0217f1c06126d4524692c075839abc34b1bcfc1d66b94c1d764cbe716d57bdb1 | SCREW | M2x6 | 1 | headOD<=4.8 h<=2 |  |  | Especificacion dimensional; proveedor por confirmar
V7_HW_PASSIVE_ANKLE05_NUT | 45152c5ddb5f1ef219a5e747a0d280e54f2d3bb60f8a10423a44398e4ccea6b7 | NUT | M2 AF4 h1.6 | 1 |  |  |  | Especificacion dimensional; proveedor por confirmar
V7_HW_PASSIVE_ANKLE05_WASHER | 23504855c515a6800e956f01b181173f047adb806ae67df9227c68fdf9182072 | WASHER | OD5 ID2.2 h0.3 | 1 |  |  |  | Especificacion dimensional; proveedor por confirmar
V7_HW_PASSIVE_ANKLE14_HARD_SHIM | 8090def19b4d664459293897825a9296cc4beac5746a23ba464c0ee5799c80a1 | HARD_SHIM | OD5 ID2.2 h0.35 | 1 |  |  |  | Especificacion dimensional; proveedor por confirmar
V7_HW_PASSIVE_ANKLE14_M2x6 | 93868d7bb40f91e331c34b5ad2f5725f13f4ac02fe33095a3a04ade36c03fea2 | SCREW | M2x6 | 1 | headOD<=4.8 h<=2 |  |  | Especificacion dimensional; proveedor por confirmar
V7_HW_PASSIVE_ANKLE14_NUT | 262340a75923433b5fb176f37de127855465e42d9721e2044653e73544baaf85 | NUT | M2 AF4 h1.6 | 1 |  |  |  | Especificacion dimensional; proveedor por confirmar
V7_HW_PASSIVE_ANKLE14_WASHER | bccd726460cd48fa857c7d2f58a50c0c6ffa50b09186cd65589a93125ae95a23 | WASHER | OD5 ID2.2 h0.3 | 1 |  |  |  | Especificacion dimensional; proveedor por confirmar
V7_HW_PASSIVE_HEAD10_HARD_SHIM | 2e5d7deabfd1879c10e7a2d01b6a9f105be96d9b8372facde7495c2f9055d65f | HARD_SHIM | OD5 ID2.2 h0.2 | 1 |  |  |  | Especificacion dimensional; proveedor por confirmar
V7_HW_PASSIVE_HEAD10_M2x10 | d25a85dbe0cbb3148aa942c999374233ff3f31bf764127bce0020dede01caf4a | SCREW | M2x10 | 1 | headOD<=4.8 h<=2 |  |  | Especificacion dimensional; proveedor por confirmar
V7_HW_PASSIVE_HEAD10_NUT | 5868622f211da71b0973431d37ba3b4a1276a63b3efe46c4b56ccc00403a4137 | NUT | M2 AF4 h1.6 | 1 |  |  |  | Especificacion dimensional; proveedor por confirmar
V7_HW_PASSIVE_HEAD10_WASHER | 0b3c0699e8b10b905c0846647088278c8076c8ad41f563b6ffa3119d5e62c2c9 | WASHER | OD5 ID2.2 h0.3 | 1 |  |  |  | Especificacion dimensional; proveedor por confirmar
V7_HW_PCB_BNO_0_M2x10 | 8683cdd559cb37a507767159adfaef376e89398adeb803094ed8284d479da9ec | SCREW | M2x10 | 1 | headOD<=4.8 h<=2 |  |  | Especificacion dimensional; proveedor por confirmar
V7_HW_PCB_BNO_0_NUT | 22a831395e2698348b2c08b12f19c43681c175403a150e6b2be76caa43230685 | NUT | M2 AF4 h1.6 | 1 |  |  |  | Especificacion dimensional; proveedor por confirmar
V7_HW_PCB_BNO_0_PCB_WASHER | 10a161df6412507eb3ab340fed02b1aa2b0087a0e0b98bef2a5c1422bebee1bc | WASHER | OD5 ID2.2 h0.3 | 1 |  |  |  | Especificacion dimensional; proveedor por confirmar
V7_HW_PCB_BNO_0_TRAY_WASHER | b033de1e53033f34146226bcb1ceead339fb8dbbb4ac794184c682dfdbb5c8fa | WASHER | OD5 ID2.2 h0.3 | 1 |  |  |  | Especificacion dimensional; proveedor por confirmar
V7_HW_PCB_BNO_1_M2x10 | 9dd3226b2e69d754bba3b3b50fbe581c4044ea20c8886831ed657a2858485aad | SCREW | M2x10 | 1 | headOD<=4.8 h<=2 |  |  | Especificacion dimensional; proveedor por confirmar
V7_HW_PCB_BNO_1_NUT | 8048a1eefd08c031627dcc90b60b0fa33f400ffafb1915b80cc5ba8a8ae8399f | NUT | M2 AF4 h1.6 | 1 |  |  |  | Especificacion dimensional; proveedor por confirmar
V7_HW_PCB_BNO_1_PCB_WASHER | 44f4392f547e0480c101a22a20ceef211f418f7ce08bb5b32171d22d82ccd015 | WASHER | OD5 ID2.2 h0.3 | 1 |  |  |  | Especificacion dimensional; proveedor por confirmar
V7_HW_PCB_BNO_1_TRAY_WASHER | fb5ecf83dbcce997d72dc5e73a550d2e09e8dfefc2ca4e956c56d7fbb39841e4 | WASHER | OD5 ID2.2 h0.3 | 1 |  |  |  | Especificacion dimensional; proveedor por confirmar
V7_HW_PCB_BNO_2_M2x10 | 5e5918de3ab3515fbdda0969204d4ea380ed2a88c4ed810f4ee74c7e10f6d2a3 | SCREW | M2x10 | 1 | headOD<=4.8 h<=2 |  |  | Especificacion dimensional; proveedor por confirmar
V7_HW_PCB_BNO_2_NUT | f2792f7e3c7bdcdecc2d40ebd4dde7160c800d8749ac16ed3653905ddc15aab7 | NUT | M2 AF4 h1.6 | 1 |  |  |  | Especificacion dimensional; proveedor por confirmar
V7_HW_PCB_BNO_2_PCB_WASHER | 3f2c4583658c9f750d2be058d6fa8c240f0487f57a58e1bb7c2b5c20a56b98f3 | WASHER | OD5 ID2.2 h0.3 | 1 |  |  |  | Especificacion dimensional; proveedor por confirmar
V7_HW_PCB_BNO_2_TRAY_WASHER | fa2fcef731099dc77532ad72a269ede5fc409b6d9fe5a7a662ab377d8490a98a | WASHER | OD5 ID2.2 h0.3 | 1 |  |  |  | Especificacion dimensional; proveedor por confirmar
V7_HW_PCB_BNO_3_M2x10 | f44bbf1de4bf184e64b6534e3a0281fd494ef93da523d51a9bead279f10cb889 | SCREW | M2x10 | 1 | headOD<=4.8 h<=2 |  |  | Especificacion dimensional; proveedor por confirmar
V7_HW_PCB_BNO_3_NUT | a6d86e037a8b03b66df07c75df732d271090690860c97a2d36ba1fda89c2f703 | NUT | M2 AF4 h1.6 | 1 |  |  |  | Especificacion dimensional; proveedor por confirmar
V7_HW_PCB_BNO_3_PCB_WASHER | 1ceb7f70a15660485115f9537f0bc36d5d30138bea7c4174302da0e44cc907d6 | WASHER | OD5 ID2.2 h0.3 | 1 |  |  |  | Especificacion dimensional; proveedor por confirmar
V7_HW_PCB_BNO_3_TRAY_WASHER | 0dd08d93527d79a8c0b095eefa3e9e48b0eeeacf8464c4bbd1cb9635295a4aed | WASHER | OD5 ID2.2 h0.3 | 1 |  |  |  | Especificacion dimensional; proveedor por confirmar
V7_HW_PCB_PI_0_M2x10 | 7b8e74a50f5372adcd78c58b926a8a085c3fed1e4a70aeb533bbeab92931802a | SCREW | M2x10 | 1 | headOD<=4.8 h<=2 |  |  | Especificacion dimensional; proveedor por confirmar
V7_HW_PCB_PI_0_NUT | bf9eb693e005b29a0a414a550469307c3987fcfd0abedba0acc49a00bf04da95 | NUT | M2 AF4 h1.6 | 1 |  |  |  | Especificacion dimensional; proveedor por confirmar
V7_HW_PCB_PI_0_PCB_WASHER | 2ca6293d8a10c44c491315c2e101eb85d7424ccd8fb159a37c2d9da44728cf21 | WASHER | OD5 ID2.2 h0.3 | 1 |  |  |  | Especificacion dimensional; proveedor por confirmar
V7_HW_PCB_PI_0_TRAY_WASHER | f54ab0331368b287bc0429c3715aaad454f7962d2db22613717adea82927ff41 | WASHER | OD5 ID2.2 h0.3 | 1 |  |  |  | Especificacion dimensional; proveedor por confirmar
V7_HW_PCB_PI_1_M2x10 | ca44b82718f16ebb6452fcfc1f3429972a02f46c5bae263aa26422c55bb6160c | SCREW | M2x10 | 1 | headOD<=4.8 h<=2 |  |  | Especificacion dimensional; proveedor por confirmar
V7_HW_PCB_PI_1_NUT | 870a4b6cfd71d54fbf1c6e0ded0681b2c10d310e17240d897d8460438a058858 | NUT | M2 AF4 h1.6 | 1 |  |  |  | Especificacion dimensional; proveedor por confirmar
V7_HW_PCB_PI_1_PCB_WASHER | db3e812d8d392a6b30ef6aa5783ced54c613206f09b851673a7b517996d08734 | WASHER | OD5 ID2.2 h0.3 | 1 |  |  |  | Especificacion dimensional; proveedor por confirmar
V7_HW_PCB_PI_1_TRAY_WASHER | d6d01787d4c7a21dba5ec7868ca6820aa91bb48643d08e3e56eb28ece20ee330 | WASHER | OD5 ID2.2 h0.3 | 1 |  |  |  | Especificacion dimensional; proveedor por confirmar
V7_HW_PCB_PI_2_M2x10 | 712e0fceda8426386f14beb02137e5a05b31042c9c2f5b751a578d0e3012c9fd | SCREW | M2x10 | 1 | headOD<=4.8 h<=2 |  |  | Especificacion dimensional; proveedor por confirmar
V7_HW_PCB_PI_2_NUT | f32bd58d788cc85b829a32bb44231beeaeab7035730deba697bedf484ac8c68f | NUT | M2 AF4 h1.6 | 1 |  |  |  | Especificacion dimensional; proveedor por confirmar
V7_HW_PCB_PI_2_PCB_WASHER | 16d6188605422d629f4f8b525abbe31d2139ae7ee332f25fca776f2748ce7563 | WASHER | OD5 ID2.2 h0.3 | 1 |  |  |  | Especificacion dimensional; proveedor por confirmar
V7_HW_PCB_PI_2_TRAY_WASHER | fda309a63febe9e2b620f00340dea29f25e64062acac623dab6b8a0c4a9a9773 | WASHER | OD5 ID2.2 h0.3 | 1 |  |  |  | Especificacion dimensional; proveedor por confirmar
V7_HW_PCB_PI_3_M2x10 | 7d467df4a2e7687946e7162b1d821e45abd7527c54a84aae80f172dd6b519257 | SCREW | M2x10 | 1 | headOD<=4.8 h<=2 |  |  | Especificacion dimensional; proveedor por confirmar
V7_HW_PCB_PI_3_NUT | a3bf1d69893b15e02bc5118da293282e6f758ef6dc31117334de49b9e5debff2 | NUT | M2 AF4 h1.6 | 1 |  |  |  | Especificacion dimensional; proveedor por confirmar
V7_HW_PCB_PI_3_PCB_WASHER | 277dd1fab801b5a5529e4b3bbe8044fcb5fd6b2de6bdb5ca4e386f7e6771d49e | WASHER | OD5 ID2.2 h0.3 | 1 |  |  |  | Especificacion dimensional; proveedor por confirmar
V7_HW_PCB_PI_3_TRAY_WASHER | 8405c278eb4efdef5e271aa34fe57bff92c9f7238c95f60c7239264ed4322040 | WASHER | OD5 ID2.2 h0.3 | 1 |  |  |  | Especificacion dimensional; proveedor por confirmar
V7_SRC_V4_MD_ankle_left__seeed_bearing__configuration_default | 9f4a06fbf858072f7c2737533198bb1452689a39a049f3ec617a104950a63f85 | BEARING | 6700 OPEN 10x15x3 (abierto;H3,NOZZH4) | 1 |  |  |  | Especificacion dimensional; proveedor por confirmar
V7_SRC_V4_MD_ankle_right__seeed_bearing__configuration_default | e24f14acdb6f4046c60e424936b747c0f43b36d3f70fb6162cc00318fab606f4 | BEARING | 6700 OPEN 10x15x3 (abierto;H3,NOZZH4) | 1 |  |  |  | Especificacion dimensional; proveedor por confirmar
V7_SRC_V4_MD_bearing_roll__seeed_bearing__configuratio_005ded7b | 0240c4e2567d985219a3d0e5458c76bfea325ad750b337c0491fe8e4d96e3a75 | BEARING | ET2216 16x22x4 | 1 |  |  |  | Especificacion dimensional; proveedor por confirmar
V7_SRC_V4_MD_hip_l_2__seeed_bearing__configuration__22x16x4 | 7b138030489e36d393675964eb0a6a662fc05a7dcf418bf136bb5e7190f61343 | BEARING | ET2216 16x22x4 | 1 |  |  |  | Especificacion dimensional; proveedor por confirmar
V7_SRC_V4_MD_hip_l__seeed_bearing__configuration__22x16x4 | 9d628e2268f5eef3e01e6dc3d2d3a49bc430f1a87872dad1e672a2dbb4121079 | BEARING | ET2216 16x22x4 | 1 |  |  |  | Especificacion dimensional; proveedor por confirmar
V7_SRC_V4_MD_neck_pitch__seeed_bearing__configuration__22x16x4 | 31379cb33191066ac7a52e73e42aa319dcfed666981510c3c940e800960be3d1 | BEARING | 6702ZZ 15x21x4 double metal shielded | 1 |  |  | https://www.smbbearings.com/products/thin-section-bearings.html | SKU dimensional citado; existencias no verificadas
V7_SRC_V4_MD_trunk_base__seeed_bearing__configuration__2100455f | 4b59581ba3390d30319e8edf0ecb75377982dbcc830fcc9b617f4c1a4f95eb55 | BEARING | ET2216 16x22x4 | 1 |  |  |  | Especificacion dimensional; proveedor por confirmar
V7_SRC_V4_MD_trunk_base__seeed_bearing__configuration__22x16x4 | 29b54e9c41a68248efbcdac5c0e53365aea460b25205b7ac490606b5d81dd0f2 | BEARING | ET2216 16x22x4 | 1 |  |  |  | Especificacion dimensional; proveedor por confirmar
V7_SRC_V4_MD_upper_leg_left__seeed_bearing__configurat_5adb0bbf | 0fa5cf9f2d66b480119ce39eef9471c669101235e0f492ee32c517608941f231 | BEARING | ET2216 16x22x4 | 1 |  |  |  | Especificacion dimensional; proveedor por confirmar
V7_SRC_V4_MD_upper_leg_right__seeed_bearing__configura_9644d2e7 | 9233d8ea890352e564bb8c8201f53463b2babd41d34e3d7d6391ad03c3aa919d | BEARING | ET2216 16x22x4 | 1 |  |  |  | Especificacion dimensional; proveedor por confirmar
V7_SRC_V4_MD_yaw2roll__seeed_bearing__configuration__22x16x4 | 53d209331f82112827837a44ada9c1d7d3e3394b179299fb7d710910acc540e9 | BEARING | ET2216 16x22x4 | 1 |  |  |  | Especificacion dimensional; proveedor por confirmar
V7_SRC_V4_MD_yaw_roll_motion__seeed_bearing__configura_0c367e2a | 8a463d6be1495f00110e5a9c3a7c8d7ad578bd3a51f81af5916284bab1be4e7a | BEARING | 6701ZZ 12x18x4 double metal shielded | 1 |  |  | https://www.smbbearings.com/products/thin-section-bearings.html | SKU dimensional citado; existencias no verificadas
V7_SRC_V4_MD_yaw_roll_motion__seeed_bearing__configura_fa19e6f9 | fb78253a5b87049f2fc7bd10e4316753e183fad7672a024b19c9cc3e0f64a3e6 | BEARING | ET2216 16x22x4 | 1 |  |  |  | Especificacion dimensional; proveedor por confirmar
V8_D24_HW_M2x8_0 | 5f0594b176640303ada51531e48bc2d90d10d151a448b895562434d2fa97bcd7 | SCREW | M2x8 | 1 | headOD<=4 h<=1.6; actualKIT five-positive-components dimensional check |  |  | Especificacion dimensional; proveedor por confirmar
V8_D24_HW_M2x8_0 | 5f0594b176640303ada51531e48bc2d90d10d151a448b895562434d2fa97bcd7 | NUT | M2 AF4 h1.6 | 1 |  |  |  | Especificacion dimensional; proveedor por confirmar
V8_D24_HW_M2x8_0 | 5f0594b176640303ada51531e48bc2d90d10d151a448b895562434d2fa97bcd7 | WASHER | OD4.3 ID2.2 h0.3 | 2 |  |  |  | Especificacion dimensional; proveedor por confirmar
V8_D24_HW_M2x8_1 | 1dfc83749587995e5a7346dff611c771d3969729714f4db72d0af83876bb335c | SCREW | M2x8 | 1 | headOD<=4 h<=1.6; actualKIT five-positive-components dimensional check |  |  | Especificacion dimensional; proveedor por confirmar
V8_D24_HW_M2x8_1 | 1dfc83749587995e5a7346dff611c771d3969729714f4db72d0af83876bb335c | NUT | M2 AF4 h1.6 | 1 |  |  |  | Especificacion dimensional; proveedor por confirmar
V8_D24_HW_M2x8_1 | 1dfc83749587995e5a7346dff611c771d3969729714f4db72d0af83876bb335c | WASHER | OD4.3 ID2.2 h0.3 | 2 |  |  |  | Especificacion dimensional; proveedor por confirmar
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
