MTNRS/microduck-v15/fabricacion/PAUSAS_OBLIGATORIAS_TUERCAS_V15.csv

id_STL | pieza | altura_Z_mm_sin_raft | pausar_despues_capa_modelo | antes_capa_modelo | insertar | tuerca
P03 | V7_MOD_UPPER_LEG_LEFT | 23.200001 | 116 | 117 | V7_HW_MG03_R_NUT | M1.6 AF3.2 h1.3
P03 | V7_MOD_UPPER_LEG_LEFT | 23.200001 | 116 | 117 | V7_HW_MG04_F_NUT | M1.6 AF3.2 h1.3
P03 | V7_MOD_UPPER_LEG_LEFT | 23.200001 | 116 | 117 | V7_HW_MG04_R_NUT | M1.6 AF3.2 h1.3
P03 | V7_MOD_UPPER_LEG_LEFT | 24.200001 | 121 | 122 | V15_HW_SERVICE_MG03_0_NUT | M2 AF4 h1.6
P03 | V7_MOD_UPPER_LEG_LEFT | 24.200001 | 121 | 122 | V15_HW_SERVICE_MG04_0_NUT | M2 AF4 h1.6
P03 | V7_MOD_UPPER_LEG_LEFT | 24.200001 | 121 | 122 | V15_HW_SERVICE_MG04_1_NUT | M2 AF4 h1.6
P04 | V7_MOD_LEG | 23.0 | 115 | 116 | V7_HW_MG05_R_NUT | M1.6 AF3.2 h1.3
P06 | V7_MOD_NECK | 23.0 | 115 | 116 | V7_HW_MG06_R_NUT | M1.6 AF3.2 h1.3
P06 | V7_MOD_NECK | 23.0 | 115 | 116 | V7_HW_MG07_R_NUT | M1.6 AF3.2 h1.3
P11 | V7_MOD_UPPER_LEG_RIGHT | 23.2 | 116 | 117 | V7_HW_MG12_R_NUT | M1.6 AF3.2 h1.3
P11 | V7_MOD_UPPER_LEG_RIGHT | 23.2 | 116 | 117 | V7_HW_MG13_R_NUT | M1.6 AF3.2 h1.3
P11 | V7_MOD_UPPER_LEG_RIGHT | 24.200001 | 121 | 122 | V15_HW_SERVICE_MG12_1_NUT | M2 AF4 h1.6
P11 | V7_MOD_UPPER_LEG_RIGHT | 24.200001 | 121 | 122 | V15_HW_SERVICE_MG13_0_NUT | M2 AF4 h1.6
P11 | V7_MOD_UPPER_LEG_RIGHT | 24.200001 | 121 | 122 | V15_HW_SERVICE_MG13_1_NUT | M2 AF4 h1.6
P12 | V7_MOD_LEG_2 | 23.0 | 115 | 116 | V7_HW_MG14_R_NUT | M1.6 AF3.2 h1.3
P14 | V7_TAPA_BRAZO_00 | 20.0 | 100 | 101 | V7_HW_MG02_F_NUT | M1.6 AF3.2 h1.3
P15 | V7_TAPA_BRAZO_01 | 20.0 | 100 | 101 | V7_HW_MG11_F_NUT | M1.6 AF3.2 h1.3
P23 | V7_TAPA_BRAZO_10 | 20.0 | 100 | 101 | V7_HW_MG08_R_NUT | M1.6 AF3.2 h1.3
P44 | 12CASE_TORSO_CONTINUO | 45.0 | 225 | 226 | V7_HW_MG00_F_NUT | M1.6 AF3.2 h1.3
P44 | 12CASE_TORSO_CONTINUO | 45.0 | 225 | 226 | V7_HW_MG00_R_NUT | M1.6 AF3.2 h1.3
P44 | 12CASE_TORSO_CONTINUO | 45.0 | 225 | 226 | V7_HW_MG01_F_NUT | M1.6 AF3.2 h1.3
P44 | 12CASE_TORSO_CONTINUO | 45.0 | 225 | 226 | V7_HW_MG01_R_NUT | M1.6 AF3.2 h1.3
P44 | 12CASE_TORSO_CONTINUO | 46.0 | 230 | 231 | V15_HW_SERVICE_MG00_0_NUT | M2 AF4 h1.6
P44 | 12CASE_TORSO_CONTINUO | 46.0 | 230 | 231 | V15_HW_SERVICE_MG00_1_NUT | M2 AF4 h1.6
P44 | 12CASE_TORSO_CONTINUO | 46.0 | 230 | 231 | V15_HW_SERVICE_MG01_0_NUT | M2 AF4 h1.6
P44 | 12CASE_TORSO_CONTINUO | 46.0 | 230 | 231 | V15_HW_SERVICE_MG01_1_NUT | M2 AF4 h1.6
