MTNRS/microduck-v15/fabricacion/ACCESORIOS_LLAVE/V15_LLAVE_57045_TAPA.stl

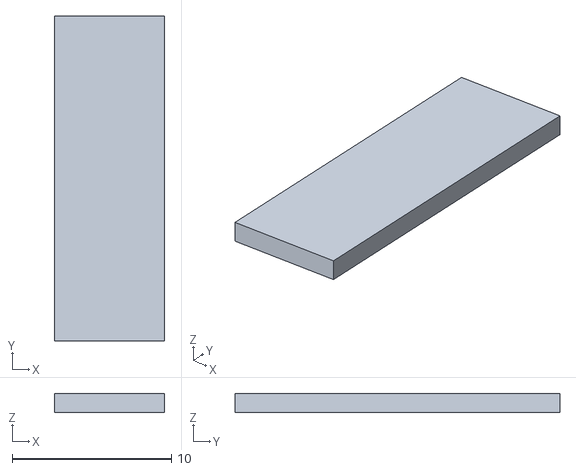
[picture p2: CAD file, 2026-11-03]
fabricacion/ACCESORIOS_LLAVE/V15_LLAVE_57045_TAPA.stl
6.92 x 20.4 x 1.20
