MTNRS/microduck-v15/fabricacion/PROBETAS_PRIMERO/02_VENTANA_MG90S_000.stl

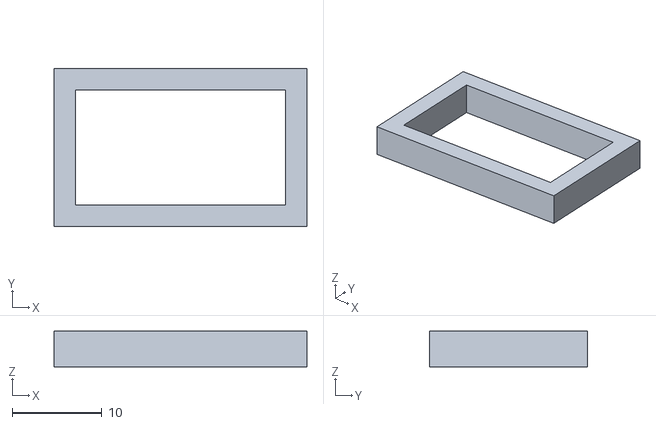
[picture p3: CAD file, 2026-11-03]
fabricacion/PROBETAS_PRIMERO/02_VENTANA_MG90S_000.stl
28.2 x 17.6 x 4.00
