MTNRS/microduck-v15/fabricacion/PROYECTOS_PRUSA_PAUSAS/P03_V7_MOD_UPPER_LEG_LEFT_PAUSAS.3mf

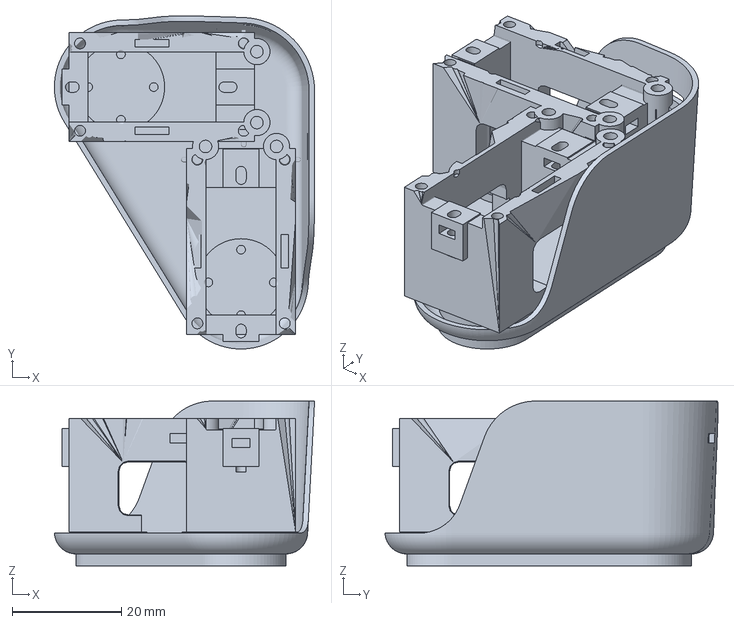
[picture p4: CAD file, 2026-11-03]
fabricacion/PROYECTOS_PRUSA_PAUSAS/P03_V7_MOD_UPPER_LEG_LEFT_PAUSAS.3mf
47.7 x 61.0 x 30.2 mm
