MTNRS/microduck-v15/fabricacion/STL_POR_COLORES/AMARILLO_PETG/40_V7_EYE_RING_CLEARANCED.stl

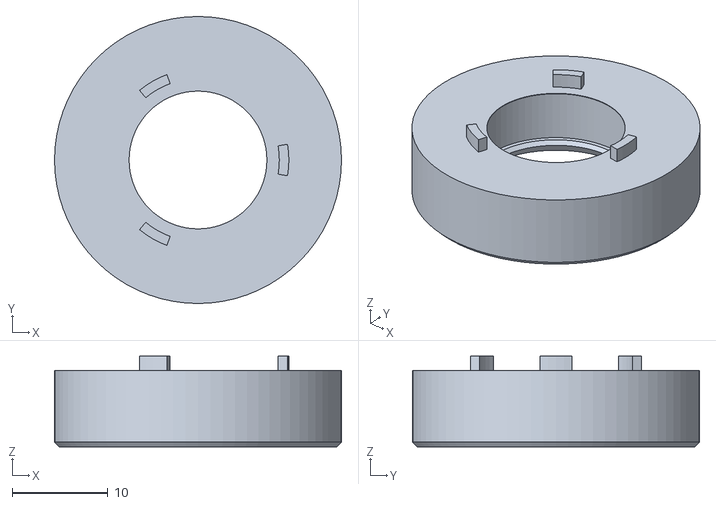
[picture p5: CAD file, 2026-11-03]
fabricacion/STL_POR_COLORES/AMARILLO_PETG/40_V7_EYE_RING_CLEARANCED.stl
30.0 x 30.0 x 9.50
