MTNRS/microduck-v15/fabricacion/STL_POR_COLORES/AZUL_CIELO_PETG/28_V7_TAPA_RODAMIENTO_CUELLO.stl

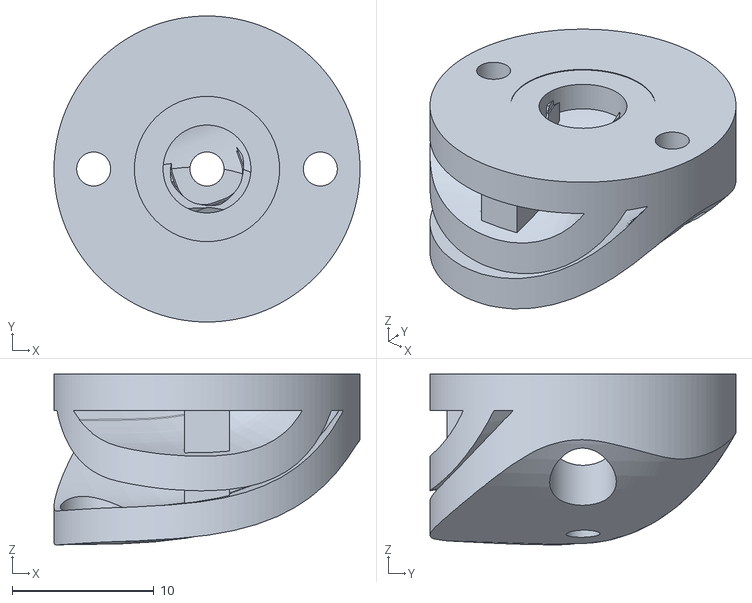
[picture p6: CAD file, 2026-11-03]
fabricacion/STL_POR_COLORES/AZUL_CIELO_PETG/28_V7_TAPA_RODAMIENTO_CUELLO.stl
21.6 x 21.6 x 12.0
