MTNRS/microduck-v15/fabricacion/STL_POR_COLORES/GRIS_PETG/35_V7_HEAD_FACE_ANCLADO.stl

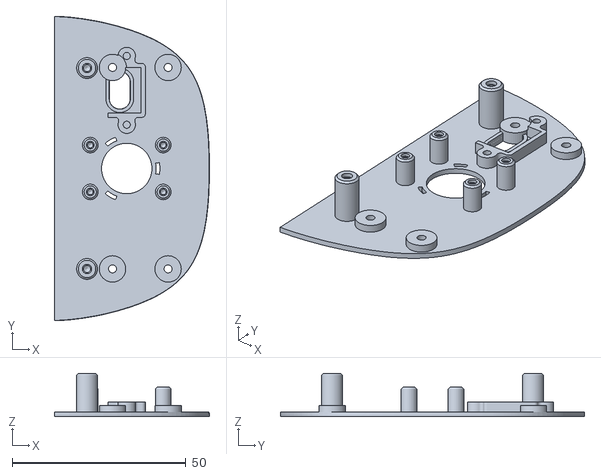
[picture p7: CAD file, 2026-11-03]
fabricacion/STL_POR_COLORES/GRIS_PETG/35_V7_HEAD_FACE_ANCLADO.stl
44.6 x 87.7 x 12.5
