MTNRS/microduck-v15/fabricacion/STL_POR_COLORES/NARANJA_PETG/34_V7_HEAD_LOWER_ANCLADO.stl

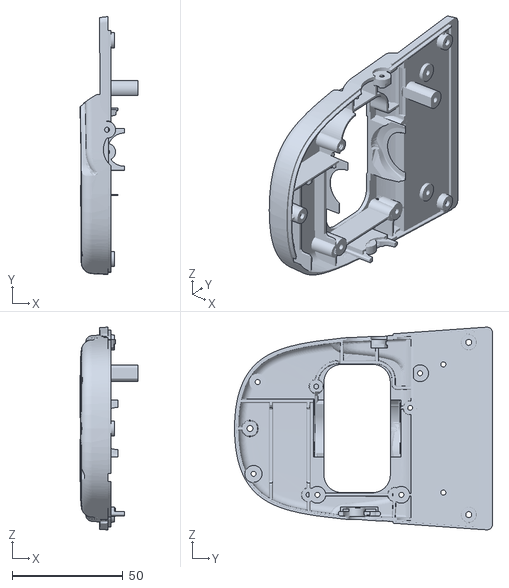
[picture p8: CAD file, 2026-11-03]
fabricacion/STL_POR_COLORES/NARANJA_PETG/34_V7_HEAD_LOWER_ANCLADO.stl
26.3 x 116.7 x 91.8
