MTNRS/microduck-v15/fabricacion/STL_POR_COLORES/NARANJA_TPU95A/39_V7_HEAD_LIP_UPPER_RELIEVED.stl

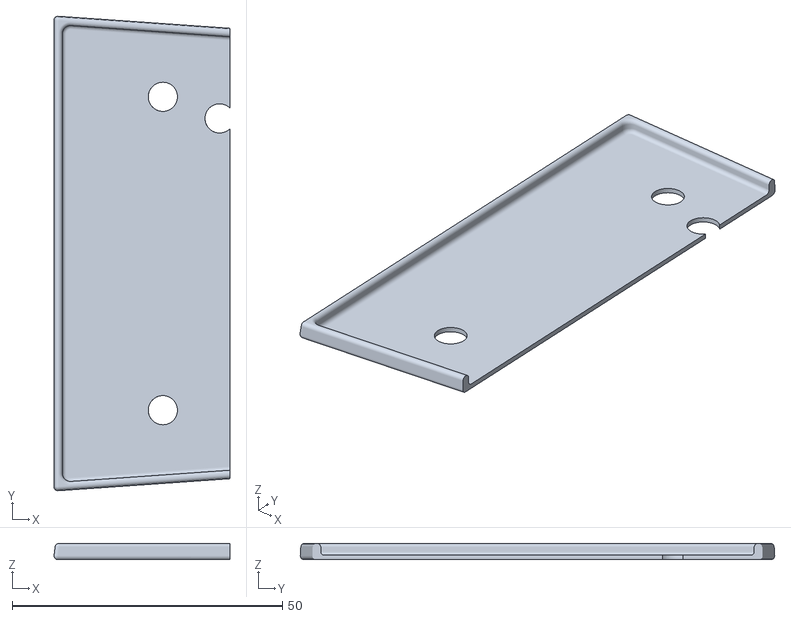
[picture p9: CAD file, 2026-11-03]
fabricacion/STL_POR_COLORES/NARANJA_TPU95A/39_V7_HEAD_LIP_UPPER_RELIEVED.stl
32.6 x 87.8 x 3.00
