MTNRS/microduck-v15/fabricacion/STL_POR_COLORES/NEGRO_PETG/78_V15_ET_RADIAL_CLAMP_13F.stl

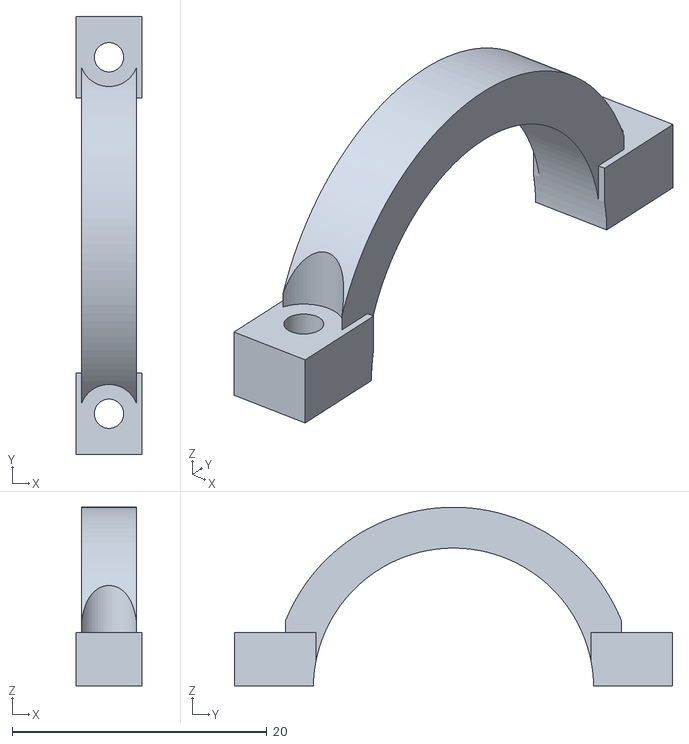
[picture p10: CAD file, 2026-11-03]
fabricacion/STL_POR_COLORES/NEGRO_PETG/78_V15_ET_RADIAL_CLAMP_13F.stl
5.20 x 34.4 x 14.0
