MTNRS/microduck-v15/fabricacion/STL_POR_COLORES/NEGRO_TPU_95A/42_V7_SRC_V4_MD_ankle_right__sole_right.stl

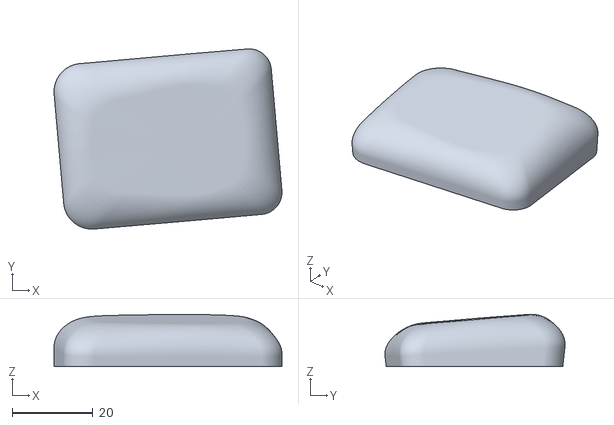
[picture p11: CAD file, 2026-11-03]
fabricacion/STL_POR_COLORES/NEGRO_TPU_95A/42_V7_SRC_V4_MD_ankle_right__sole_right.stl
56.3 x 44.5 x 12.9
