MTNRS/microduck-v15/fabricacion/ACCESORIOS_LLAVE/V15_LLAVE_57045_CUNA.stl

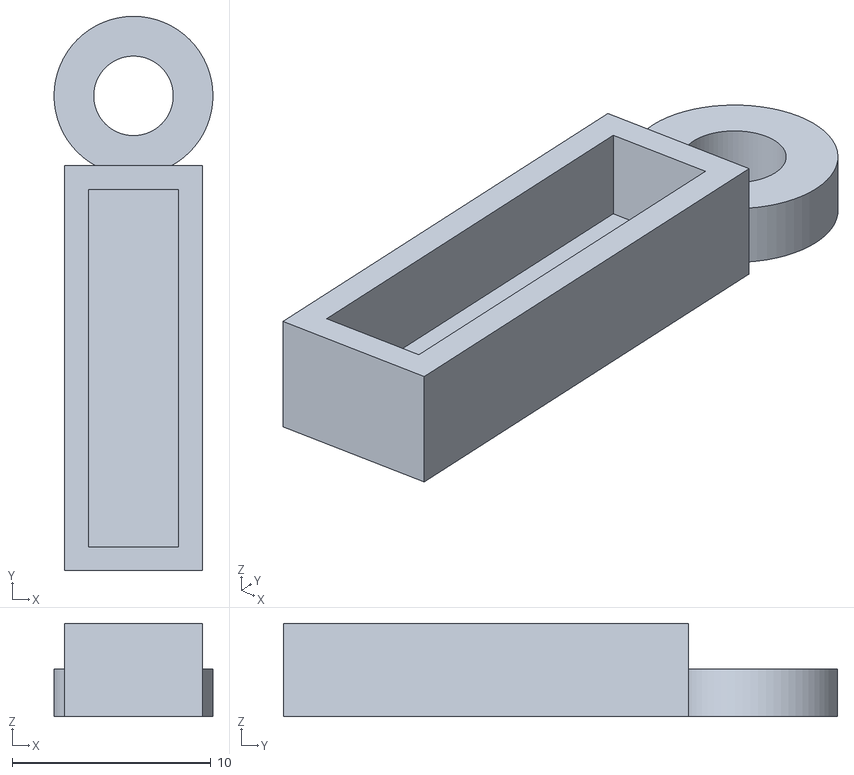
[picture p12: CAD file, 2026-11-03]
fabricacion/ACCESORIOS_LLAVE/V15_LLAVE_57045_CUNA.stl
8.00 x 27.9 x 4.70
