MTNRS/microduck-v15/fabricacion/PROBETAS_PRIMERO/03_VENTANA_MG90S_200.stl

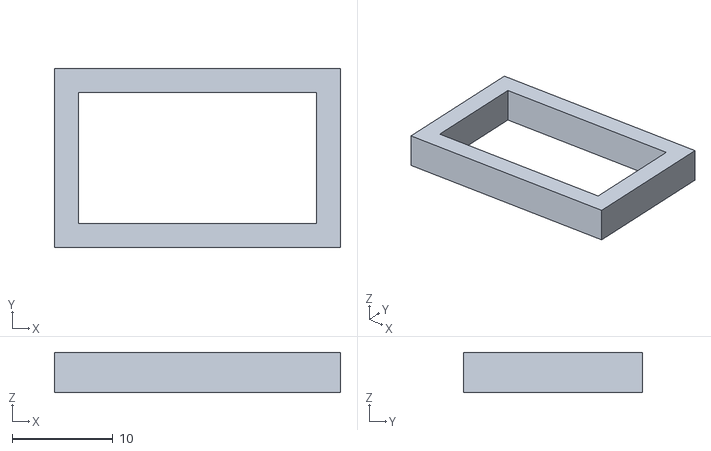
[picture p13: CAD file, 2026-11-03]
fabricacion/PROBETAS_PRIMERO/03_VENTANA_MG90S_200.stl
28.4 x 17.8 x 4.00
