MTNRS/microduck-v15/fabricacion/PROYECTOS_PRUSA_PAUSAS/P23_V7_TAPA_BRAZO_10_PAUSAS.3mf

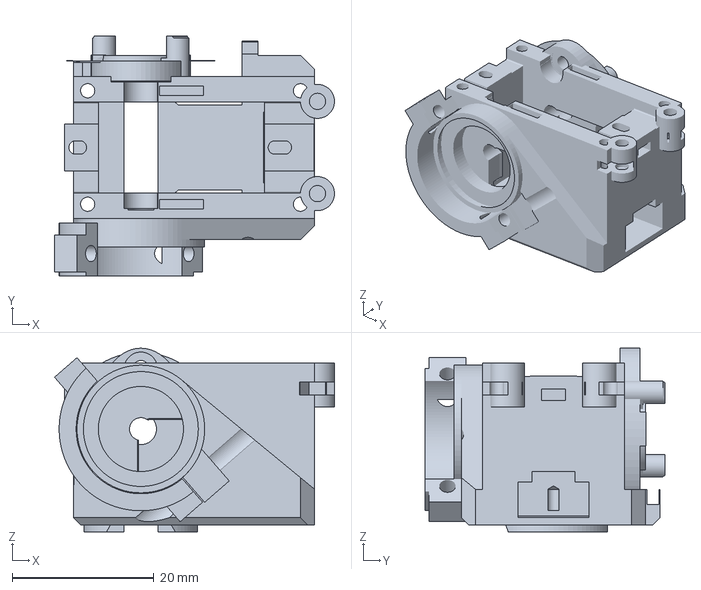
[picture p14: CAD file, 2026-11-03]
fabricacion/PROYECTOS_PRUSA_PAUSAS/P23_V7_TAPA_BRAZO_10_PAUSAS.3mf
39.5 x 33.9 x 25.9 mm
