MTNRS/microduck-v15/fabricacion/STL_POR_COLORES/AZUL_CIELO_PETG/45_12CASE_TAPA_TRASERA_ENRASADA.stl

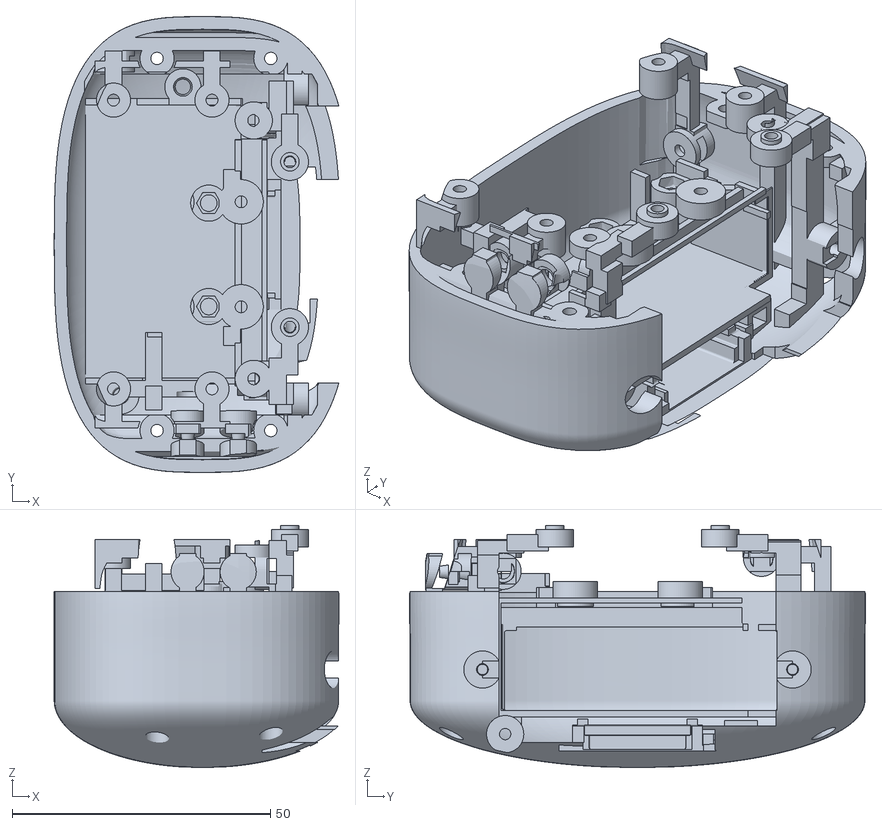
[picture p15: CAD file, 2026-11-03]
fabricacion/STL_POR_COLORES/AZUL_CIELO_PETG/45_12CASE_TAPA_TRASERA_ENRASADA.stl
55.1 x 88.2 x 46.9
