MTNRS/microduck-v15/fabricacion/STL_POR_COLORES/NARANJA_PETG/36_V7_HEAD_JAW_FIJO.stl

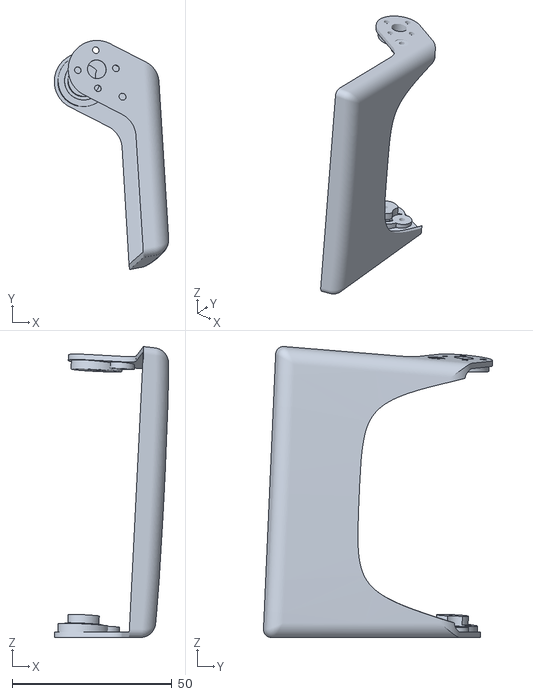
[picture p16: CAD file, 2026-11-03]
fabricacion/STL_POR_COLORES/NARANJA_PETG/36_V7_HEAD_JAW_FIJO.stl
35.9 x 71.8 x 91.2
