MTNRS/microduck-v15/fabricacion/STL_POR_COLORES/NARANJA_TPU95A/38_V7_HEAD_LIP_LOWER_RELIEVED.stl

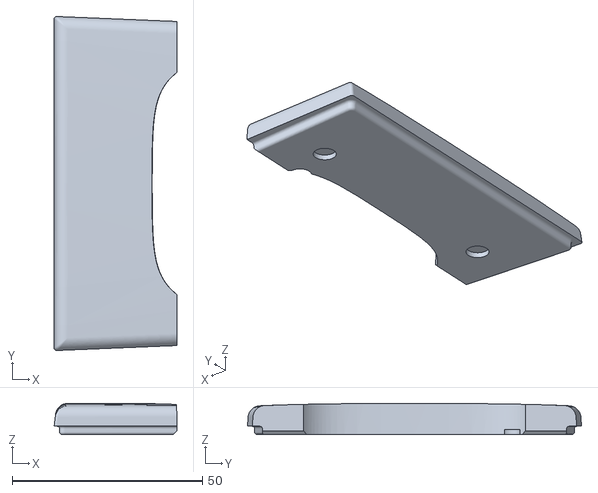
[picture p17: CAD file, 2026-11-03]
fabricacion/STL_POR_COLORES/NARANJA_TPU95A/38_V7_HEAD_LIP_LOWER_RELIEVED.stl
32.2 x 87.7 x 8.20
