MTNRS/microduck-v15/fabricacion/STL_POR_COLORES/NEGRO_PETG/19_V7_TAPA_BRAZO_05.stl

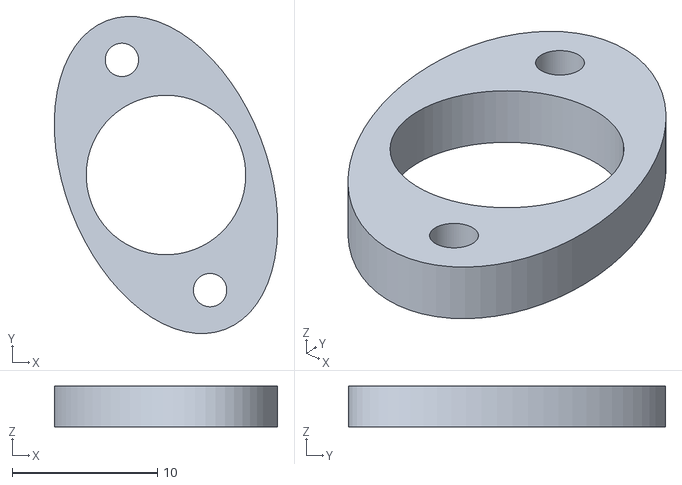
[picture p18: CAD file, 2026-11-03]
fabricacion/STL_POR_COLORES/NEGRO_PETG/19_V7_TAPA_BRAZO_05.stl
15.4 x 21.9 x 2.80
