MTNRS/microduck-v15/fabricacion/PROBETAS_PRIMERO/04_VENTANA_MG90S_400.stl

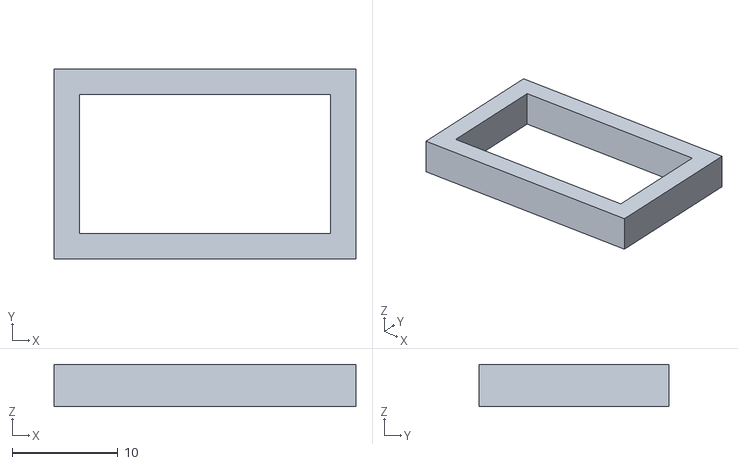
[picture p19: CAD file, 2026-11-03]
fabricacion/PROBETAS_PRIMERO/04_VENTANA_MG90S_400.stl
28.6 x 18.0 x 4.00
