MTNRS/microduck-v15/fabricacion/STL_POR_COLORES/AZUL_CIELO_PETG/20_V7_TAPA_BRAZO_06.stl

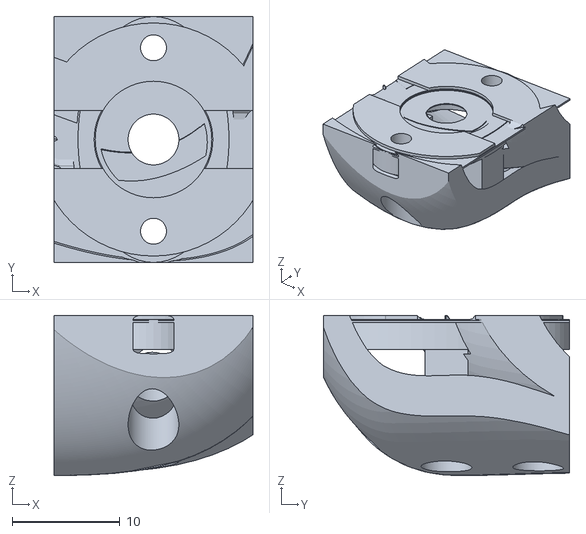
[picture p20: CAD file, 2026-11-03]
fabricacion/STL_POR_COLORES/AZUL_CIELO_PETG/20_V7_TAPA_BRAZO_06.stl
18.4 x 22.8 x 14.8
