MTNRS/microduck-v15/fabricacion/STL_POR_COLORES/NEGRO_PETG/18_V7_TAPA_BRAZO_04.stl

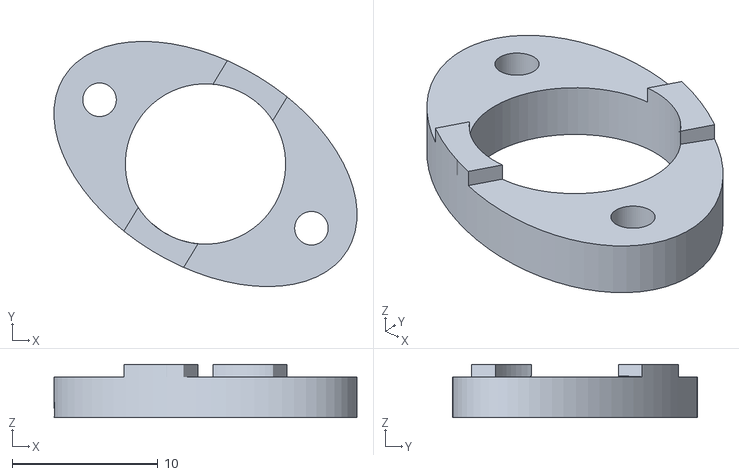
[picture p21: CAD file, 2026-11-03]
fabricacion/STL_POR_COLORES/NEGRO_PETG/18_V7_TAPA_BRAZO_04.stl
20.8 x 16.8 x 3.65
