MTNRS/microduck-v15/fabricacion/PROBETAS_PRIMERO/05_ALOJAMIENTOS_TUERCAS.stl

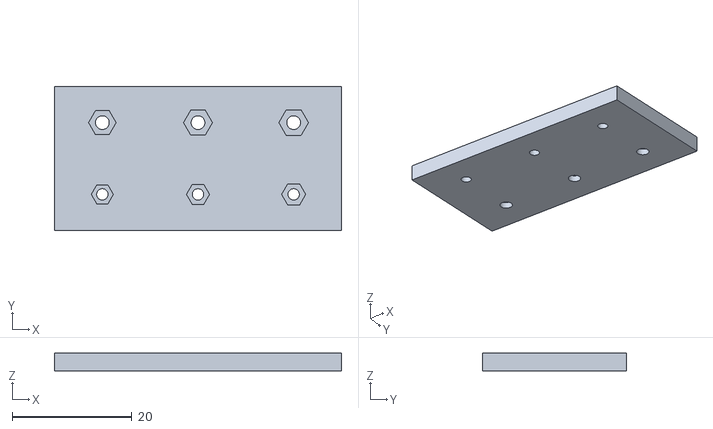
[picture p22: CAD file, 2026-11-03]
fabricacion/PROBETAS_PRIMERO/05_ALOJAMIENTOS_TUERCAS.stl
48.0 x 24.0 x 3.00
