MTNRS/microduck-v15/fabricacion/PROYECTOS_PRUSA_PAUSAS/P06_V7_MOD_NECK_PAUSAS.3mf

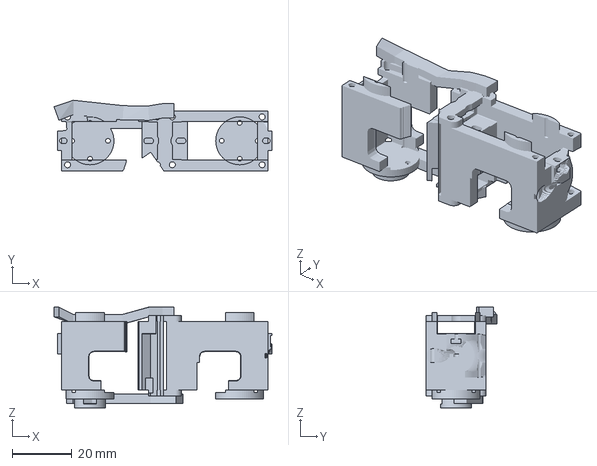
[picture p23: CAD file, 2026-11-03]
fabricacion/PROYECTOS_PRUSA_PAUSAS/P06_V7_MOD_NECK_PAUSAS.3mf
72.8 x 23.6 x 33.6 mm
