MTNRS/microduck-v15/fabricacion/PROBETAS_PRIMERO/01_PASOS_TORNILLOS.stl

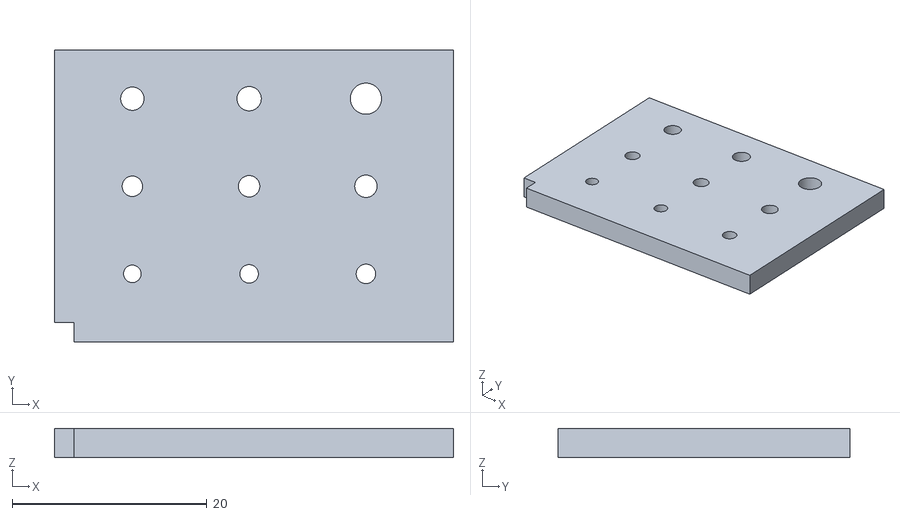
[picture p24: CAD file, 2026-11-03]
fabricacion/PROBETAS_PRIMERO/01_PASOS_TORNILLOS.stl
41.0 x 30.0 x 3.00
