MTNRS/microduck-v15/fabricacion/PROYECTOS_PRUSA_PAUSAS/P44_12CASE_TORSO_CONTINUO_PAUSAS.3mf

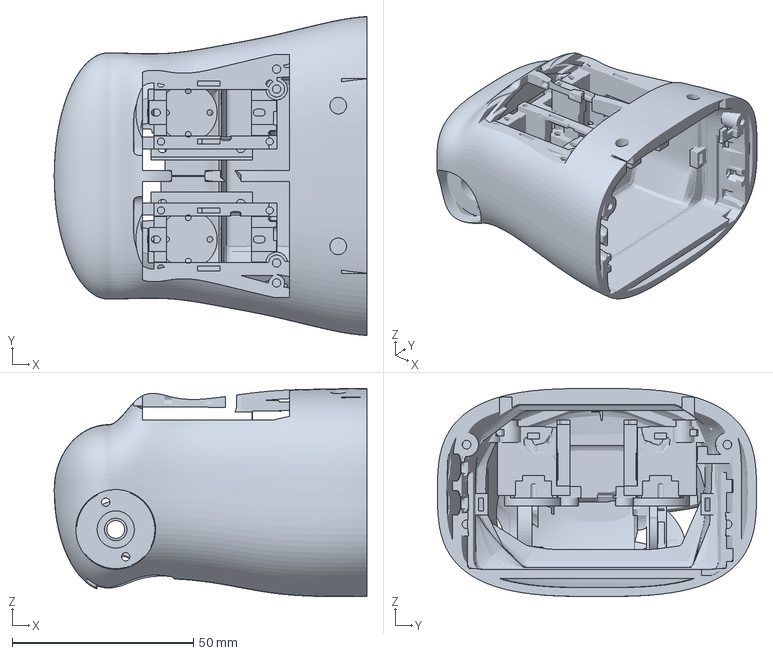
[picture p25: CAD file, 2026-11-03]
fabricacion/PROYECTOS_PRUSA_PAUSAS/P44_12CASE_TORSO_CONTINUO_PAUSAS.3mf
86.3 x 88.0 x 57.5 mm
