MTNRS/microduck-v15/fabricacion/STL_POR_COLORES/NEGRO_PETG/48_V15_SERVICE_FRONT_YAW_ROLL_MOTION_0.stl

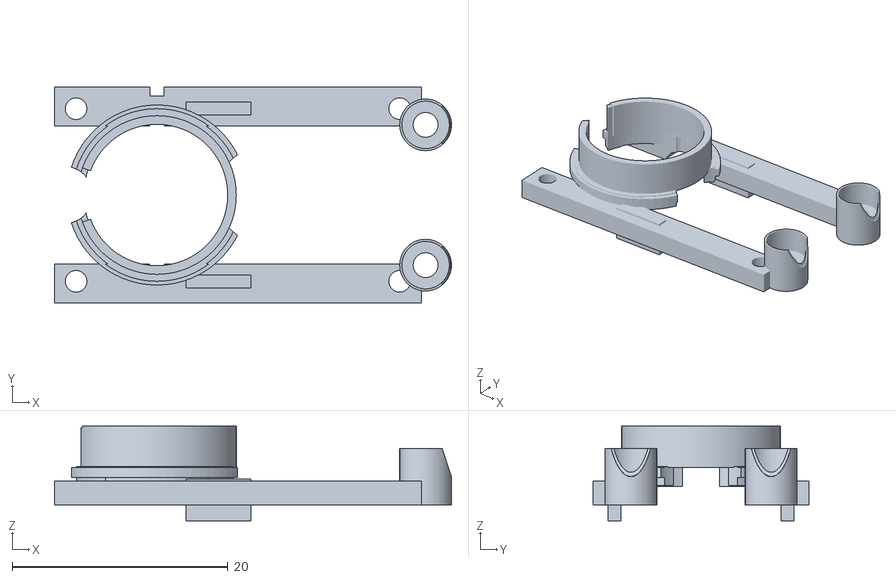
[picture p26: CAD file, 2026-11-03]
fabricacion/STL_POR_COLORES/NEGRO_PETG/48_V15_SERVICE_FRONT_YAW_ROLL_MOTION_0.stl
36.8 x 20.0 x 8.80
