MTNRS/microduck-v15/fabricacion/PROYECTOS_PRUSA_PAUSAS/P14_V7_TAPA_BRAZO_00_PAUSAS.3mf

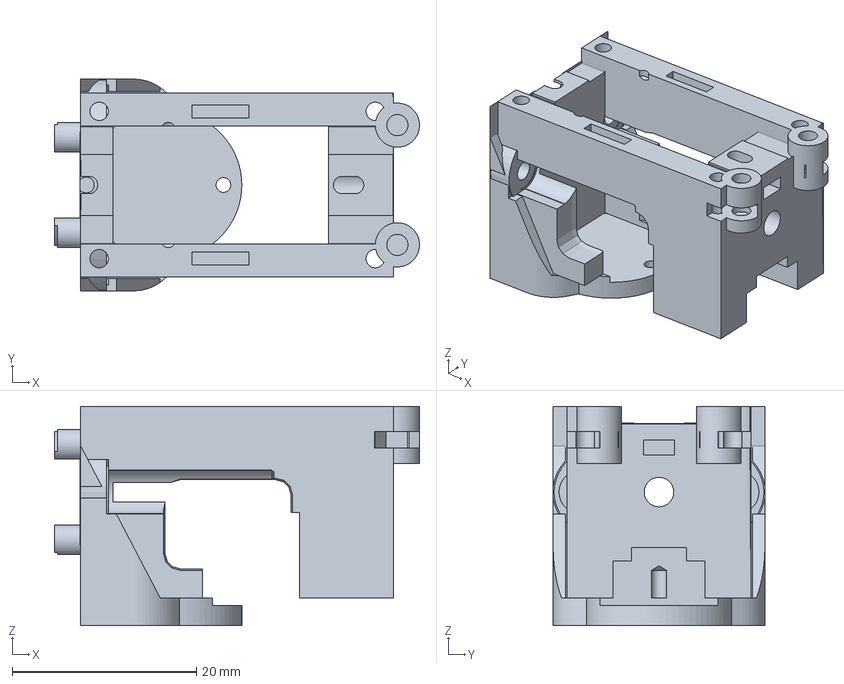
[picture p27: CAD file, 2026-11-03]
fabricacion/PROYECTOS_PRUSA_PAUSAS/P14_V7_TAPA_BRAZO_00_PAUSAS.3mf
39.7 x 23.0 x 23.8 mm
