MTNRS/microduck-v15/fabricacion/STL_POR_COLORES/AZUL_CIELO_PETG/51_V15_SERVICE_FRONT_UPPER_LEG_RIGHT_0.stl

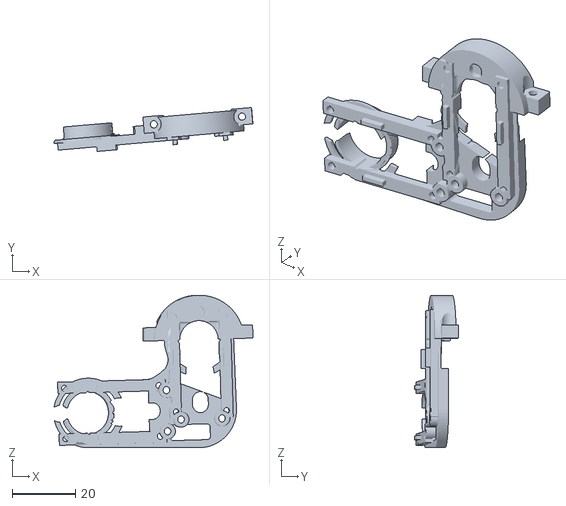
[picture p28: CAD file, 2026-11-03]
fabricacion/STL_POR_COLORES/AZUL_CIELO_PETG/51_V15_SERVICE_FRONT_UPPER_LEG_RIGHT_0.stl
62.9 x 13.9 x 48.2
