MTNRS/microduck-v15/fabricacion/PROYECTOS_PRUSA_PAUSAS/P04_V7_MOD_LEG_PAUSAS.3mf

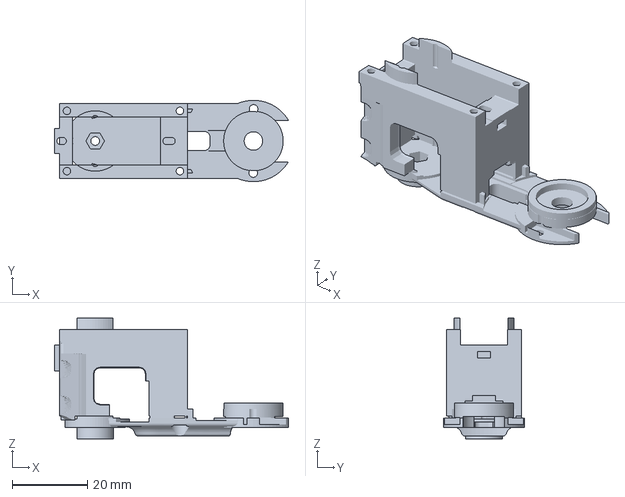
[picture p29: CAD file, 2026-11-03]
fabricacion/PROYECTOS_PRUSA_PAUSAS/P04_V7_MOD_LEG_PAUSAS.3mf
62.1 x 21.6 x 32.0 mm
