MTNRS/microduck-v15/fabricacion/STL_POR_COLORES/AZUL_CIELO_PETG/52_V15_SERVICE_FRONT_TRUNK_BASE_0.stl

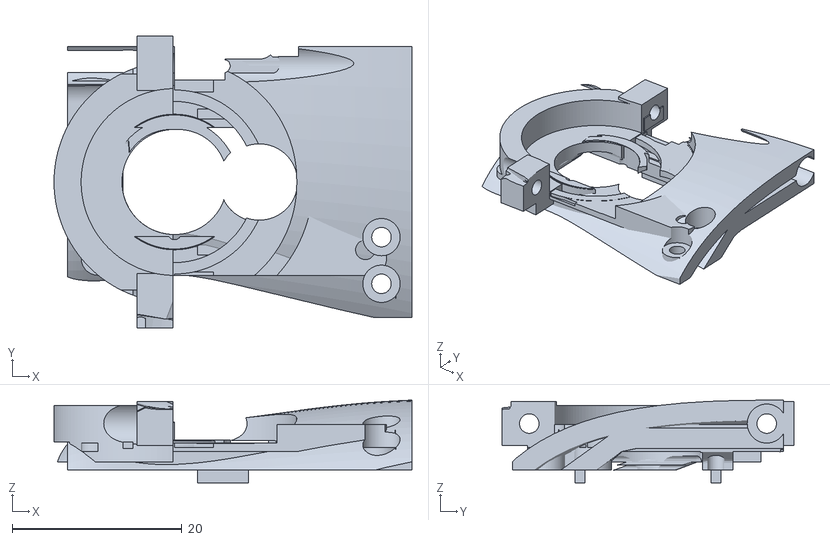
[picture p30: CAD file, 2026-11-03]
fabricacion/STL_POR_COLORES/AZUL_CIELO_PETG/52_V15_SERVICE_FRONT_TRUNK_BASE_0.stl
42.2 x 34.4 x 9.77
