MTNRS/microduck-v15/fabricacion/STL_POR_COLORES/NEGRO_PETG/50_V15_SERVICE_FRONT_BEARING_ROLL.stl

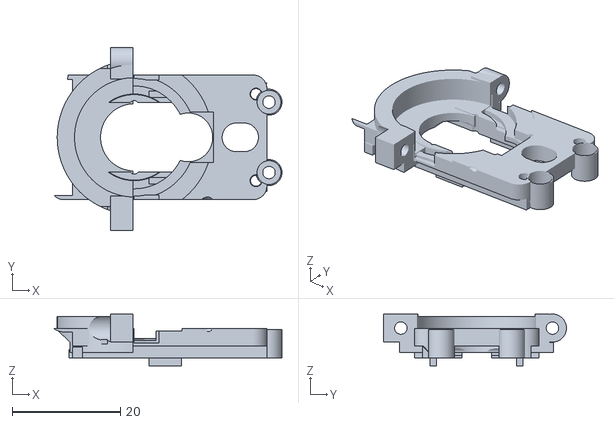
[picture p32: CAD file, 2026-11-03]
fabricacion/STL_POR_COLORES/NEGRO_PETG/50_V15_SERVICE_FRONT_BEARING_ROLL.stl
42.1 x 33.8 x 9.60
