MTNRS/microduck-v15/fabricacion/STL_POR_COLORES/NEGRO_PETG/27_V7_TAPA_BRAZO_14.stl

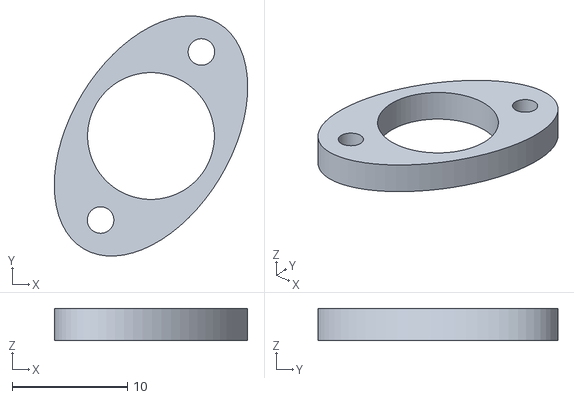
[picture p33: CAD file, 2026-11-03]
fabricacion/STL_POR_COLORES/NEGRO_PETG/27_V7_TAPA_BRAZO_14.stl
16.8 x 20.8 x 2.80
