MTNRS/microduck-v15/fabricacion/STL_POR_COLORES/AZUL_CIELO_PETG/33_V7_HEAD_TOP_ANCLADO.stl

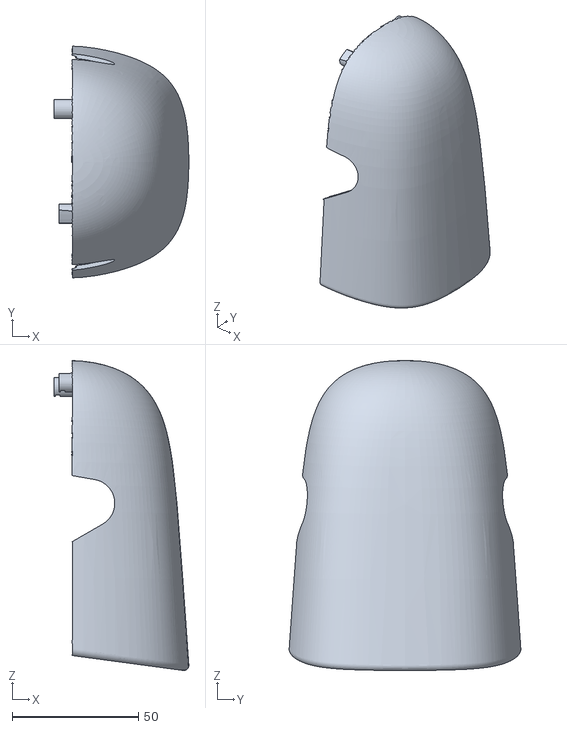
[picture p34: CAD file, 2026-11-03]
fabricacion/STL_POR_COLORES/AZUL_CIELO_PETG/33_V7_HEAD_TOP_ANCLADO.stl
53.3 x 91.7 x 122.7
