MTNRS/microduck-v15/fabricacion/STL_POR_COLORES/NEGRO_PETG/43_V7_SRC_V5_PI_ZERO_BANDEJA_CON_ANCLAJES.stl

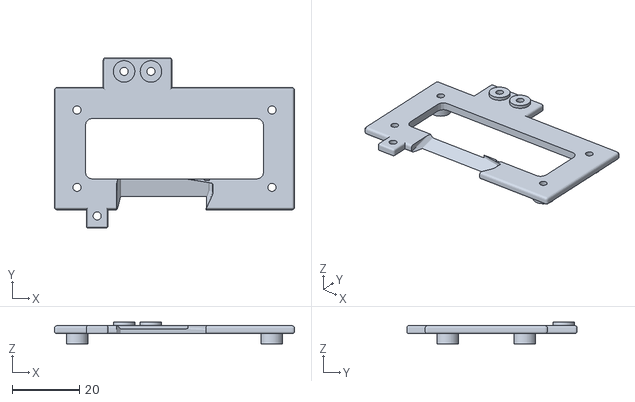
[picture p35: CAD file, 2026-11-03]
fabricacion/STL_POR_COLORES/NEGRO_PETG/43_V7_SRC_V5_PI_ZERO_BANDEJA_CON_ANCLAJES.stl
71.4 x 50.6 x 6.40
