MTNRS/microduck-v15/fabricacion/STL_POR_COLORES/NEGRO_PETG/57_V15_FOOT_R_HEEL_ACTUADOR.stl

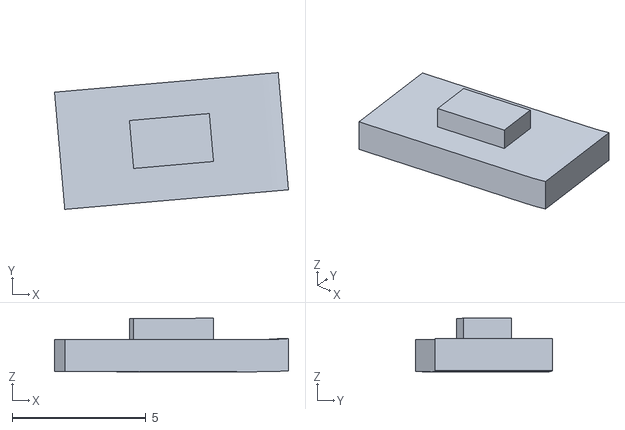
[picture p36: CAD file, 2026-11-03]
fabricacion/STL_POR_COLORES/NEGRO_PETG/57_V15_FOOT_R_HEEL_ACTUADOR.stl
8.75 x 5.12 x 2.00
