MTNRS/microduck-v15/fabricacion/STL_POR_COLORES/AZUL_CIELO_PETG/65_V15_D24_BANDEJA_INFERIOR_DESMONTABLE.stl

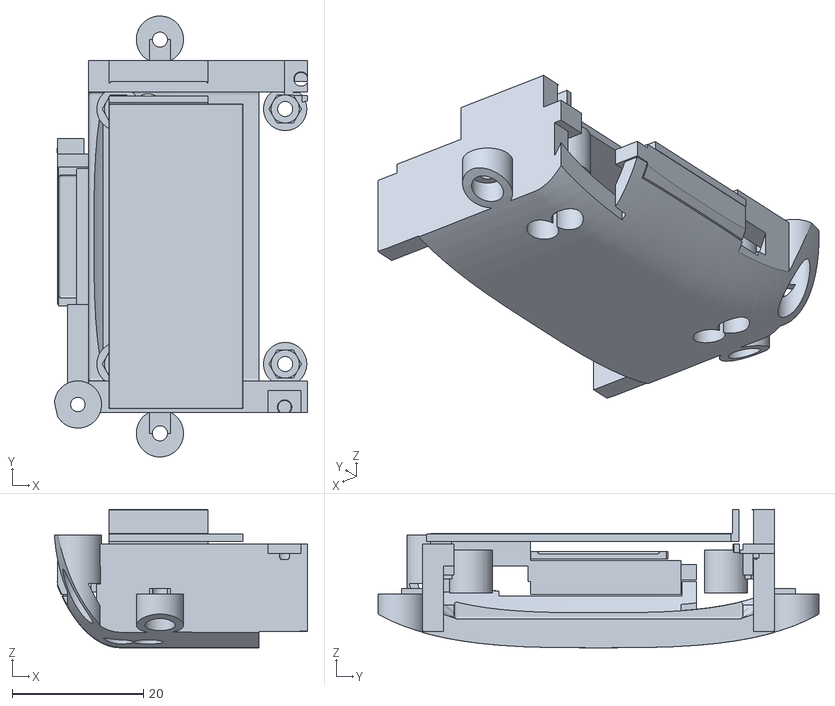
[picture p37: CAD file, 2026-11-03]
fabricacion/STL_POR_COLORES/AZUL_CIELO_PETG/65_V15_D24_BANDEJA_INFERIOR_DESMONTABLE.stl
38.6 x 67.2 x 21.1
