MTNRS/microduck-v15/fabricacion/STL_POR_COLORES/NEGRO_PETG/66_V15_BM_FR4_CAP_R2.stl

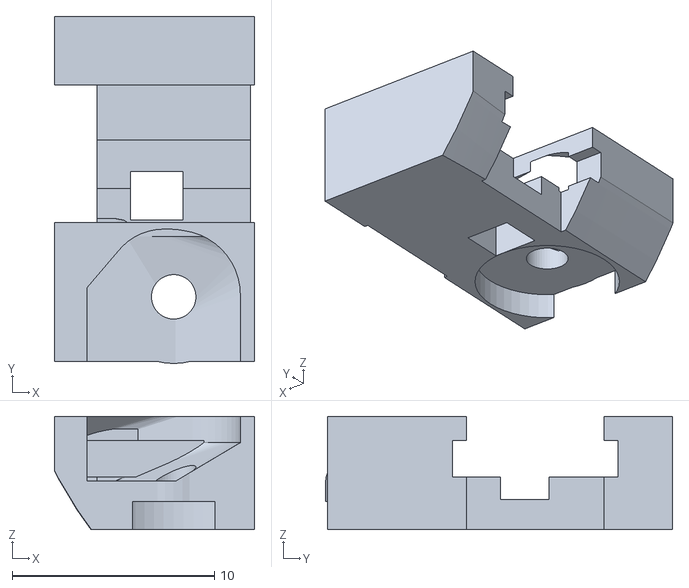
[picture p38: CAD file, 2026-11-03]
fabricacion/STL_POR_COLORES/NEGRO_PETG/66_V15_BM_FR4_CAP_R2.stl
9.90 x 17.2 x 5.60
