MTNRS/microduck-v15/fabricacion/STL_POR_COLORES/NEGRO_PETG/31_V7_RETENEDOR_PASIVO_TOBILLO_05.stl

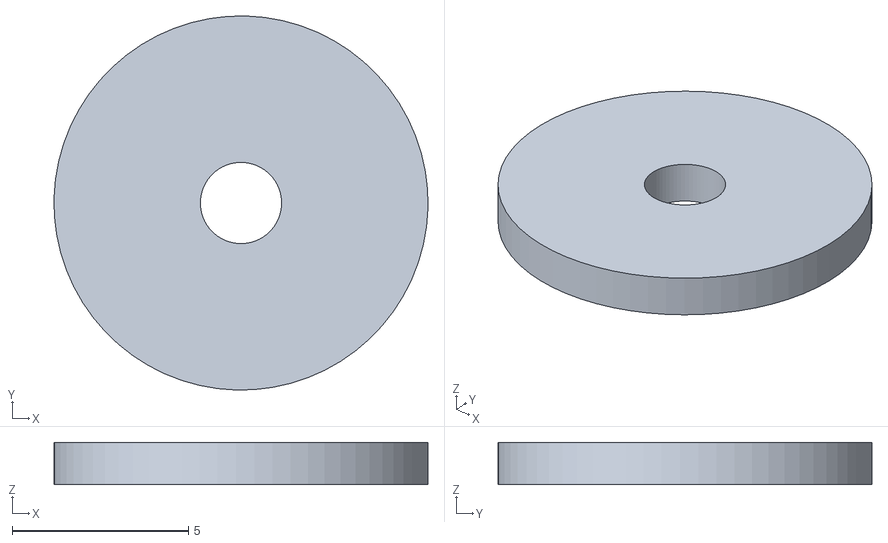
[picture p39: CAD file, 2026-11-03]
fabricacion/STL_POR_COLORES/NEGRO_PETG/31_V7_RETENEDOR_PASIVO_TOBILLO_05.stl
10.6 x 10.6 x 1.20
