MTNRS/microduck-v15/fabricacion/STL_POR_COLORES/NEGRO_PETG/22_V7_TAPA_BRAZO_08.stl

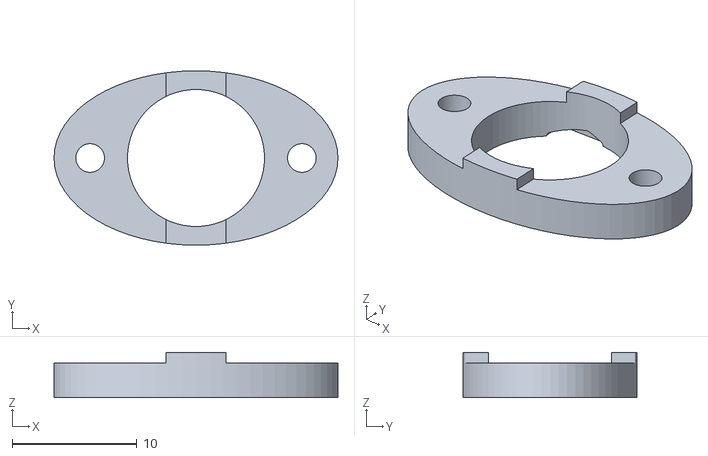
[picture p40: CAD file, 2026-11-03]
fabricacion/STL_POR_COLORES/NEGRO_PETG/22_V7_TAPA_BRAZO_08.stl
22.8 x 14.0 x 3.65
