MTNRS/microduck-v15/fabricacion/STL_POR_COLORES/NEGRO_PETG/07_V7_MOD_NECK_PITCH.stl

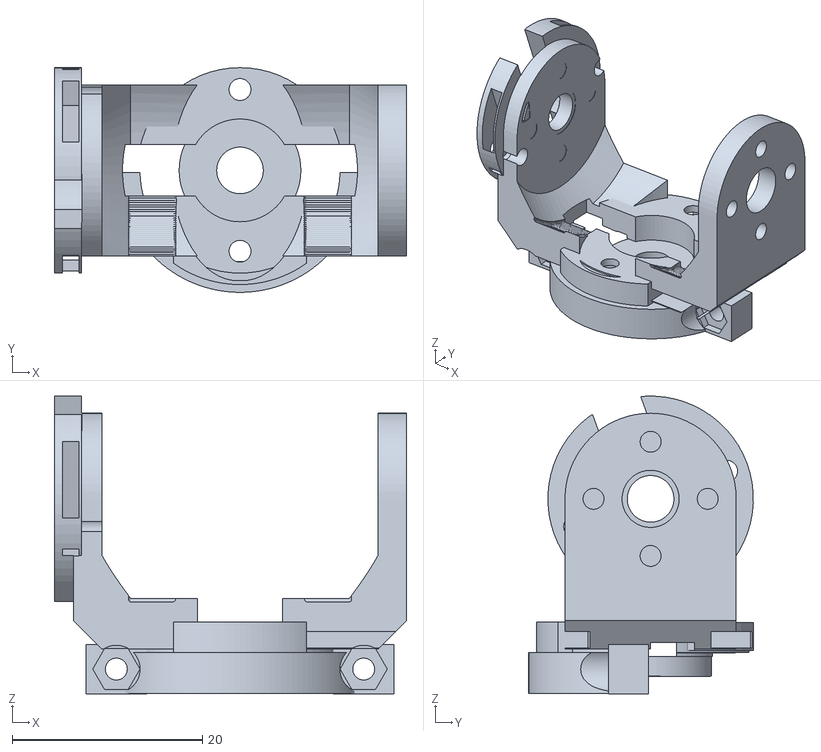
[picture p41: CAD file, 2026-11-03]
fabricacion/STL_POR_COLORES/NEGRO_PETG/07_V7_MOD_NECK_PITCH.stl
37.0 x 23.6 x 31.3
