MTNRS/microduck-v15/fabricacion/STL_POR_COLORES/NEGRO_PETG/54_V15_OJO_CIEGO_IMPRIMIBLE.stl

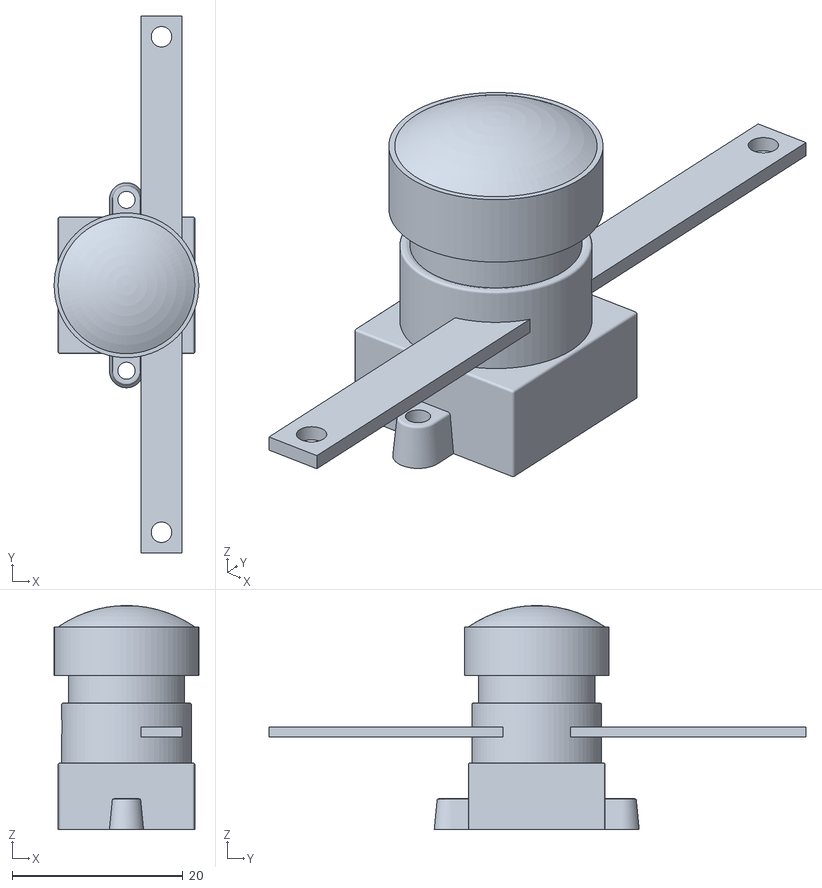
[picture p42: CAD file, 2026-11-03]
fabricacion/STL_POR_COLORES/NEGRO_PETG/54_V15_OJO_CIEGO_IMPRIMIBLE.stl
16.9 x 62.8 x 26.2
