MTNRS/microduck-v15/fabricacion/STL_POR_COLORES/NEGRO_PETG/64_V15_ADC_CARRIER_DESMONTABLE.stl

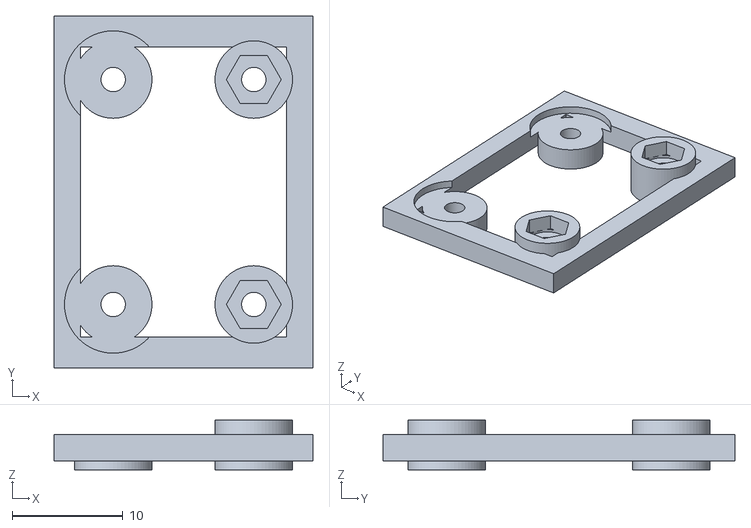
[picture p43: CAD file, 2026-11-03]
fabricacion/STL_POR_COLORES/NEGRO_PETG/64_V15_ADC_CARRIER_DESMONTABLE.stl
23.4 x 31.8 x 4.50
