MTNRS/microduck-v15/fabricacion/STL_POR_COLORES/NEGRO_PETG/67_V15_BM_FR4_KEY_R2.stl

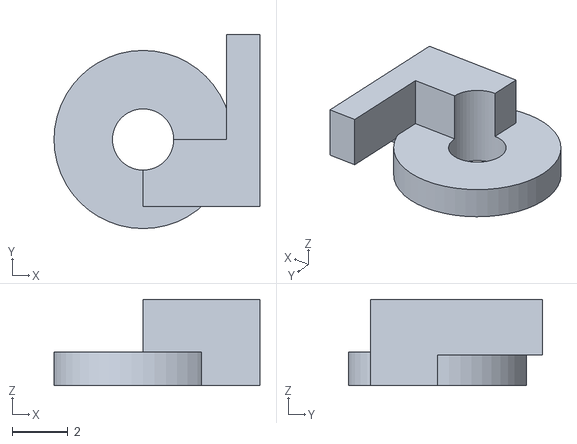
[picture p44: CAD file, 2026-11-03]
fabricacion/STL_POR_COLORES/NEGRO_PETG/67_V15_BM_FR4_KEY_R2.stl
7.40 x 6.97 x 3.10
