MTNRS/microduck-v15/fabricacion/STL_POR_COLORES/NEGRO_PETG/62_V15_PCM_TOPE_DESMONTABLE.stl

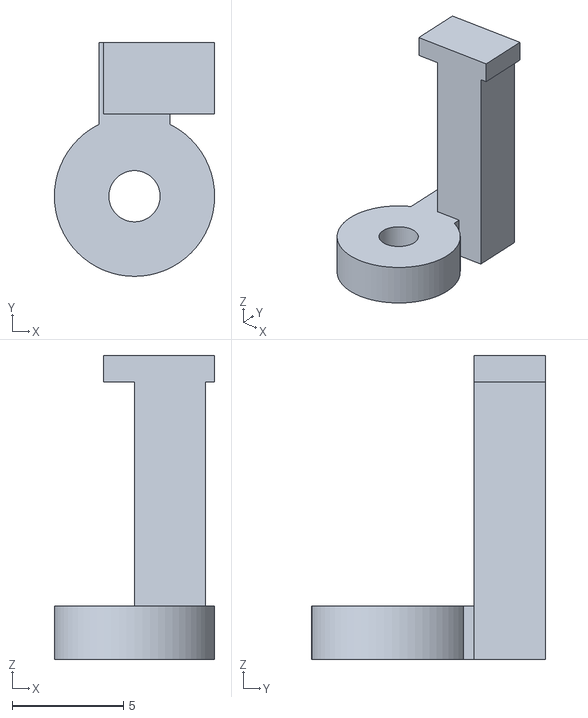
[picture p45: CAD file, 2026-11-03]
fabricacion/STL_POR_COLORES/NEGRO_PETG/62_V15_PCM_TOPE_DESMONTABLE.stl
7.20 x 10.5 x 13.7
