MTNRS/microduck-v15/fabricacion/STL_POR_COLORES/NEGRO_PETG/68_V15_PCM_TOPE_DESMONTABLE_DERECHO.stl

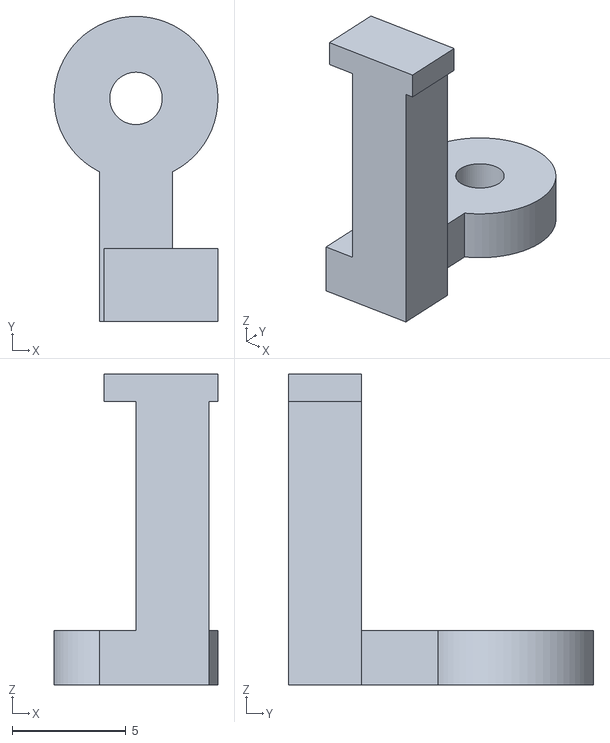
[picture p46: CAD file, 2026-11-03]
fabricacion/STL_POR_COLORES/NEGRO_PETG/68_V15_PCM_TOPE_DESMONTABLE_DERECHO.stl
7.20 x 13.4 x 13.7
