MTNRS/microduck-v15/fabricacion/STL_POR_COLORES/NEGRO_PETG/05_V7_MOD_ANKLE_LEFT.stl

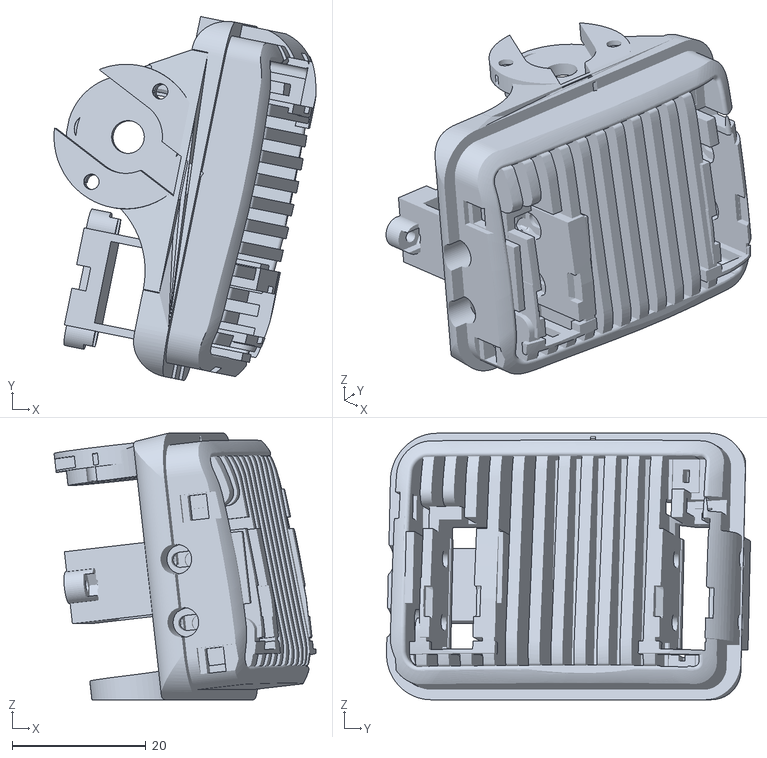
[picture p47: CAD file, 2026-11-03]
fabricacion/STL_POR_COLORES/NEGRO_PETG/05_V7_MOD_ANKLE_LEFT.stl
39.1 x 54.4 x 39.8
