MTNRS/microduck-v15/fabricacion/STL_POR_COLORES/NEGRO_PETG/56_V15_FOOT_L_TOE_ACTUADOR.stl

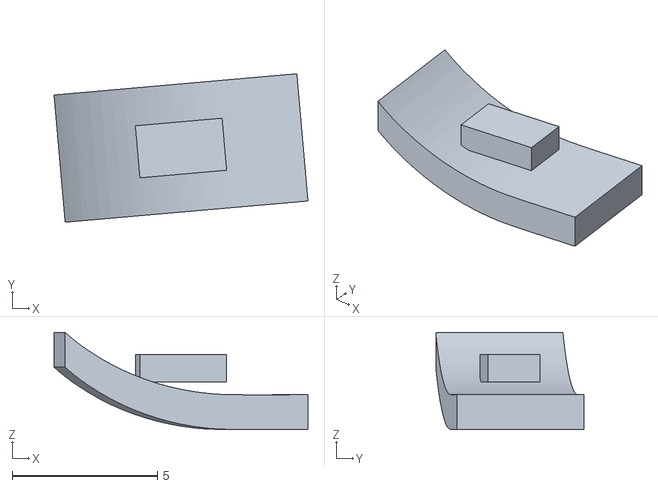
[picture p48: CAD file, 2026-11-03]
fabricacion/STL_POR_COLORES/NEGRO_PETG/56_V15_FOOT_L_TOE_ACTUADOR.stl
8.75 x 5.12 x 3.35
