MTNRS/microduck-v15/fabricacion/STL_POR_COLORES/NEGRO_PETG/24_V7_TAPA_BRAZO_11.stl

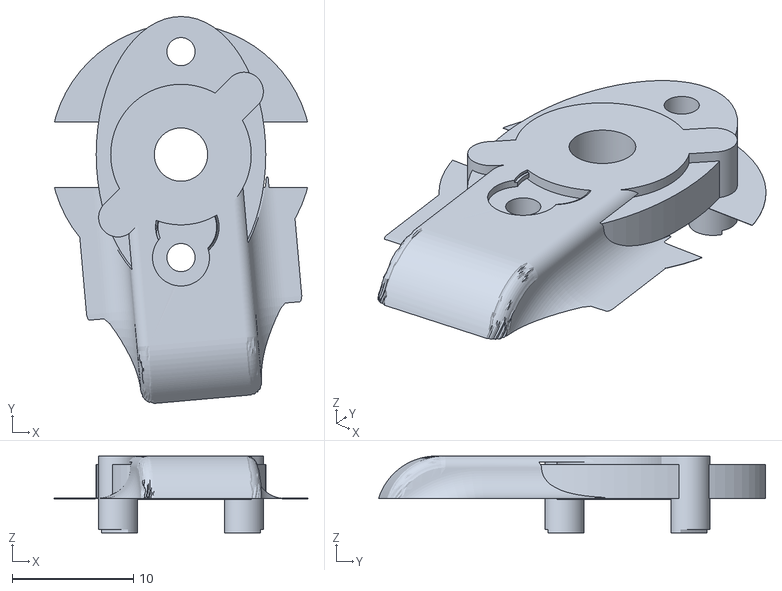
[picture p49: CAD file, 2026-11-03]
fabricacion/STL_POR_COLORES/NEGRO_PETG/24_V7_TAPA_BRAZO_11.stl
20.9 x 31.9 x 6.35
