MTNRS/microduck-v15/fabricacion/STL_POR_COLORES/NEGRO_PETG/10_V7_MOD_HIP_L_2.stl

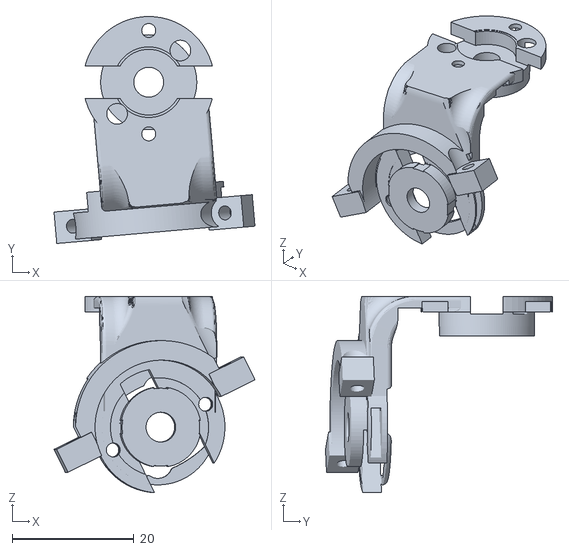
[picture p50: CAD file, 2026-11-03]
fabricacion/STL_POR_COLORES/NEGRO_PETG/10_V7_MOD_HIP_L_2.stl
33.0 x 37.3 x 32.2
