MTNRS/microduck-v15/fabricacion/STL_POR_COLORES/NEGRO_PETG/01_V7_MOD_YAW2ROLL.stl

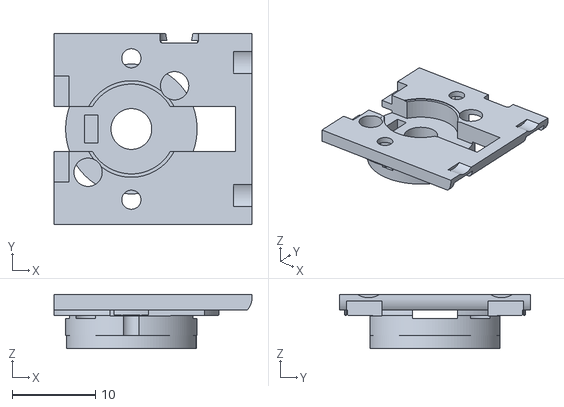
[picture p51: CAD file, 2026-11-03]
fabricacion/STL_POR_COLORES/NEGRO_PETG/01_V7_MOD_YAW2ROLL.stl
23.8 x 23.0 x 6.53
