MTNRS/microduck-v15/fabricacion/STL_POR_COLORES/NEGRO_PETG/49_V15_SERVICE_FRONT_JAW_SOFT.stl

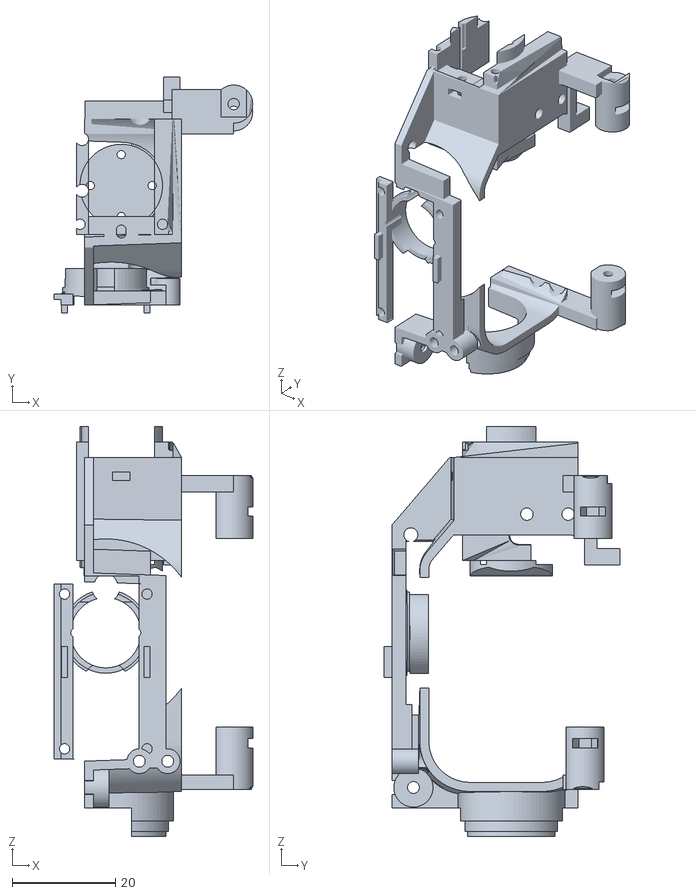
[picture p52: CAD file, 2026-11-03]
fabricacion/STL_POR_COLORES/NEGRO_PETG/49_V15_SERVICE_FRONT_JAW_SOFT.stl
38.5 x 45.8 x 79.5
