MTNRS/microduck-v15/fabricacion/STL_POR_COLORES/NEGRO_PETG/80_V15_6701_RADIAL_CLAMP_10R.stl

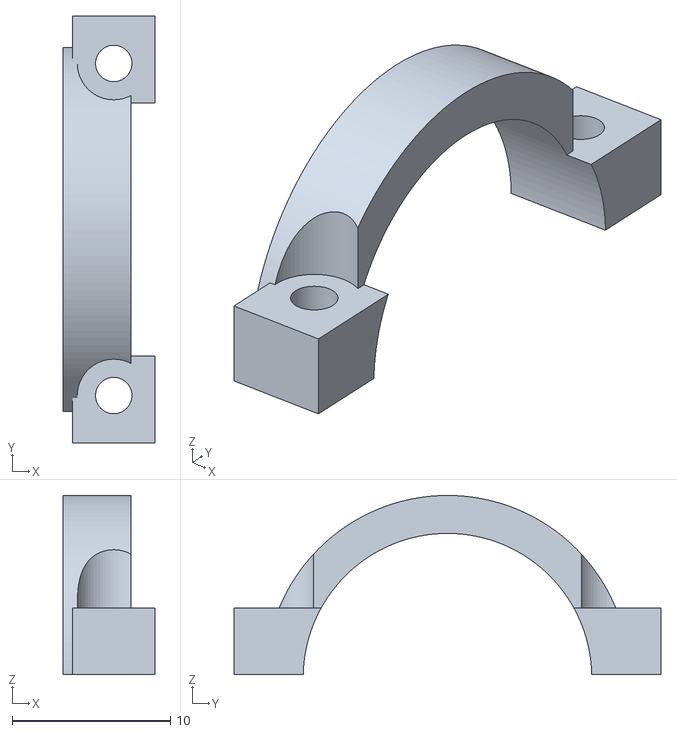
[picture p53: CAD file, 2026-11-03]
fabricacion/STL_POR_COLORES/NEGRO_PETG/80_V15_6701_RADIAL_CLAMP_10R.stl
5.80 x 27.0 x 11.3
