MTNRS/microduck-v15/fabricacion/STL_POR_COLORES/NEGRO_PETG/63_V15_REED_TAPA_PROTECTORA.stl

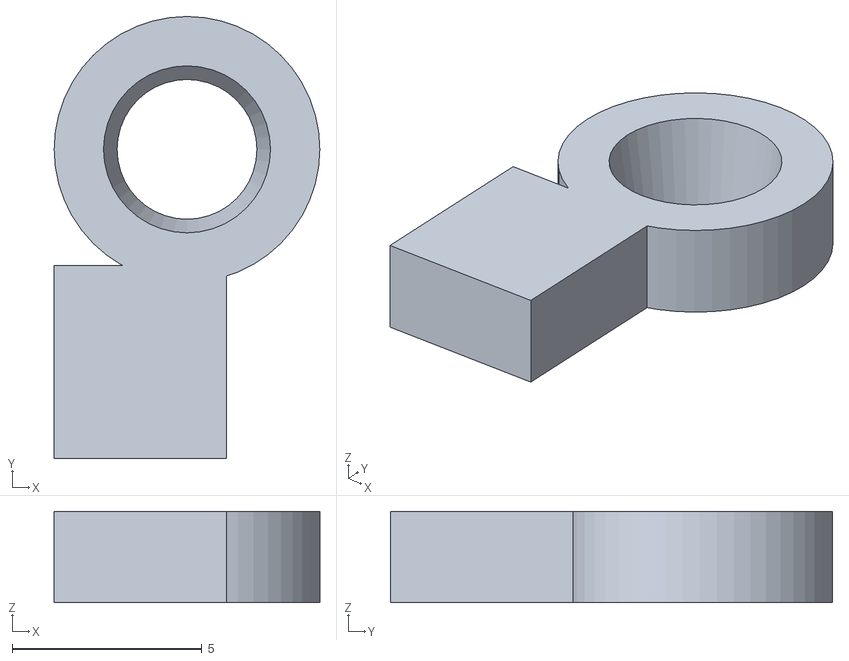
[picture p54: CAD file, 2026-11-03]
fabricacion/STL_POR_COLORES/NEGRO_PETG/63_V15_REED_TAPA_PROTECTORA.stl
7.00 x 11.6 x 2.40
