MTNRS/microduck-v15/fabricacion/STL_POR_COLORES/NEGRO_PETG/08_V7_MOD_YAW_ROLL_MOTION.stl

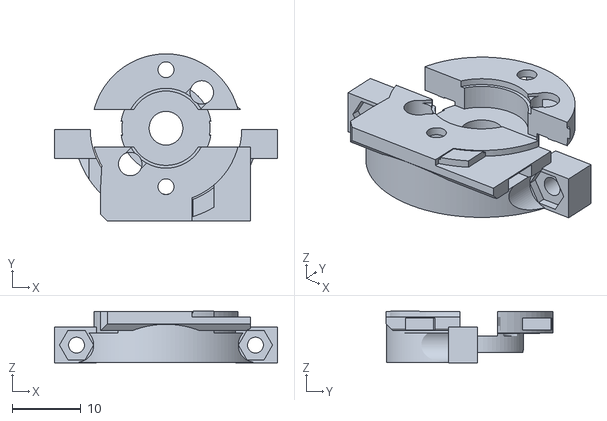
[picture p55: CAD file, 2026-11-03]
fabricacion/STL_POR_COLORES/NEGRO_PETG/08_V7_MOD_YAW_ROLL_MOTION.stl
32.4 x 24.3 x 7.55
