MTNRS/microduck-v15/fabricacion/STL_POR_COLORES/NEGRO_PETG/77_V15_ET_RADIAL_CLAMP_10F.stl

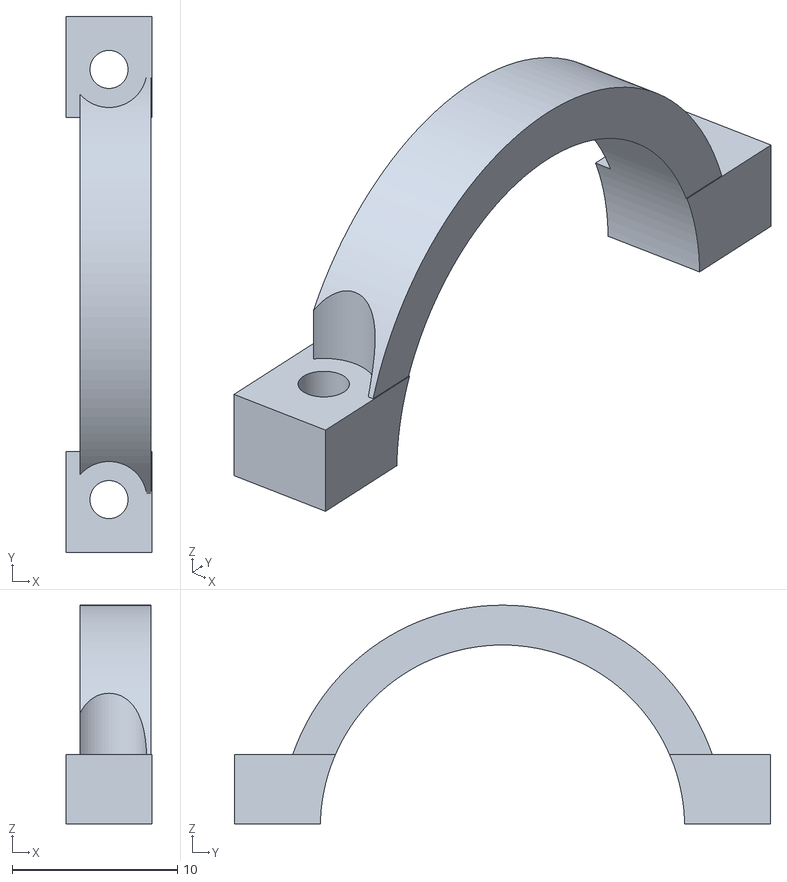
[picture p56: CAD file, 2026-11-03]
fabricacion/STL_POR_COLORES/NEGRO_PETG/77_V15_ET_RADIAL_CLAMP_10F.stl
5.20 x 32.4 x 13.2
