MTNRS/microduck-v15/fabricacion/STL_POR_COLORES/NEGRO_PETG/37_V7_HEADCORE_ANCLADO.stl

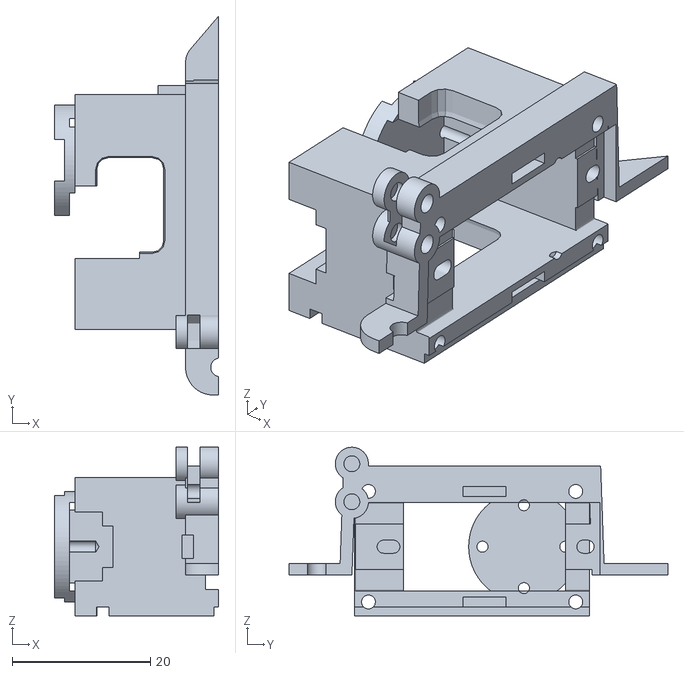
[picture p57: CAD file, 2026-11-03]
fabricacion/STL_POR_COLORES/NEGRO_PETG/37_V7_HEADCORE_ANCLADO.stl
23.8 x 54.9 x 24.4
