MTNRS/microduck-v15/fabricacion/STL_POR_COLORES/NEGRO_PETG/13_V7_MOD_ANKLE_RIGHT.stl

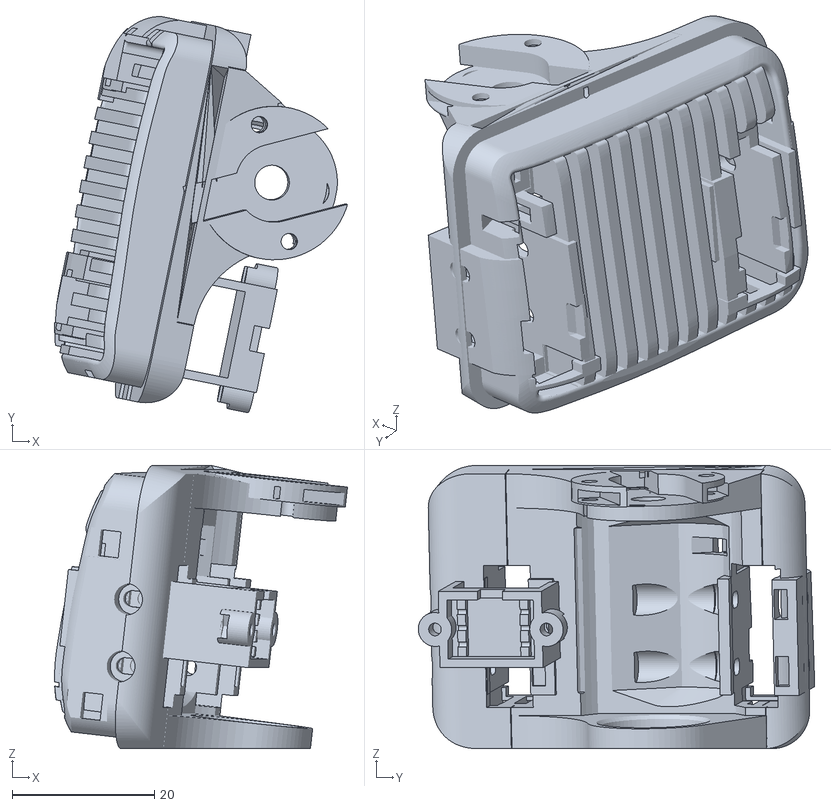
[picture p58: CAD file, 2026-11-03]
fabricacion/STL_POR_COLORES/NEGRO_PETG/13_V7_MOD_ANKLE_RIGHT.stl
41.2 x 55.8 x 39.8
