MTNRS/microduck-v15/fabricacion/STL_POR_COLORES/NEGRO_PETG/61_V15_K10_RETEN_DESMONTABLE.stl

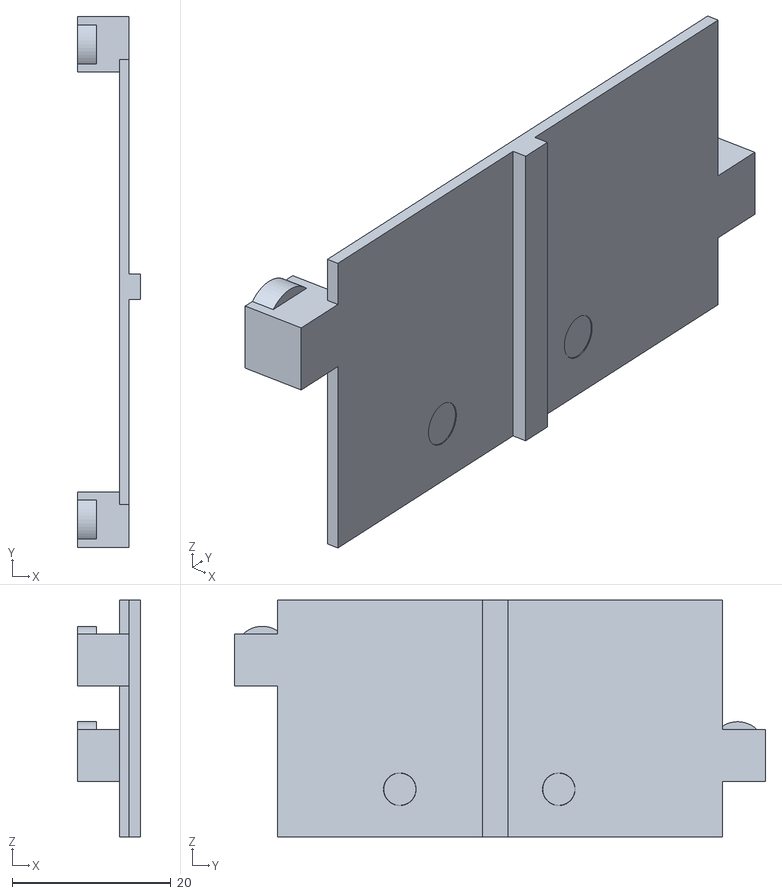
[picture p59: CAD file, 2026-11-03]
fabricacion/STL_POR_COLORES/NEGRO_PETG/61_V15_K10_RETEN_DESMONTABLE.stl
7.90 x 66.8 x 29.8
