MTNRS/microduck-v15/fabricacion/STL_POR_COLORES/NEGRO_PETG/59_V15_FOOT_L_TAPA_CIRCUITO.stl

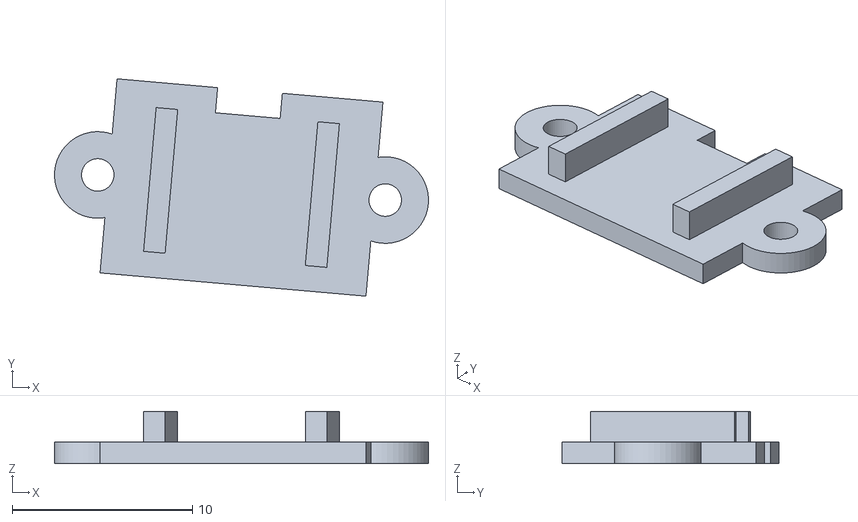
[picture p60: CAD file, 2026-11-03]
fabricacion/STL_POR_COLORES/NEGRO_PETG/59_V15_FOOT_L_TAPA_CIRCUITO.stl
20.7 x 12.0 x 2.90
