MTNRS/microduck-v15/fabricacion/STL_POR_COLORES/NEGRO_PETG/26_V7_TAPA_BRAZO_13.stl

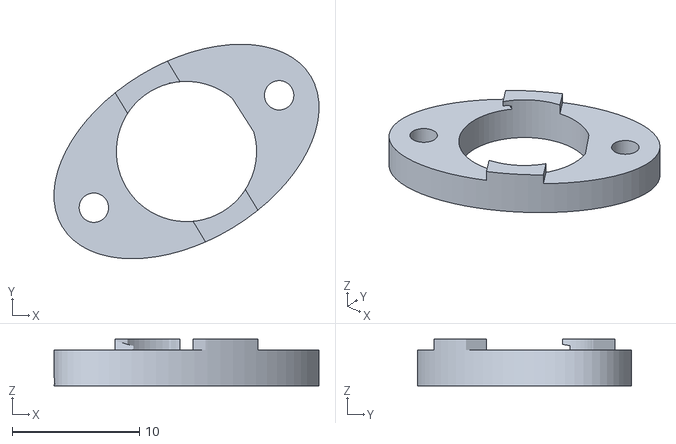
[picture p61: CAD file, 2026-11-03]
fabricacion/STL_POR_COLORES/NEGRO_PETG/26_V7_TAPA_BRAZO_13.stl
20.8 x 16.8 x 3.65
