MTNRS/microduck-v15/fabricacion/STL_POR_COLORES/NEGRO_PETG/74_V15_ET_RADIAL_CLAMP_11F.stl

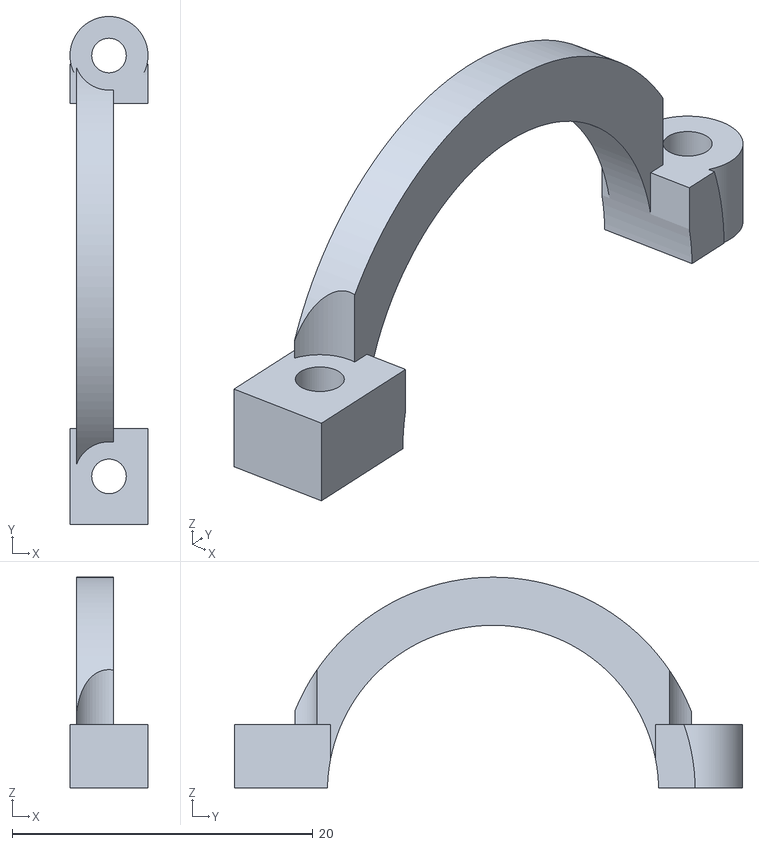
[picture p62: CAD file, 2026-11-03]
fabricacion/STL_POR_COLORES/NEGRO_PETG/74_V15_ET_RADIAL_CLAMP_11F.stl
5.20 x 33.8 x 14.0
