MTNRS/microduck-v15/fabricacion/STL_POR_COLORES/NEGRO_PETG/69_V15_HEADROLL_CHEEK_DESMONTABLE.stl

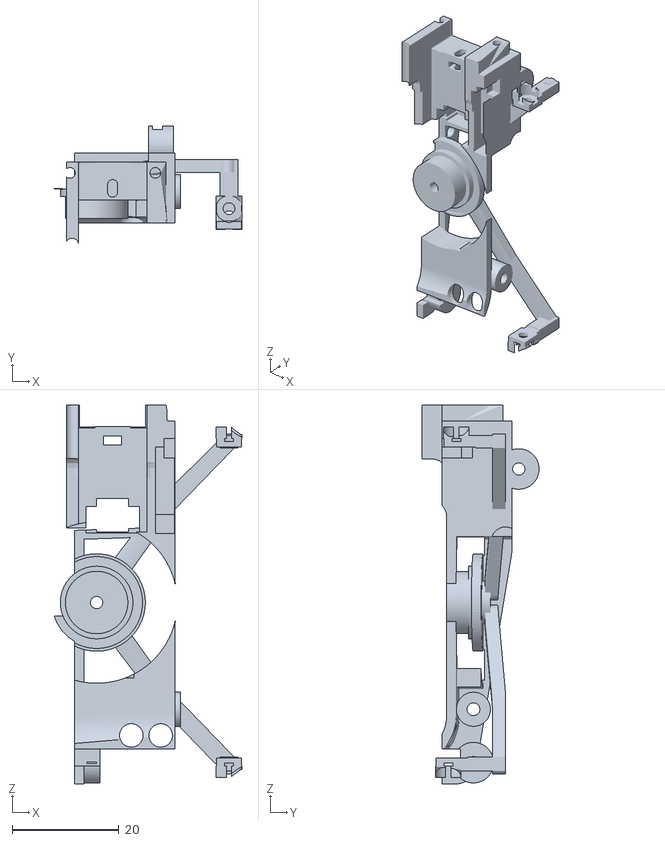
[picture p63: CAD file, 2026-11-03]
fabricacion/STL_POR_COLORES/NEGRO_PETG/69_V15_HEADROLL_CHEEK_DESMONTABLE.stl
35.2 x 22.0 x 71.0
