MTNRS/microduck-v15/fabricacion/STL_POR_COLORES/NEGRO_PETG/29_V7_SEPARADOR_EJE_CUELLO.stl

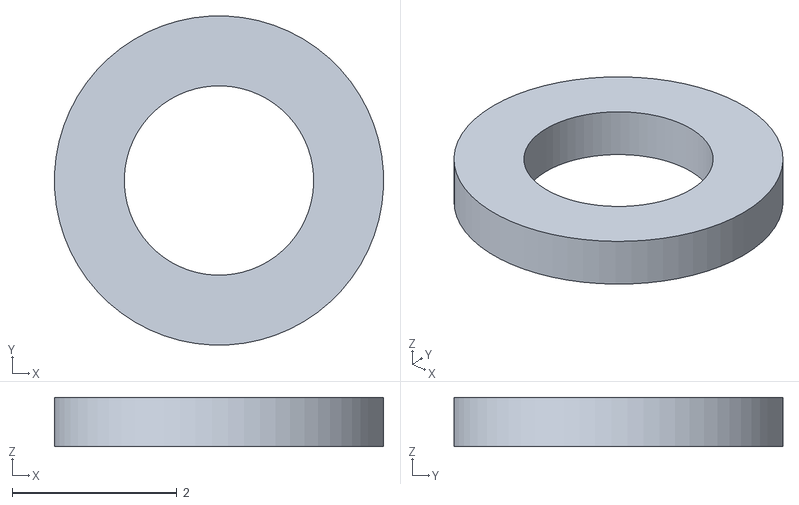
[picture p64: CAD file, 2026-11-03]
fabricacion/STL_POR_COLORES/NEGRO_PETG/29_V7_SEPARADOR_EJE_CUELLO.stl
4.00 x 4.00 x 0.6
