MTNRS/microduck-v15/fabricacion/STL_POR_COLORES/NEGRO_PETG/30_V7_RETENEDOR_PASIVO_HEADROLL.stl

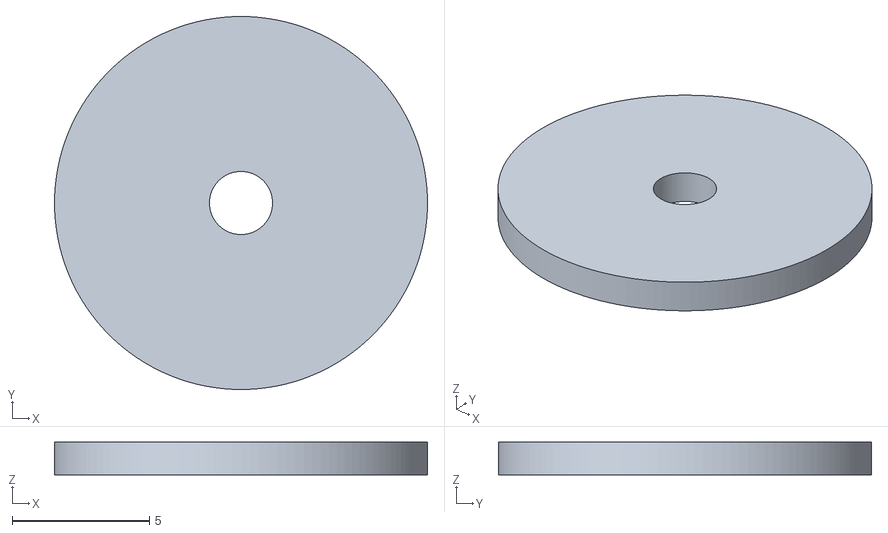
[picture p65: CAD file, 2026-11-03]
fabricacion/STL_POR_COLORES/NEGRO_PETG/30_V7_RETENEDOR_PASIVO_HEADROLL.stl
13.6 x 13.6 x 1.20
