MTNRS/microduck-v15/fabricacion/STL_POR_COLORES/NEGRO_PETG/79_V15_ET_RADIAL_CLAMP_08F.stl

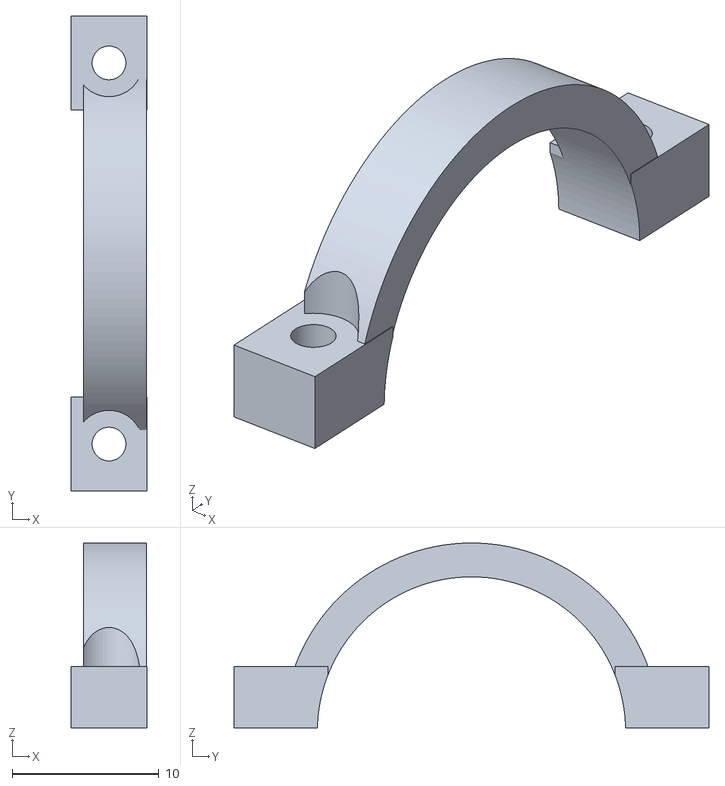
[picture p66: CAD file, 2026-11-03]
fabricacion/STL_POR_COLORES/NEGRO_PETG/79_V15_ET_RADIAL_CLAMP_08F.stl
5.20 x 32.4 x 12.6
