MTNRS/microduck-v15/(list of files, cad)

Other CAD files:
fabricacion/DOCUMENTACION/FR4/MINI_FR4_CORTE_TALADRO_mm.dxf
fabricacion/DOCUMENTACION/HERRAMIENTA_AF4/CONTRALLAVE_AF4_1mm.dxf
fabricacion/DOCUMENTACION/FR4/BM_FR4_CORTE_TALADRO_mm.dxf
fabricacion/STL_POR_COLORES/NEGRO_TPU_95A/41_V7_SRC_V4_MD_ankle_left__sole_left.stl
fabricacion/DOCUMENTACION/FR4/CONTROL_FR4_CORTE_TALADRO_mm.dxf
fabricacion/PROYECTOS_PRUSA_PAUSAS/P11_V7_MOD_UPPER_LEG_RIGHT_PAUSAS.3mf
fabricacion/STL_POR_COLORES/AZUL_CIELO_PETG/03_V7_MOD_UPPER_LEG_LEFT.stl
fabricacion/STL_POR_COLORES/NEGRO_PETG/21_V7_TAPA_BRAZO_07.stl
fabricacion/STL_POR_COLORES/AZUL_CIELO_PETG/11_V7_MOD_UPPER_LEG_RIGHT.stl
fabricacion/STL_POR_COLORES/NEGRO_PETG/75_V15_ET_RADIAL_CLAMP_12F.stl
fabricacion/STL_POR_COLORES/NEGRO_PETG/73_V15_ET_RADIAL_CLAMP_03F.stl
fabricacion/PROYECTOS_PRUSA_PAUSAS/P15_V7_TAPA_BRAZO_01_PAUSAS.3mf
fabricacion/PROYECTOS_PRUSA_PAUSAS/P12_V7_MOD_LEG_2_PAUSAS.3mf
fabricacion/STL_POR_COLORES/AZUL_CIELO_PETG/53_V15_SERVICE_FRONT_TRUNK_BASE_1.stl
fabricacion/STL_POR_COLORES/AZUL_CIELO_PETG/44_12CASE_TORSO_CONTINUO.stl
fabricacion/STL_POR_COLORES/NEGRO_PETG/55_V15_FOOT_L_HEEL_ACTUADOR.stl
fabricacion/STL_POR_COLORES/NEGRO_PETG/17_V7_TAPA_BRAZO_03.stl
fabricacion/STL_POR_COLORES/NEGRO_PETG/46_V15_SERVICE_FRONT_YAW2ROLL.stl
fabricacion/STL_POR_COLORES/NEGRO_PETG/71_V15_ET_RADIAL_CLAMP_01F.stl
fabricacion/STL_POR_COLORES/NEGRO_PETG/58_V15_FOOT_R_TOE_ACTUADOR.stl
fabricacion/STL_POR_COLORES/NEGRO_PETG/04_V7_MOD_LEG.stl
fabricacion/STL_POR_COLORES/NEGRO_PETG/70_V15_ET_RADIAL_CLAMP_00F.stl
fabricacion/STL_POR_COLORES/NEGRO_PETG/25_V7_TAPA_BRAZO_12.stl
fabricacion/STL_POR_COLORES/NEGRO_PETG/06_V7_MOD_NECK.stl
fabricacion/STL_POR_COLORES/NEGRO_PETG/32_V7_RETENEDOR_PASIVO_TOBILLO_14.stl
fabricacion/STL_POR_COLORES/NEGRO_PETG/12_V7_MOD_LEG_2.stl
fabricacion/STL_POR_COLORES/NEGRO_PETG/23_V7_TAPA_BRAZO_10.stl
fabricacion/STL_POR_COLORES/NEGRO_PETG/14_V7_TAPA_BRAZO_00.stl
fabricacion/STL_POR_COLORES/NEGRO_PETG/76_V15_ET_RADIAL_CLAMP_04F.stl
fabricacion/STL_POR_COLORES/NEGRO_PETG/09_V7_MOD_BEARING_ROLL.stl
fabricacion/STL_POR_COLORES/NEGRO_PETG/72_V15_ET_RADIAL_CLAMP_02F.stl
fabricacion/STL_POR_COLORES/NEGRO_PETG/15_V7_TAPA_BRAZO_01.stl
fabricacion/STL_POR_COLORES/NEGRO_PETG/16_V7_TAPA_BRAZO_02.stl
fabricacion/STL_POR_COLORES/NEGRO_PETG/60_V15_FOOT_R_TAPA_CIRCUITO.stl
fabricacion/STL_POR_COLORES/NEGRO_PETG/02_V7_MOD_HIP_L.stl
