MTNRS/microduck-v15/fabricacion/DOCUMENTACION/DAG_MONTAJE_ELECTRONICA_V15.md

# Montaje nominal de la electrónica V15

La tapa trasera se trabaja **fuera del robot, sin batería conectada**. Este orden evita capturar placas detrás de otras. La geometría congelada de POWER es `POWER_MONTABLE_STAGE_FREEZE_V15.json` (aa269bde…), completada por los deltas K10 de `PACK_SERVICE`, BM y `PCM_TWO_FRONT_CLIPS_OVERLAY_V15.json`. Root debe volver a comprobar sus rutas contra la composición final. El encaje nominal no sustituye el ensayo de tolerancias, herramienta, apriete, corriente y protección de la primera unidad.

## Orden obligatorio

1. **Preparar las tuercas accesibles en la tapa vacía.** Precargar las cuatro de MINI, las dos de los postes inferiores ADC, las dos de los clips PCM y las de fijación de las bandejas. Conservar las cuatro tuercas/arandelas traseras PCA para colocarlas **después de cerrar los clips PCM y antes de presentar PCA**. Las diez ventanas de tuerca originales se verificaron en `REAR_LOWER_ONLY_NUT_ACCESS_OVERLAY_V15.json`; los nuevos clips PCM tienen sus propios alojamientos.
2. **Placa de control FR4 con 2N3906 y resistores.** Con ADC, BM, K10, PCM, D24, PCA y PDB fuera, presentar la placa desde +X elevada **9 mm en Z**, retroceder a su X final y bajar 9 mm. Colocar sus dos M2x8 desde la cámara trasera, antes de que K10 ocupe ese espacio. El acceso nominal de una herramienta acodada se documenta en `CONTROL_TOOL_AND_BM_ORDER_V15.json`; comprobar que la punta real corresponde a la cabeza comprada. No puede mantenerse esta operación para después de instalar K10.
3. **BM: header B3B-XH-A, FR4, llave y cap.** Instalar este conjunto antes de ADC/PCA/PDB. Su trayectoria es [25,−8,−8.9] → [0,−8,−8.9] → [0,−8,0] → [0,0,0] mm. Puede hacerse después del control: todo el grupo de control tiene Y≤10.5 y el mínimo continuo del conjunto BM es Y≥12.6, separación ≥2.1 mm. Usar las piezas y el único SSH-M2-8 del overlay BM final; no montar una supuesta contraparte XH inline.
4. **MINI y reed.** Fijar el portafusible y su FR4 con sus cuatro M2x8, y el reed con `V15_REED_TAPA_PROTECTORA`/su M2x8. Aislar bornes y soldaduras antes de cerrar; no presionar vidrio ni cable contra la celda. Las salidas y el arnés completo todavía requieren preparación y ensayo físicos.
5. **HP por debajo, con la tapa inferior única desmontada.** La revisión final `PACK_SERVICE/OVERLAY_TAPA_INFERIOR_UNICA_V15.json` fusiona el antiguo hatch HP y la bandeja D24 en **un panel curvo único**, sin hardware adicional. Para retirarlo se quitan **tres M2: dos D24 y el M2 HP**; este último se conserva. Introducir la PCB HP verticalmente desde abajo (+Z) por su abertura y mantenerla en sus guías durante el resto del montaje. La retención definitiva de HP queda incorporada al panel común. El informe previo `HP_BOTTOM_SERVICE_HATCH_OVERLAY_V15.json` acredita PCB+componentes; la revisión final acredita el panel único.
6. **K10 desde abajo.** Retirar la bandeja inferior D24/K10 y dejar **PCM y D24 fuera**. Introducir el pack terminado y aislado por el paso que define `PACK_SERVICE`; fijar su retén según ese informe. No intentar introducirlo por delante de los postes/control. El pack debe respetar el máximo del constructor, incluidos aislamiento y pestañas, y no tener puntas ni soldaduras expuestas.
7. **PCM desde abajo, después del pack.** Mantener D24/bandeja fuera y los dos clips PCM quitados. Subir el módulo a su posición horizontal, sin mover K10. Su top134.5 queda por debajo del pack134.9. La prueba `PCM_TWO_ROUTE_SCREEN_V15.json` usa la tapa real posterior al corte K10: +Z60 libre; +X **no es una ruta válida**.
8. **ADC y soporte desmontable.** Precargar sus dos tuercas superiores (índices **0 y 1**, no 1 y 3) en `V15_ADC_CARRIER_DESMONTABLE`. Presentar soporte y placa desde +X con los cuatro tornillos frontales quitados; después montar los cuatro M2x8. Los dos inferiores fijan soporte+tapa: arandela/tuerca traseras se desplazaron −1.4X y la parte fija de apriete mide1.4 mm. No sustituir por M2x10: ese ensayo invadía PCM. Fuente: `CONTROL_ADC_PCM_SUBASSEMBLY_ROUTES_V15.json`.
9. **Dos clips PCM independientes.** Colocar `V15_PCM_TOPE_DESMONTABLE` y `V15_PCM_TOPE_DESMONTABLE_DERECHO` desde +X. Usar los mismos dos M2x8 reorientados de eje−X, cabeza al frente (underheadX−32.2; Y−26/+24; Z132.3). Cada clip retiene3.2 mm del borde frontal PCM. La entrada continua +X60 y los útiles frontales Ø3×60 están libres. No reinstalar el antiguo puente central. No hay hardware adicional por esta división.
10. **D24 preensamblado en el panel inferior único.** Con `V15_D24_BANDEJA_INFERIOR_DESMONTABLE` fuera del robot, precargar sus cuatro tuercas y montar la PCB con sus cuatro M2x8 originales. Los cuatro asientos y sus poses siguen presentes. Subir panel+PCB desde abajo, **después de K10 y PCM**, y apretar **sus tres fijaciones: dos M2x8 D24 en X−59/Y±30 y el M2x8 HP conservado**. Esta operación también cierra la retención HP. El conjunto panel+PCB+cuatro stacks sale50 mm hacia abajo con barrido continuo0 en `PACK_SERVICE/OVERLAY_TAPA_INFERIOR_UNICA_V15.json`. Los cuatro puertos Ø4.6 permiten acceder a los tornillos D24; los puertos de retención sirven al panel común. Los sectores de montaje dentro de la caja conservadora de componentes D24 son contactos documentados, no evidencia de que se haya medido la placa real.
11. **PCA desde el frente.** Precargar sus cuatro tuercas/arandelas traseras. Soldar primero los pigtails señal con R7 retirado y pullup OE; apartar suavemente los cables durante entrada. Con PDB ausente, presentar PCB+IC+C1 desde +X y fijar sus cuatro M2x8. El asiento axial real es **2.38 mm**; sus cuatro arandelas/tuercas traseras avanzaron +0.02X; las cabezas, PCB y arandelas delanteras conservan pose. Barrido rígido +X60 libre en `PCA_PDB_FRONT_ENTRY_V15.json`.
12. **PDB al final.** Presentar la placa goBILDA completa desde +X sobre sus dos collares inferiores Ø3.6/ID2.3×0.8. Instalar los dos M2x18 inferiores, cada uno con dos arandelas fender OD6/ID2.2×0.5 y tuerca M2. **No hay separadores metálicos ni guías superiores**: el hombro PETG integral mide3.4 mm. Sujetar el conjunto al enchufar y desenchufar. Conectar después los quince adaptadores de potencia y sus señales independientes.
13. **D36 y cierre del robot.** D36 pertenece a FRONT y se instala antes de MG00/01. Su ruta verificada levanta2.95Z y retira−X110; servicio inverso requiere retirar ambos servos de cadera y sus tapas. Sus dos superficies de apoyo se conservaron; los cuatro útiles de oreja Ø3 no tocan D36 (`MECHANICAL/HIP_SERVO_DRIVERS_VS_D36_V15.json`). Presentar el módulo trasero completo sólo tras desconectar los quince servo/Y y la entrada PDB, mantener cables fuera de las juntas y seguir la trayectoria final de `PACK_SERVICE`/composición.

## Dependencias resumidas

`tuercas → control → BM → K10 → PCM → ADC → clips PCM → bandeja D24 → PCA → PDB → enchufes → cierre`

HP/MINI/reed pueden prepararse antes de K10 mientras los accesos estén libres. En servicio se invierte la dependencia de la pieza afectada; **no se afirma que todo componente pueda extraerse independientemente**. D36 exige desmontaje de caderas; el pack exige desconectar alimentación, retirar el módulo trasero y la bandeja D24/PCM correspondiente.

## Límites que siguen separados del montaje nominal

- Las trayectorias rígidas no verifican el movimiento completo de los cinco cables de batería ni de los quince pigtails. Se conservan sus reservas operativas; las salidas de fábrica y el arnés terminado deben medirse y sujetarse antes de energizar.
- Preparar el pack soldado por un constructor competente; cargar extraído y completamente desconectado. El puerto de balance crudo no debe puentear B− con P− a través del robot. Seguir `PORT_PLAN_K10_V15.md`.
- OE usa **BCM5/pin29**, ALERT BCM17/pin11; conservar pies BCM22/27. Pi Zero2W recibe sólo5V regulados D36 en pin2 yGND pin6, nunca VBAT2S. Los switches de pie finales son **Omron SS-01-E**.
- El ensayo de corte por celda, ADC→OFF, polaridad, fusible, consumo simultáneo, regulación bajo carga, retención del pack y ajuste FDM continúa siendo ensayo de la primera unidad. Estos informes no certifican seguridad eléctrica ni fuerza mecánica.
