MTNRS/microduck-v15/fabricacion/DOCUMENTACION/MONTAJE_POR_SUBMODULOS_V15_FINAL.md

# Montaje mecánico por submódulos · Microduck V15

Aplica al kit `d1e061923094f4cd2fcfbbeb800a2daeffc9b78ee9077f8575ebd8b72b0ccbb4`. Empieza por [las probetas y los pilotos](../PROBETAS_PRIMERO/LEER_PRIMERO.txt). Las pausas de [la guía](GUIA_IMPRESION_Y_MONTAJE_V15.html) corresponden a los STL suministrados: 9 piezas, 12 paradas y 26 tuercas ya incluidas en la BOM. Conserva orientación, primera capa y capas de 0,2 mm, sin balsa en esas 9 piezas. Los signos +X/+Z siguientes se refieren al marco local del motor, no a los ejes de la cama.

1. **Primero D36.** Fíjalo en sus asientos del cuerpo delantero antes de insertar MG00 o MG01. Prepara el resto por submódulos en el banco, con las tapas de entrada retiradas. No instales todos los servos y cierres las tapas de una vez: perderías acceso a varios tornillos centrales.
2. **Cartuchos 00, 01, 02, 10 y 11.** Con el cartucho fuera, precarga el brazo OEM completo, incluido el cubo, en el receptor desde +Z. Precarga las tuercas M2 por el canal +X de la base. En CAP00, CAP01 y CAP10, introduce arandelas y tornillos de tapa por sus accesos laterales: presenta el tornillo 6 mm elevado y bájalo por su guía. En CAP02 y CAP11 las arandelas y tornillos de tapa se presentan axialmente desde +Z. Cierra el cartucho axialmente y aprieta sus dos tornillos con el útil accesible, antes del motor o tapa que ocupe el hueco. Para CAP00/01/10 se comprobó llave en L AF1,5, vástago de hasta Ø2 mm, tramo de 15,6 mm hasta el codo y brazo de 45 mm, con espacio para un giro de 60°.
3. **Cinco tornillos centrales OEM.** Coloca cada tornillo desde +Z y usa la punta que corresponda al tornillo del lote, en un útil con envolvente Ø3 mm. Aprieta el central **00 antes de MG02** en CAP00; **01 antes de MG11** en CAP01; **10 antes de MG08** en CAP10. Los centrales **02 y 11** se aprietan también en banco antes de unir su receptor a los módulos de pierna y cerrar las tapas. Sus pruebas no identifican un motor vecino específico. El tornillo OEM y los dos M2 de tapa cumplen funciones distintas.
4. **Apoyos y brazos invertidos.** En banco, con la mitad desmontable, el journal del otro cuerpo y su motor fuera, presenta el rodamiento por −Z en 04, 08, 10 delantero y 13. Para las mitades desmontables 04/13 se usa el acceso radial +X; para 10 delantero, +Y en el marco MG10; para 08, se conserva el acceso axial −Z. Los brazos 04 y 13 se precargan lateralmente desde +X con su CAP original ya colocado. También entran desde +X los brazos 03, 05, 12 y 14. Los brazos 07/08 se precargan desde +Z en el receptor, con las tapas y el journal que cerrarían esa entrada aún fuera. En 06 se retiran las dos tapas enrasadas: 623ZZ desde −Z y brazo desde +Z.
5. **Pasivo 10R antes de MG08/MG10.** Precarga el M2 del retén P30 desde +Z con CAP10 vacío y presenta su tuerca con la mejilla P69 fuera del conjunto. Carga el 6701ZZ y la mitad P80 desde +Z, antes de acoplar la mejilla/journal. Mantén fuera MG08, MG10 y el brazo 10 mientras compruebas el acceso de apriete AF1,5 desde −Z. El tornillo completo no entra por el lado de ese útil. No fuerces el acoplamiento atravesando ambos apoyos cerrados. Sigue la BOM de la mejilla: sus fijaciones L8 y L10 son distintas.
6. **Cierre y prueba.** Los alojamientos normales 00/01/02/03/11/12 cargan el rodamiento por +Z. Apoya sólo el aro que recibe el ajuste. Monta las mitades y su tornillería en banco, antes de cerrar las cubiertas. Para las 16 tuercas sin captura hexagonal usa la contrallave metálica de `HERRAMIENTA_AF4/`: boca 4,1 mm, cabeza 5,7 mm y grosor máximo 1 mm. Prueba el útil real; el dibujo no acredita su resistencia. Comprueba retención axial, giro libre, cable sin pinzamiento y que el journal 08 resiste la carga del piloto antes de repetir las piezas. Los 12 tornillos CAP de 5,8 mm se preparan desde M2×6 y los M2×11 desde M2×12, según su línea de BOM.

No enchufes MG09: la mandíbula es fija y el canal 14 queda deshabilitado. El límite de diseño de ambos roll de cadera es ±10° desde STAND. La comprobación de 85 poses dentro del alcance conserva los contactos numéricos y acredita ausencia de contactos profundos a la escala declarada de 0,01 mm; no valida todo el espacio de movimientos ni la resistencia del robot montado. Comprueba el lote real y el arnés en la primera unidad antes de alimentar.
