MTNRS/microduck-v15/fabricacion/DOCUMENTACION/TORNILLERIA/TORNILLERIA_COMPRA_V15.md

# TornilleriaV15

Fuente: `evidencia-local/Jarvis/outputs/microduck-cuerpo-suave-v15/fabricacion-v15/KIT_V15_R2_FABRICACION/ASSEMBLY_FABRICACION_CANDIDATO_V15.json. SHA d1e061923094f4cd2fcfbbeb800a2daeffc9b78ee9077f8575ebd8b72b0ccbb4. Estado: PASS_INVENTORY`.
Los26 insertos de impresion ya pertenecen a las cantidades. No duplicarcompuestos;hardwareOEMincluido en15kitsMG90S.

|Tipo|Pieza/dimension|Cantidad|
|---|---|---:|
|BEARING|623ZZ 3x10x4: |1|
|BEARING|6700 OPEN 10x15x3 (abierto;H3,NOZZH4): |2|
|BEARING|6701ZZ 12x18x4 double metal shielded: |1|
|BEARING|6702ZZ 15x21x4 double metal shielded: |1|
|BEARING|ET2216 16x22x4: |9|
|HARD_SHIM|OD5 ID2.2 h0.2: |1|
|HARD_SHIM|OD5 ID2.2 h0.3: |13|
|HARD_SHIM|OD5 ID2.2 h0.35: |2|
|NUT|M1.6 AF3.2 h1.3: |30|
|NUT|M1.6 AF3.2 h1.3: M1.6 nut AF3.2 height1.3|4|
|NUT|M2 AF4 h1.6: |74|
|NUT|M2 AF4 h1.6: M2 hex nut AF4 height1.6|8|
|NUT|M2 AF4 h1.6: M2 nut AF4 h1.6|24|
|NUT|M2 AF4 h1.6: M2nutAF4/H1.6|20|
|NUT|M2 AF4 h1.6: M2nutAF4h1.6|1|
|NUT|M2 AF4 h1.6: M2nut_AF4_h1p6|2|
|NUT|M2 AF4 h1.6: nut_M2_AF4_h1p6|18|
|OEM_HORN|OEM MG90S two-arm horn span13.8 +/-0.2: Factoryspline/hub retained; nominalwidth5/thickness2.4/hubOD10.4; verifylot|2|
|OEM_HORN|OEM MG90S two-arm horn span13.8 +0/-0.2: Factoryspline/hub retained; nominalwidth5/thickness2.4/hubOD10.4; verifylot|1|
|OEM_HORN|OEM MG90S two-arm horn span14.8 max: Factoryspline/hub retained; nominalwidth5/thickness2.4/hubOD10.4; verifylot|7|
|OEM_HORN|OEM MG90S two-arm horn span18 +/-0.2: Factoryspline/hub retained; nominalwidth5/thickness2.4/hubOD10.4; verifylot|4|
|SCREW|M1.6x6: M1.6x6 machine screw, head OD<=3.2 height<=1.3; {"length_under_head_mm": 6}|4|
|SCREW|M1.6x6: headOD<=3.2 h<=1.6|30|
|SCREW|M2x10: headOD<=4.8 h<=2|9|
|SCREW|M2x10: headOD<=4.8 h<=2.0|3|
|SCREW|M2x10 NBK SSH-M2-10: NBK SSH-M2-10 socketflathead; {"length_under_head_mm": 10, "head_diameter_mm": 4, "head_height_mm": 1.1}|1|
|SCREW|M2x11: M2x11 pan/socket-head machine screw prepared from M2x12; {"length_under_head_mm": 11, "head_diameter_max_mm": 4, "head_height_max_mm": 1.6}|8|
|SCREW|M2x11: M2x11 socket screw prepared from12; {"length_under_head_mm": 11.0, "head_diameter_max_mm": 4.0, "head_height_max_mm": 2.0}|2|
|SCREW|M2x11: M2x11 socket screw prepared from12; {"length_under_head_mm": 11.0, "head_diameter_max_mm": 4.0, "head_height_max_mm": 2.0}|4|
|SCREW|M2x12: M2x12 socket screw; {"length_under_head_mm": 12.0, "head_diameter_max_mm": 4.0, "head_height_max_mm": 2.0}|16|
|SCREW|M2x18: headOD<=4.8 h<=2.0|2|
|SCREW|M2x18: screw_M2x18_head_D4_h1p6; {}|2|
|SCREW|M2x20: headOD<=4.8 h<=2.0|1|
|SCREW|M2x25: headOD<=4 h<=1.6|4|
|SCREW|M2x25: headOD<=4.8 h<=2.0|1|
|SCREW|M2x5.8: M2, Lbajo cabeza5.8, cabezaOD<=4/h<=2; stockM2x6; {"length_under_head_mm": 5.8, "head_diameter_max_mm": 4.0, "head_height_max_mm": 2.0}|12|
|SCREW|M2x6: headOD<=4 h<=2|15|
|SCREW|M2x6: headOD<=4.8 h<=2|2|
|SCREW|M2x6 NBK SSHS-M2-6-SD ultra-low small-head screw: NBK SSHS-M2-6-SD ultra-low small-head screw; {"length_under_head_mm": 6, "head_diameter_mm": 3.2, "head_height_mm": 1.1}|1|
|SCREW|M2x8: M2x8 headOD4/H2; {}|18|
|SCREW|M2x8: headOD<=4 h<=1.6|6|
|SCREW|M2x8: headOD<=4 h<=1.6; actualKIT five-positive-components dimensional check|4|
|SCREW|M2x8: headOD<=4 h<=2|2|
|SCREW|M2x8: headOD<=4.8 h<=2.0|9|
|SCREW|M2x8: screw_M2x8; {}|14|
|SCREW|M2x8: screw_M2x8_head_OD_le4_h_le1p6; {}|4|
|SCREW|M2x8 NBK SSH-M2-8: NBK SSH-M2-8 socketflathead; {"length_under_head_mm": 8, "head_diameter_mm": 4, "head_height_mm": 1.1}|1|
|SCREW|M2x8 NBK SSH-M2-8: SSH-M2-8; {"head_D_mm": 4.0, "head_H_mm": 1.1, "underhead_length_mm": 8.0}|1|
|SCREW|M2x8 NBK SSH-M2-8 ultra-low profile: NBK SSH-M2-8 ultra-low profile machine screw; {"length_under_head_mm": 8, "head_diameter_mm": 4, "head_height_mm": 1.1}|3|
|SLEEVE|OD2.98 ID2.1 L4 metal: Precisionmetalbushing;provider/preparationconfirm|1|
|SLEEVE|spacer_OD6_ID2p2_h1: spacer_OD6_ID2p2_h1|0|
|WASHER|M1.6 washer OD3.5 ID1.8 thickness0.3: M1.6 washer OD3.5 ID1.8 thickness0.3|4|
|WASHER|M2 smallseries flatwasher DIN433 nominalOD4.5 ID2.2 h0.3: M2 smallseries flatwasher DIN433 nominalOD4.5 ID2.2 h0.3|2|
|WASHER|M2 washer OD4.3 ID2.2 thickness0.3: M2 washer OD4.3 ID2.2 thickness0.3|16|
|WASHER|M2washerOD4.3h0.3: M2washerOD4.3h0.3|1|
|WASHER|OD4 ID1.8 h0.4: |30|
|WASHER|OD4.2 ID2.2 h0.3: |2|
|WASHER|OD4.2 ID2.2 h0.4: |29|
|WASHER|OD4.3 ID2.2 h0.3: |24|
|WASHER|OD5 ID2.2 h0.3: |40|
|WASHER|WASHER: washerOD4.2/ID2.2/h.3|20|
|WASHER|fenderwasher_OD6_ID2p2_h0p5: fenderwasher_OD6_ID2p2_h0p5|4|
|WASHER|washer OD4.3 ID2.2 h0.3: washer OD4.3 ID2.2 h0.3|44|
|WASHER|washer_OD4p3_ID2p15_h0p3: washer_OD4p3_ID2p15_h0p3|36|

Preparar laslongitudes especiales segun la columna preparation delCSV. Las arandelas ycasquillos conservan dimensiones; proveedor por confirmar. No se agreganM2x24/26historicos.

Porrosca:{'M2': 145, 'M1.6': 34}. Unknown:[]
