MTNRS/microduck-v15/fabricacion/DOCUMENTACION/REGISTRO_PRIMERA_UNIDAD.csv

comprobacion | resultado | medida_observacion | fecha | responsable
Probetas dimensionales | PENDIENTE
MG90S cuerpo/pestañas/estriado/horn del lote | PENDIENTE
Rodamientos y giro libre | PENDIENTE
Tuercas insertadas durante impresión | PENDIENTE
Inserción15servos/tapas/útil | PENDIENTE
Montaje contactos y topes de pies | PENDIENTE
Montaje placas frontales | PENDIENTE
Extracción módulo trasero/cables | PENDIENTE
Servicio tapa cabeza/microSD | PENDIENTE
Arnés en movimiento manual | PENDIENTE
Voltajes ypolaridad | PENDIENTE
OE seguro durante arranque/fallo | PENDIENTE
ADC aviso6.8/parada6.6V | PENDIENTE
PCM por celda | PENDIENTE
Consumo/temperatura carcasa cerrada | PENDIENTE
Resistencia de piezas/cargaTPU | PENDIENTE
Límites de cadaarticulación | PENDIENTE
Aceptaciónmontajeprimeraunidad | PENDIENTE
