MTNRS/microduck-v15/fabricacion/DOCUMENTACION/FR4/BM_FR4_TALADROS.csv

id | u_mm | v_mm | diametro_mm | uso
JST_PIN1 | 3.475 | 2.45 | 1.0 | NC aislado
JST_PIN2 | 3.475 | 4.95 | 1.0 | BM central
JST_PIN3 | 3.475 | 7.45 | 1.0 | NC aislado
