MTNRS/microduck-v15/fabricacion/DOCUMENTACION/FR4/CONTROL_FR4_TALADROS.csv

id | u_mm | v_mm | diametro_mm | uso
M2_LEFT | 3.5 | 4.7 | 2.2 | Fijacion M2
M2_RIGHT | 23.5 | 4.7 | 2.2 | Fijacion M2
