MTNRS/microduck-v15/fabricacion/DOCUMENTACION/VISTAS/V15_R2_lateral.png

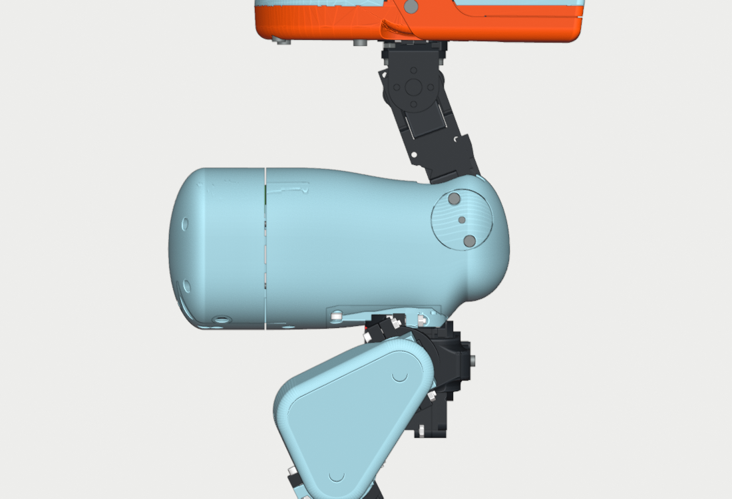
fabricacion/DOCUMENTACION/VISTAS/V15_R2_lateral.png
