MTNRS/microduck-v15/fabricacion/DOCUMENTACION/VISTAS/V15_R2_torso_trasero.png

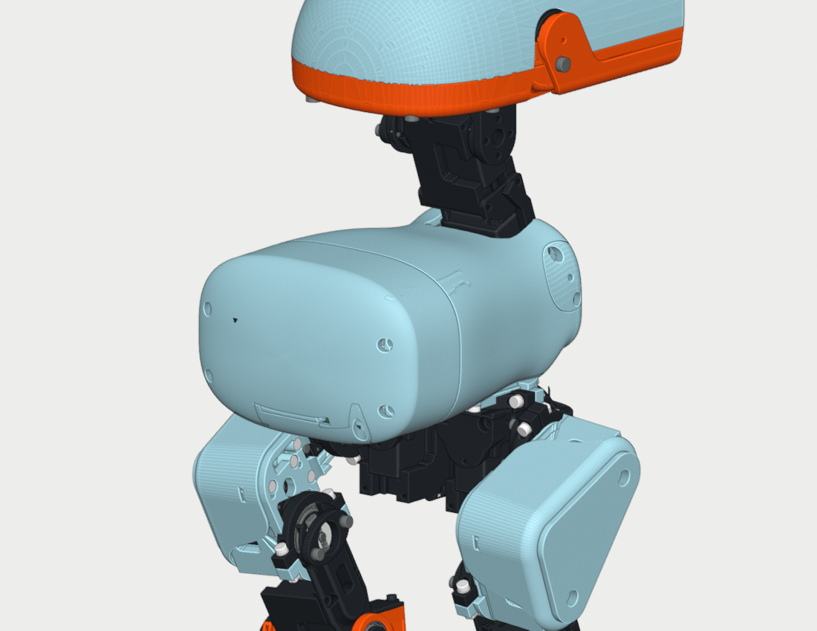
fabricacion/DOCUMENTACION/VISTAS/V15_R2_torso_trasero.png
