MTNRS/microduck-v15/verificacion/README.md

# Evidencias de Microduck V15 R2

La copia pública conserva los resultados de verificación y los SHA-256 registrados al ejecutar las pruebas de origen. Las rutas de esos recibos se han sustituido por nombres relativos bajo evidencia-local/. Esos nombres identifican entradas históricas del entorno de CAD y archivos auxiliares que pueden quedar fuera de la descarga pública.

Los hashes internos de los recibos se refieren a sus fuentes originales. Para comprobar los bytes incluidos en esta entrega, usa fabricacion/SHA256SUMS.txt y ejecuta python tools/verify_repo.py desde la raíz. Los STL, 3MF y PNG de fabricación se conservaron byte por byte al preparar la copia pública.

El alcance de cada comprobación consta en su recibo. Quedan por verificar la primera impresión, el montaje con los componentes del lote y los ensayos eléctricos y de movimiento bajo carga.
